docdent/pipe/README.md

# pipe
Midi pipe organ controller

Firmware for key processing of pipe organ that uses electric contacts
Hardware based on arduino mega
