docdent/pipe/docs/MidiProcessing V0.62.pdf

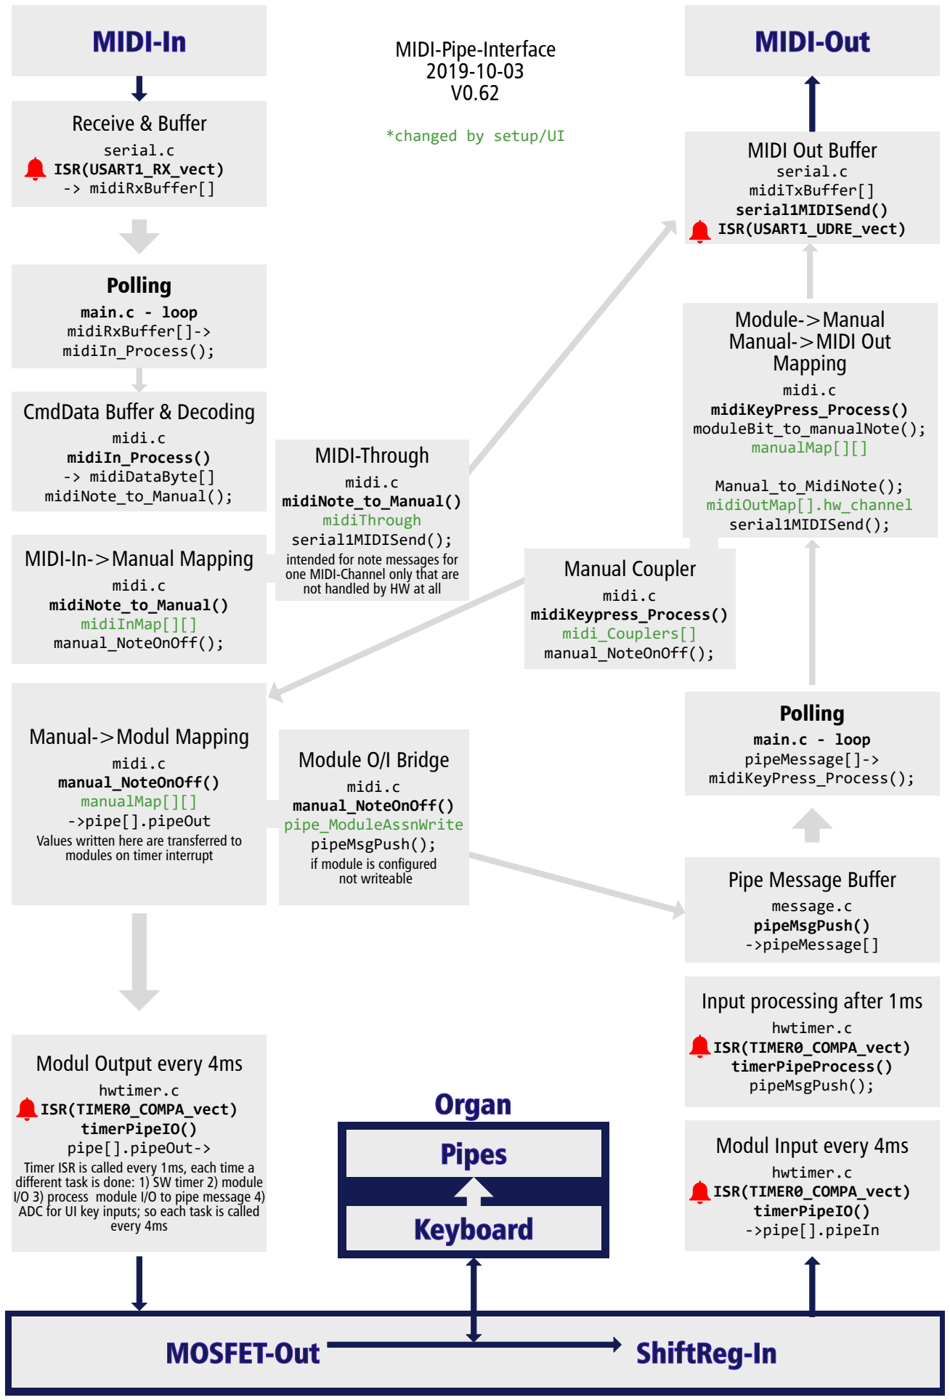
[picture p1: figure]
MIDI-In; MIDI-Out; MOSFET-Out; Pipes; Keyboard; ShiftReg-In; MIDI-In->Manual Mapping; midi.c midiNote_to_Manual() midiInMap[][] manual_NoteOnOff();; Manual->Modul Mapping; midi.c manual_NoteOnOff() manualMap[][] ->pipe[].pipeOut Values written here are transferred to modules on timer interrupt; Modul Output every 4ms; hwtimer.c ISR(TIMER0_COMPA_vect) timerPipeIO() pipe[].pipeOut->; every 4ms; Modul Input every 4ms; hwtimer.c ISR(TIMER0_COMPA_vect) timerPipeIO() ->pipe[].pipeIn; Input processing after 1ms; hwtimer.c ISR(TIMER0_COMPA_vect) timerPipeProcess() pipeMsgPush();; Pipe Message Buffer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

Timer ISR is called every 1ms, each time a different task is done: 1) SW timer 2) module I/O 3) process module I/O to pipe message 4) ADC for UI key inputs; so each task is called

Module Note: Due to HW design MOSFET activitation is treated as key press in SW, so processing continues here to upper right side
