docdent/pipe/docs/stuff/Din Lesewerte vom Pipie-Modul.xlsx

Modul vorhanden | OE | Dout | Magnet vorh | Taste gedr | Din(0-31) | Din(32)
nein | X | X | - | - | 1 | 1 | wenn pullup an Din
ja | 0 | X | 0 | 0 | 0 | immer 0
 | 0 | X | 0 | 1 | 1
 | 0 | X | 1 | 0 | 0
 | 0 | X | 1 | 1 | 1
 | 1 | 0 | X | X | 1
 | 1 | 1 | X | X | 1
