docdent/pipe/docs/Schematics/Pipe Block Diagram.pdf

## Block Diagram

2020-06-23

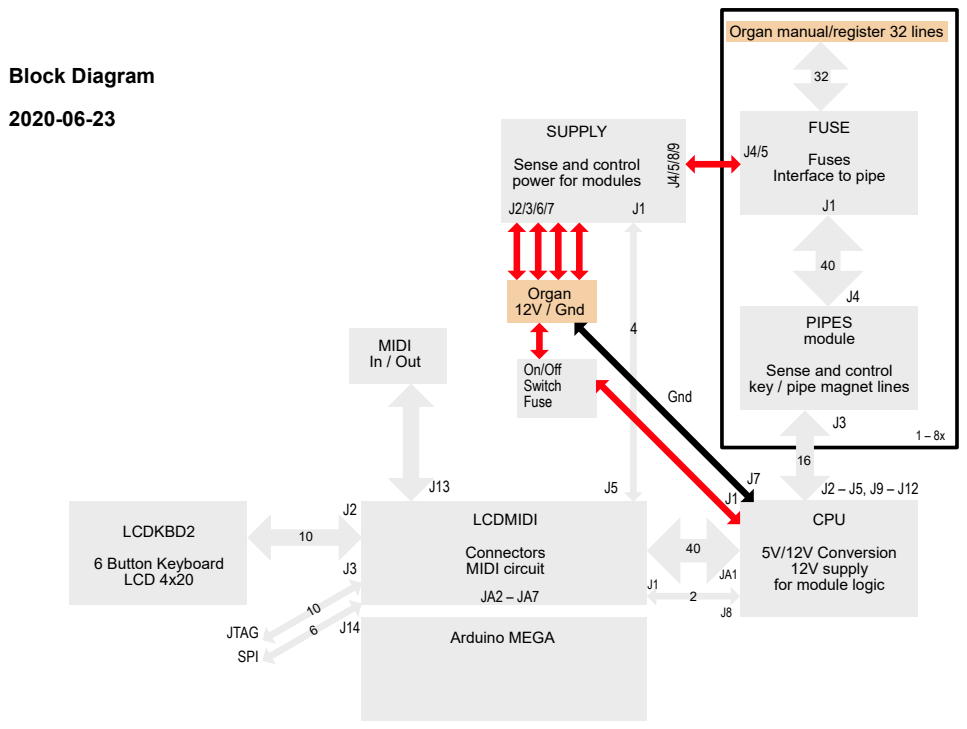
[picture p2: page 1]

Organ manual/register 32 lines

Sense and control
key / pipe magnet lines
