docdent/pipe/docs/Schematics/CPU1.6.pdf

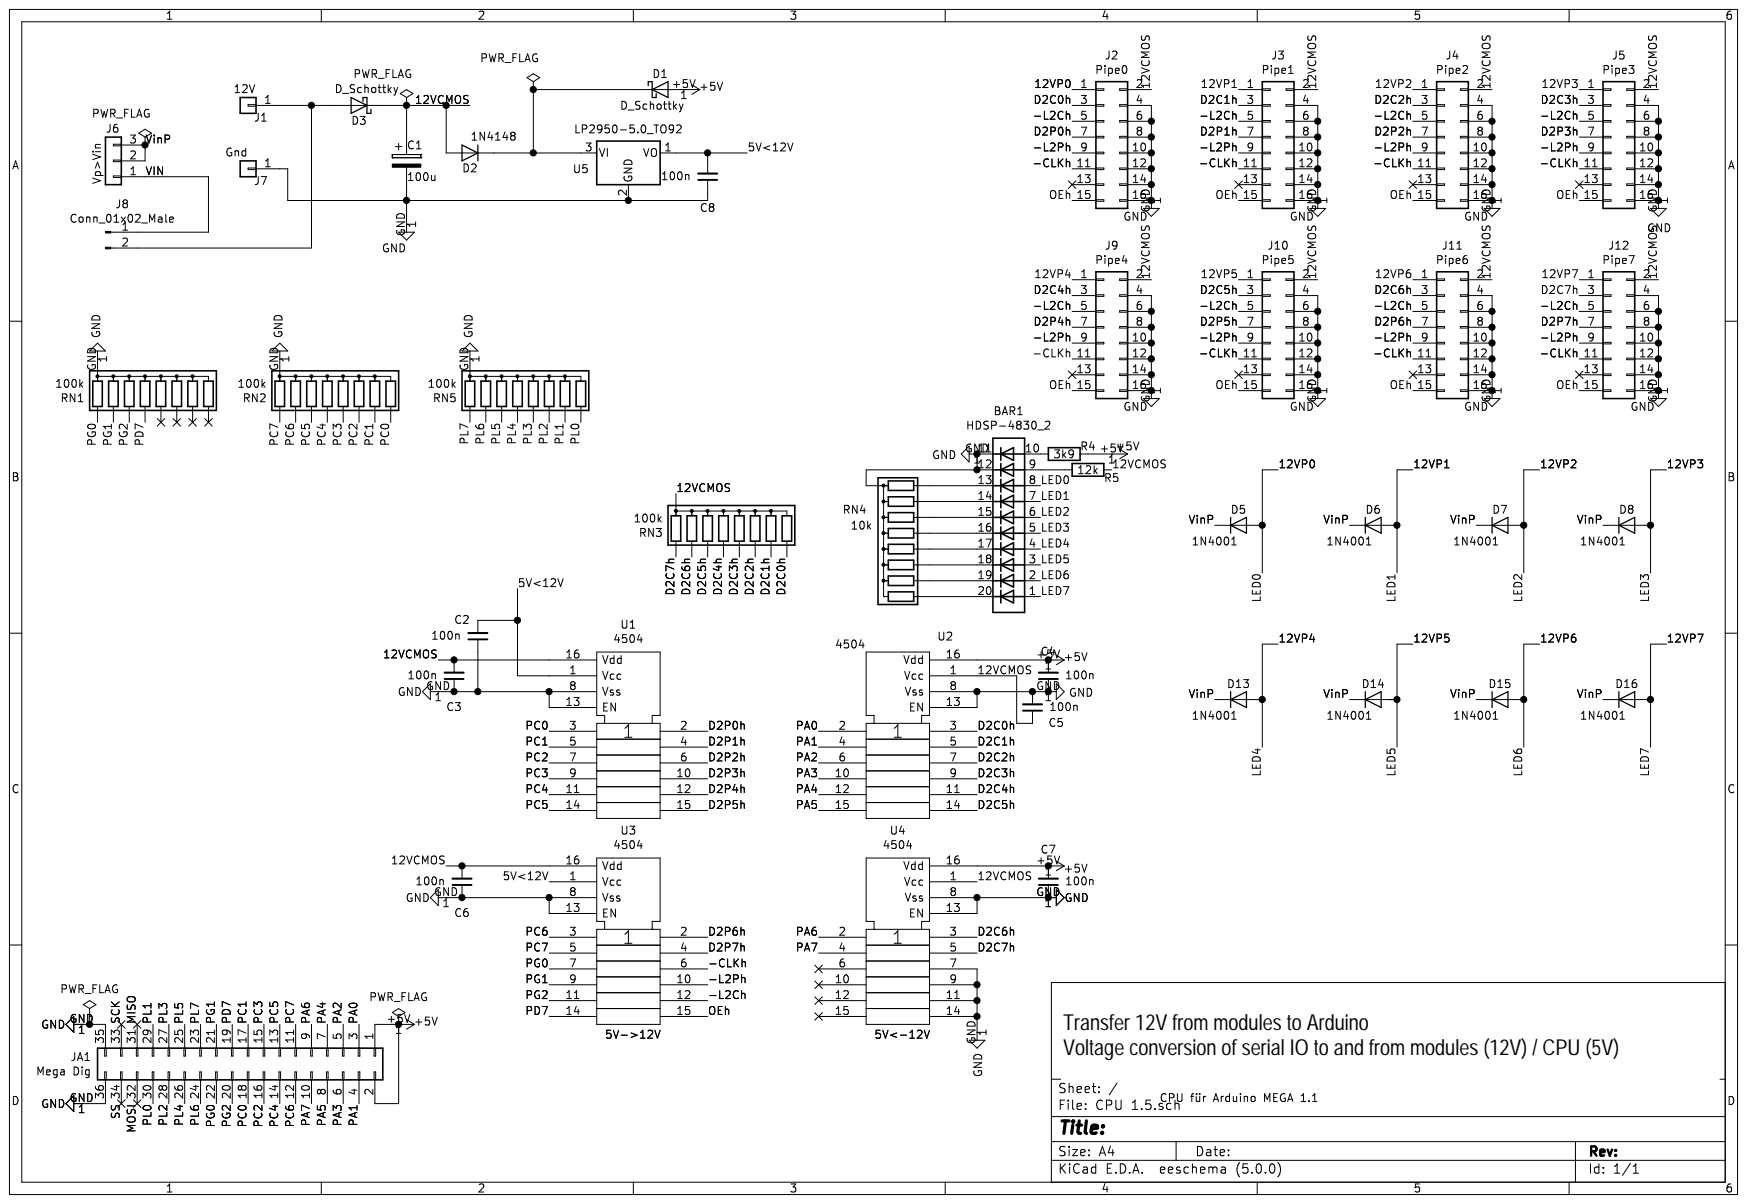
[picture p3: page 1]
