docdent/pipe/docs/Schematics/LCDMIDI.pdf

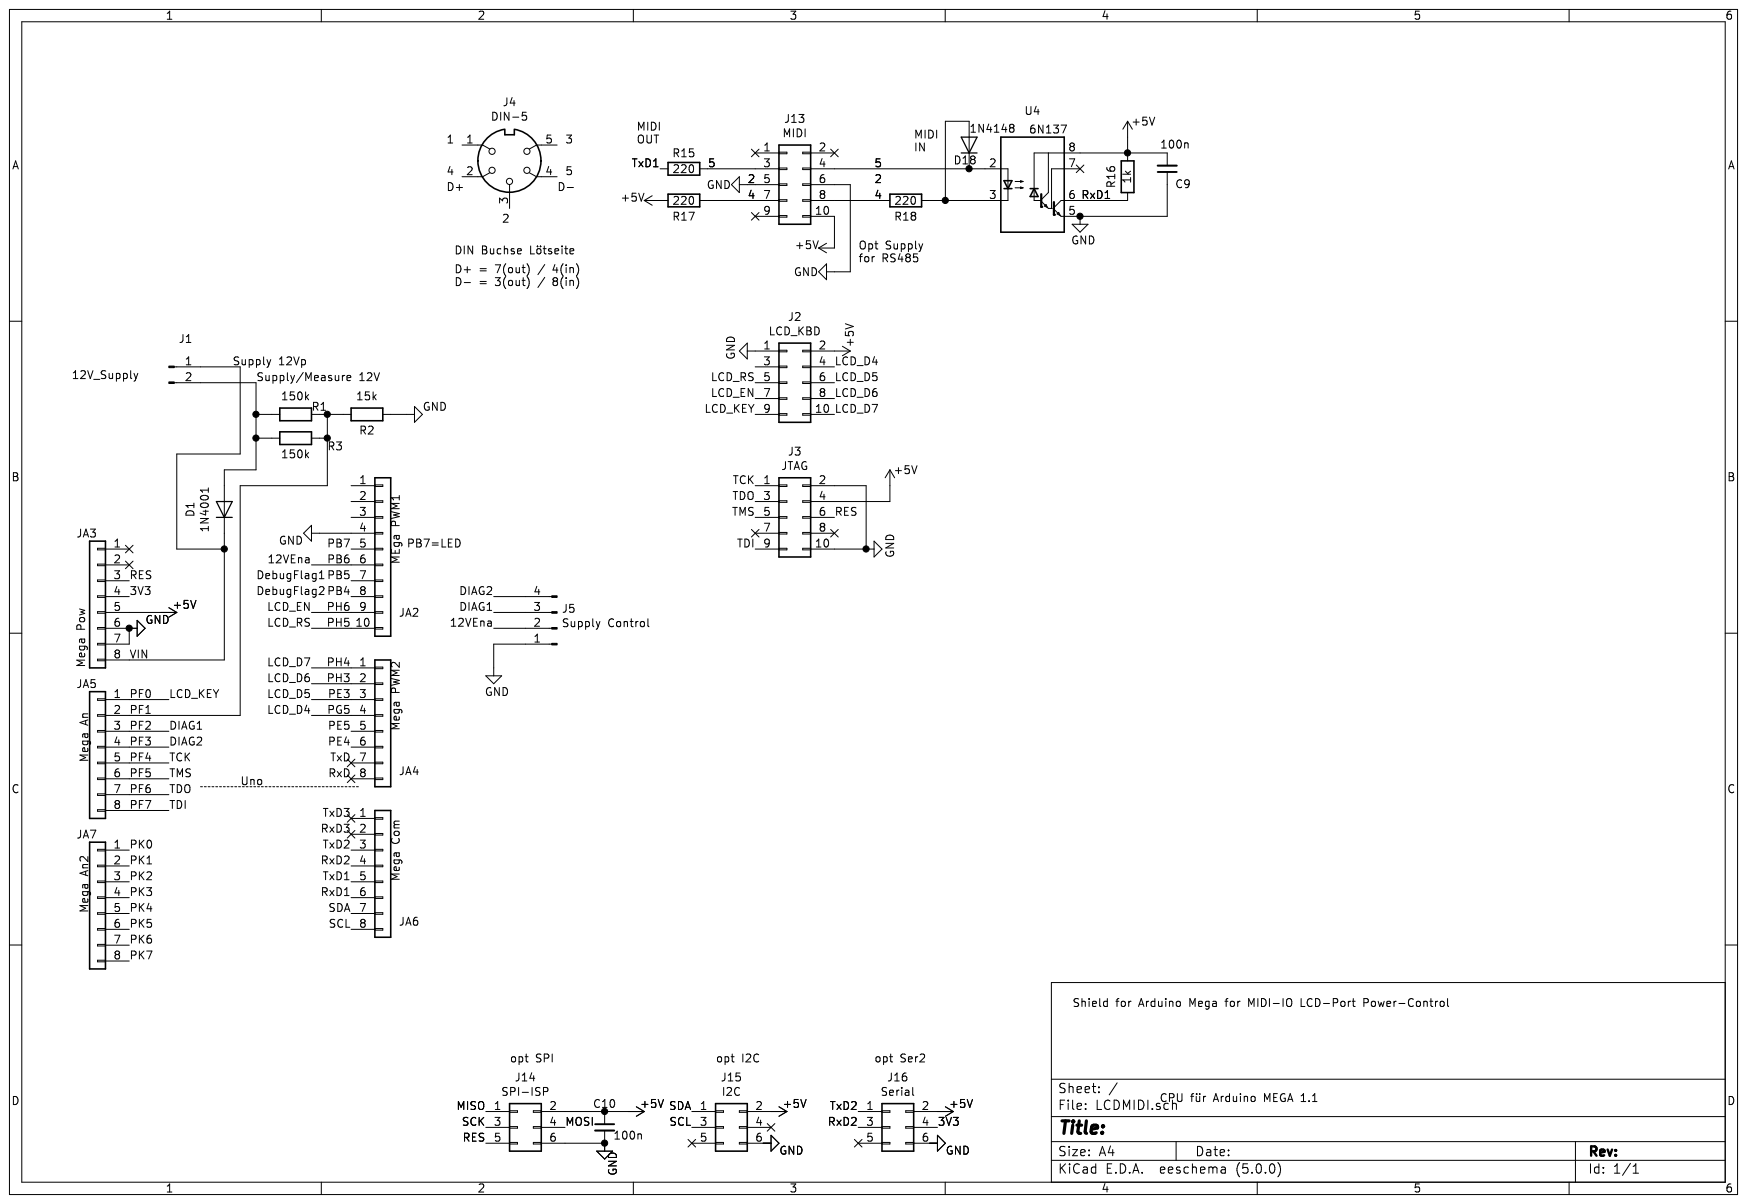
[picture p4: page 1]
