docdent/pipe/docs/Schematics/FUSE.pdf

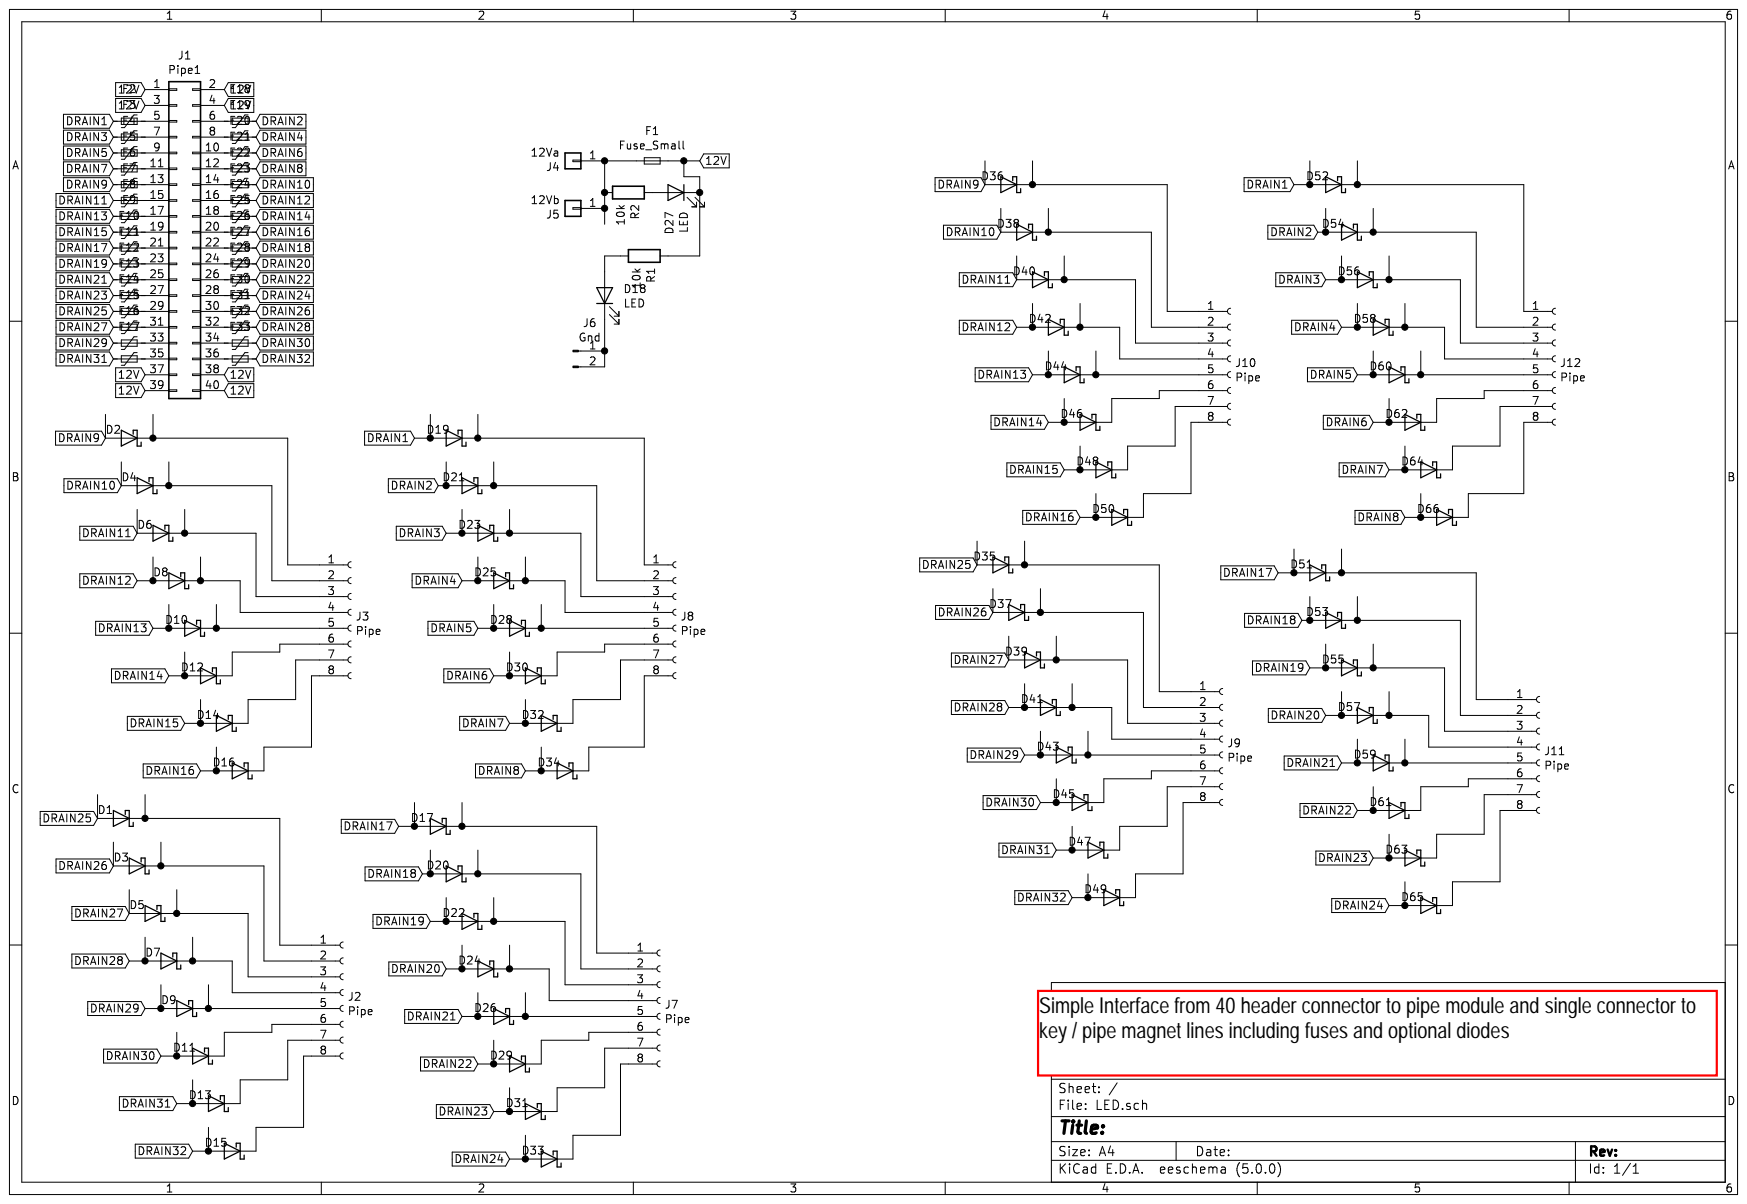
[picture p5: page 1]
