docdent/pipe/docs/Schematics/LCD_KBD2.pdf

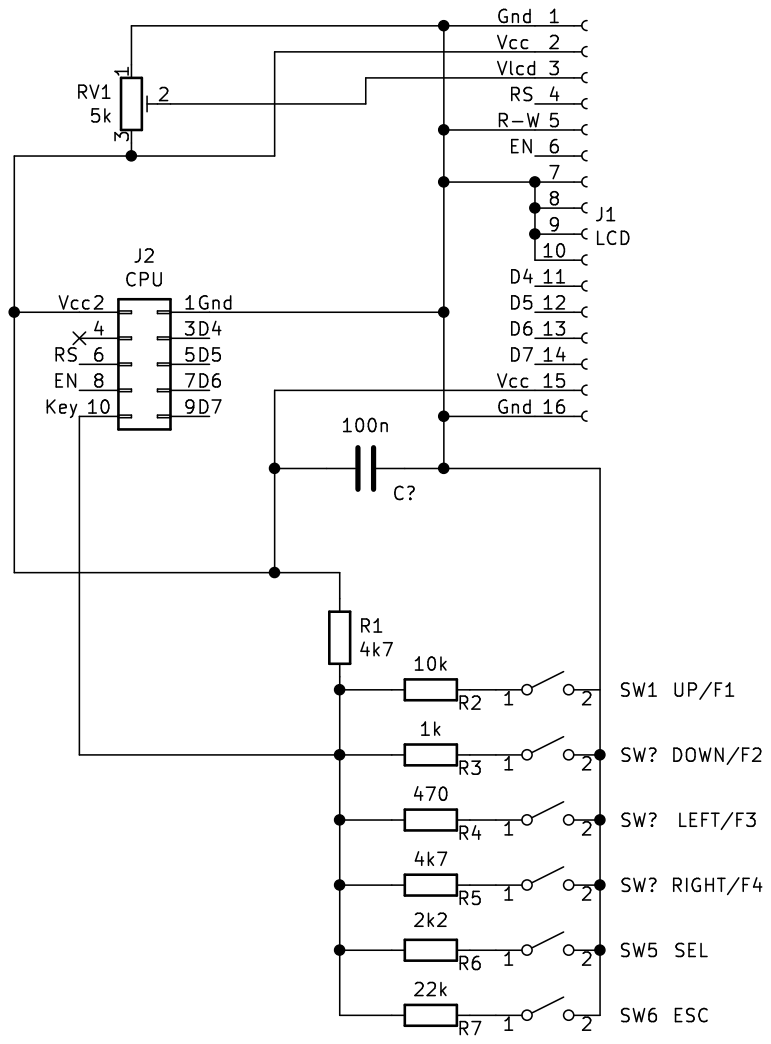
[picture p6: page 1]
