docdent/pipe/docs/Schematics/Pipes17.pdf

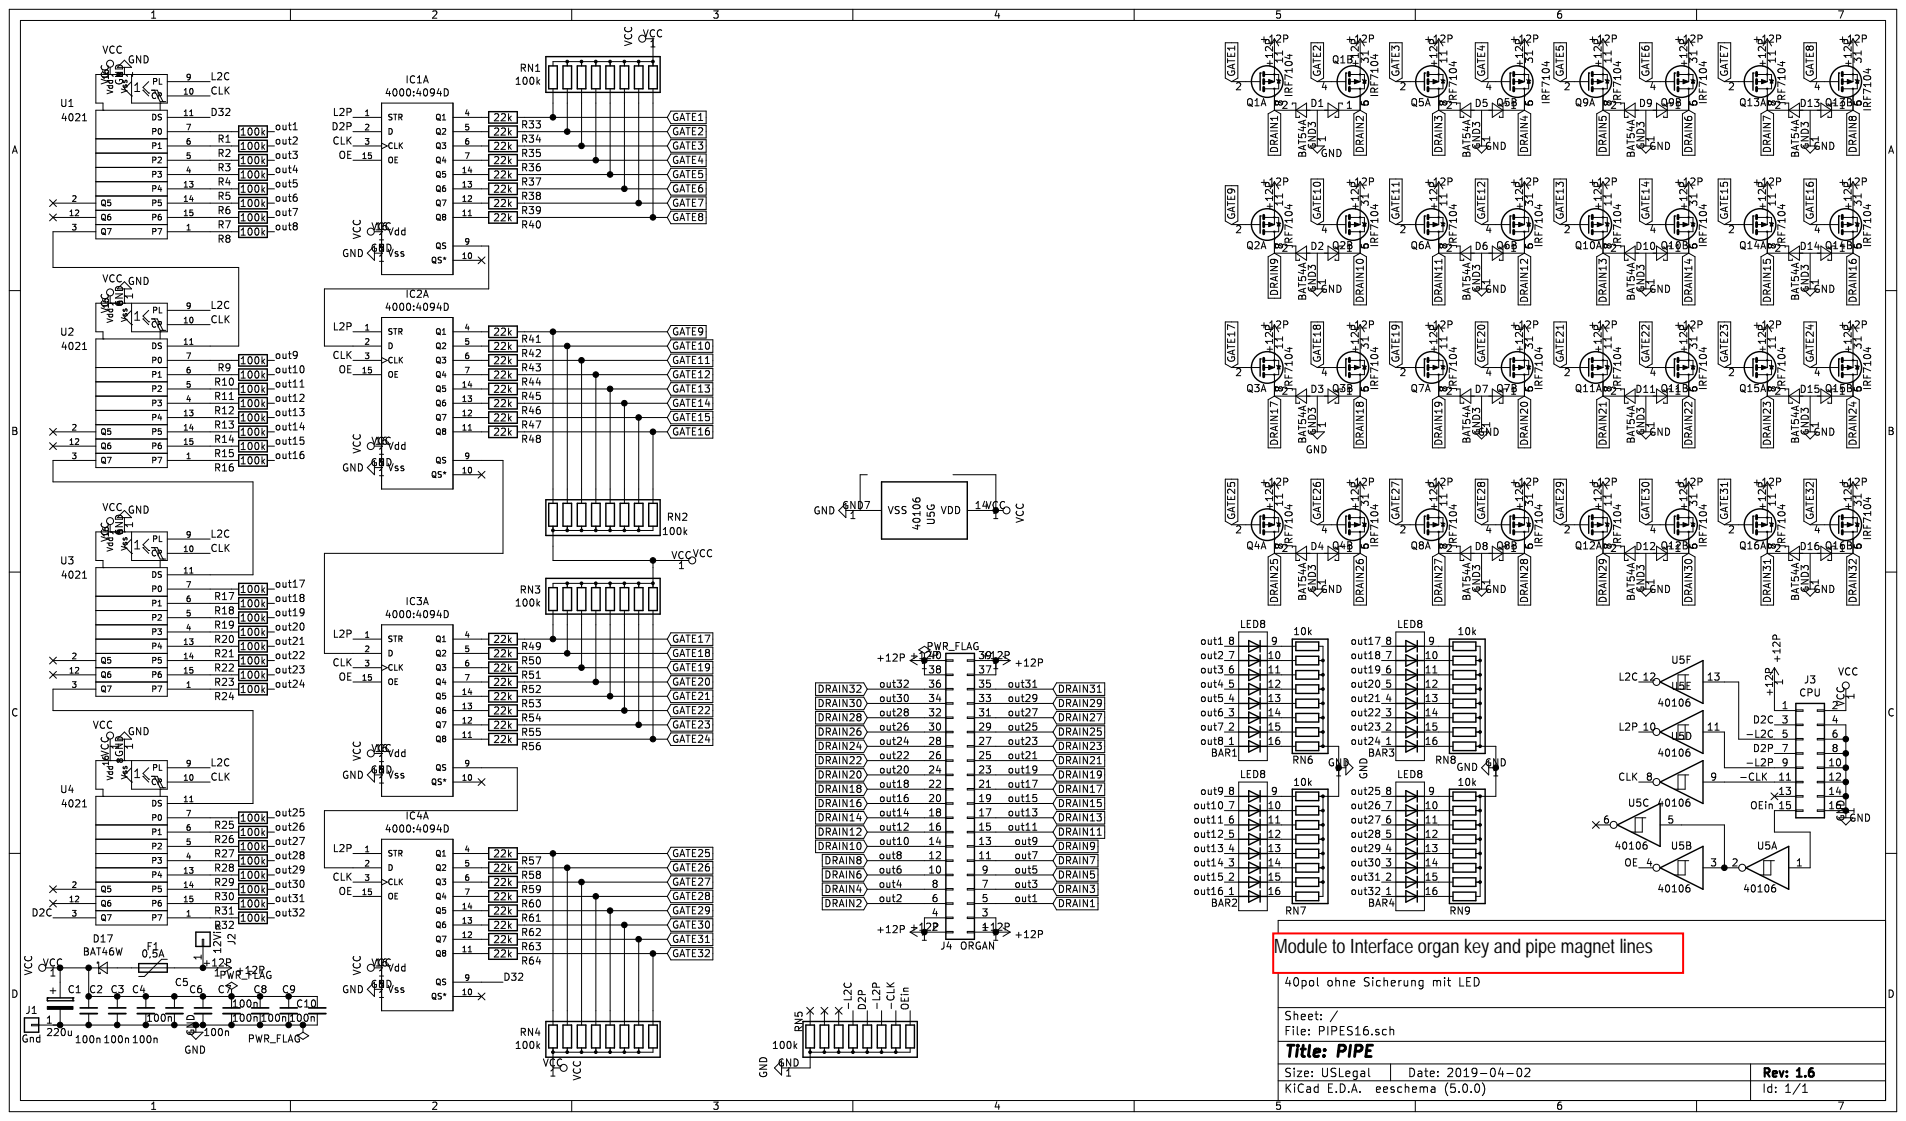
[picture p7: page 1]
