docdent/pipe/docs/Schematics/SUPPLY.pdf

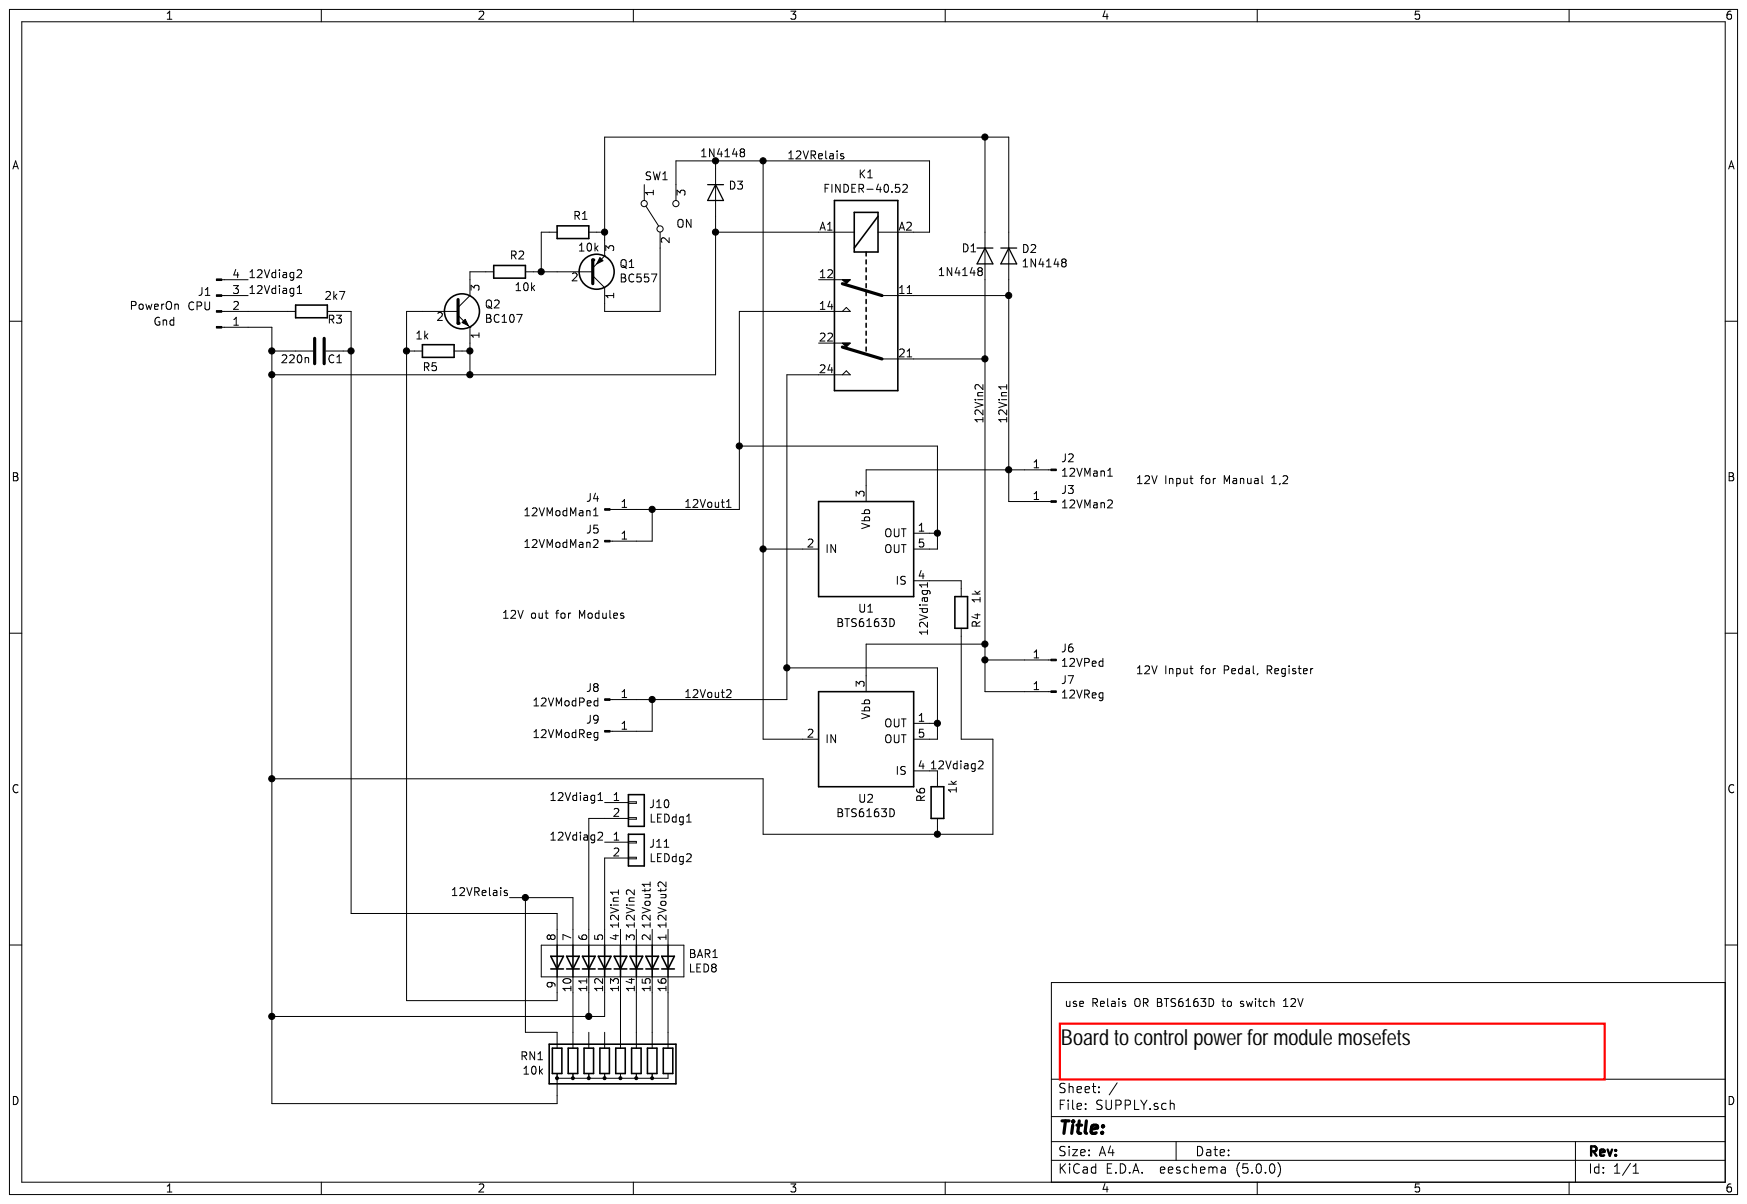
[picture p8: page 1]
