docdent/pipe/Pipe1/Midi.c

/* Midi.c
 *
 * Created: 31.01.2019 13:32:04
 *  Author: Anwender
 * Does processing of midi messages to and organ key messages from organ - handling bytes is not done here (->serial.c)
 */

#include <util/delay.h>
#include <avr/io.h>
#include <avr/interrupt.h>

#include "lcd_u.h"
#include "initio.h"
#include "message.h"
#include "hwtimer.h"
#include "utils.h"
#include "serial.h"
#include "test.h"
#include "Midi.h"
#include "ee_prom.h"
#include "log.h"




//-------------------------------------------------- V A R S ---------------------------------------


uint8_t midi_Couplers[COUPLER_COUNT];
const __flash CplInfo_t cplInfo[COUPLER_COUNT] = {
	// list of all couplers with destination and source manual
	{MANUAL_II, MANUAL_III},
	{MANUAL_I, MANUAL_III},
	{MANUAL_I, MANUAL_II},
	{MANUAL_P, MANUAL_III},
	{MANUAL_P, MANUAL_II},
	{MANUAL_P, MANUAL_I},
	{MANUAL_III, MANUAL_II},
	{MANUAL_III, MANUAL_I},
	{MANUAL_II, MANUAL_I},
	{MANUAL_III, MANUAL_P},
	{MANUAL_II, MANUAL_P},
	{MANUAL_I, MANUAL_P}
};

ManualMap_t manualMap[MANUAL_COUNT][RANGE_COUNT];
ManualNoteRange_t ManualNoteRange[MANUAL_COUNT];
MidiInMap_t midiInMap[MIDI_CHANNEL_COUNT][MIDI_SPLIT_COUNT];
MidiOutMap_t midiOutMap[MANUAL_COUNT];
uint8_t midiRxActivceSensing = 0;
MidiSetting_t midi_Setting; // active sense, sendVelocity=0 instead of NoteOff
uint8_t midiEEPromLoadError = EE_LOAD_OK;
RegisterMap_t registerMap[REGISTER_SEC_COUNT]; // for each Register section contains regStart, regEnd, modulBit
uint8_t registerCount; // nr of valid registers
ProgramInfo_t programMap[PROGRAM_COUNT]; // for each register one bit
MidiThrough_t midiThrough;
uint8_t midi_RegisterChanged; // for LCD Status
MidiCCreg_t midi_ccReg; // store MIDI CC number for register on/off midi commands

// ------------------------------------ M I D I   G E N E R A L --------------------------------------

void init_Midi(){
	midi_CouplerReset();
	prog_Display = PROGR_NONE;
	prog_UpdDisplay = FALSE;
}

void midi_CouplerReset(){
	// turn off all 12 couplers
	uint8_t* pCoupler = midi_Couplers;
	for (uint8_t i = 0; i < COUPLER_COUNT; i++){
		*pCoupler++ = 0;
	}
}

// ------------------------------------ C O U P L E R   S E T ---------------------------------

uint8_t set_Coupler(uint8_t cplNr){
	// returns MANUAL (!) if corrsponding inverse coupler had to be turned off, or MANUAL_NONE if no manual should be turned off
	if (cplNr < COUPLER_COUNT){
		midi_Couplers[cplNr] = COUPLER_ON;
		// calculate inverse Coupler in cplNr
		if (cplNr >= COUPLER_COUNT/2){
			// 6...11 -> 0...5
			cplNr = cplNr - COUPLER_COUNT/2;
		} else {
			// 0...5 -> 6...11
			cplNr = cplNr + COUPLER_COUNT/2;
		}
		if (midi_Couplers[cplNr] != 0){
			// reset inverse coupler and notify caller
			midi_Couplers[cplNr] = COUPLER_OFF;
			return cplInfo[cplNr].dest; // note to caller that this destination manual should be turned off
		}
	}
	return MANUAL_NONE;
}

Word_t getAllCouplers(){
	Word_t result;
	result.wordval = 0;
	uint8_t cplNr = COUPLER_COUNT-1;
	do
	{
		result.wordval = result.wordval << 1;
		if (midi_Couplers[cplNr] == COUPLER_ON) {
			result.byteval[0] |= 1; // LSB -> 1
		}
	} while (cplNr-- > 0);
	return result;
}

void setAllCouplers(Word_t couplers){
	uint8_t cplNr = 0;
	do
	{
		if ((couplers.byteval[0] & 0x01) != 0){
			midi_Couplers[cplNr] = COUPLER_ON;
		} else {
			midi_Couplers[cplNr] = COUPLER_OFF;
		}
		couplers.wordval = couplers.wordval >> 1;
	} while (++cplNr < COUPLER_COUNT);
}
//------------------------------------- M I D I    P R O C E S S I N G ---------------------------------

uint8_t midiLastCommand;
uint8_t midiDataByte[MIDI_MAX_INTERESTING_BYTES]; // max processed data bytes
uint8_t midiDataByteCount;
uint8_t midiDataByteExpected = MIDI_IGNORE_DATA; // Trigger processing after n received bytes - only proccesed commands!

uint8_t midiLastOutNote = MIDI_NOTE_NONE;
uint8_t midiLastOutManual = MANUAL_NONE;
uint8_t midiLastInNote = MIDI_NOTE_NONE; // written by midi.c read by main for debugging/display
uint8_t midiLastInChannel = MANUAL_NONE;
uint8_t midiLastInManual = MANUAL_NONE; // written by midi.c read by main for debugging/display
uint8_t midiLastProgram = MIDI_PROGRAM_NONE;


void manual_NoteOnOff(uint8_t manual, uint8_t note, uint8_t onOff);

//--------------------------------- G L O B A L   M I D I  M E S S A G E S ----------------------------------

void midiAllReset(){
	pipeProcessing = PIPE_IO_DISABLE; // do not process pipe[] now
	init_Pipe(); // defines IO, resets pipe[], here pipeProcessing will be activated again
}

void midiAllNotesOff(uint8_t channel){
	uint8_t splitRange = 0;
	while (splitRange < MIDI_SPLIT_COUNT){
		uint8_t manual = midiInMap[channel][splitRange].manual;
		// for all split ranges
		if (manual < MANUAL_COUNT) {
			// this splt range is assigned to a manual
			uint8_t note = midiInMap[channel][splitRange].manualNote; // start with this note
			// for all notes in split range
			for (uint8_t i = midiInMap[channel][splitRange].noteRange; i > 0; i--){
				manual_NoteOnOff(midiInMap[channel][splitRange].manual, note++, NOTE_OFF | NOTE_NOREDIRECT);
			}
			uint8_t midiChanel = midiOutMap[manual].hw_channel;
			if (midiChanel <= MIDI_CHANNEL_MAX){
				// valid channel, send all notes off
				serial1MIDISendCmd(MIDI_CTRLCHG, midiChanel);
				serial1MIDISendData(MIDI_CTRL_ALLNOTESOFF);
				serial1MIDISendData(0);

			}
		}
		// V 0.69 send all notes off to out channel of that manual
		// caution: all notes off ist sent to midi out even if multiple note off are also sent by HW via pipe_message
		// all notes off on midi out is not limited to note range of split range
		splitRange++;
	}
}

void midi_ManualOff(uint8_t manual){
	// turn all notes off of this manual
	if ((manual < MANUAL_COUNT) && (ManualNoteRange[manual].startNote != MIDI_NOTE_NONE) && (ManualNoteRange[manual].endNote != MIDI_NOTE_NONE)){
		for (uint8_t note = ManualNoteRange[manual].startNote; note <= ManualNoteRange[manual].endNote; note++){
			manual_NoteOnOff(manual,note,NOTE_OFF | NOTE_NOREDIRECT);
		}
	}
	// V 0.69 send all notes off to out channel of that manual
	uint8_t midiChanel = midiOutMap[manual].hw_channel;
	if (midiChanel <= MIDI_CHANNEL_MAX){
		// valid channel, send all notes off
		serial1MIDISendCmd(MIDI_CTRLCHG,midiChanel);
		serial1MIDISendData(MIDI_CTRL_ALLNOTESOFF);
		serial1MIDISendData(0);
	}
}

void midi_AllManualsOff(){
	for (uint8_t manual = 0; manual < MANUAL_COUNT; manual++){
		midi_ManualOff(manual);
	}
}

//----------------------------- A C T I V E   S E N S E ----------------------------------

void midi_CheckRxActiveSense(){
	if (midiRxActivceSensing != 0){
		// only when activated
		if (TIMER_ELAPSED(TIMER_ACTIVESENSE)) {
			// watchdog for active sense is elapsed: shut down outputs!
			midi_AllManualsOff();
			midiRxActivceSensing = 0; // turn off active Sense
		}
	}
}

void midi_CheckTxActiveSense(){
	// timer is started when any midi byte is transferred
	// dual use: 1) send active sense (if configured) after timer elapsed 2) reset last midi command so that from time to time command is sent again  (V0.67)
	if (!(TIMER_RUNNING(TIMER_TX_ACTIVESENSE))){
		// timer ended or not yet running
		TIMER_SET(TIMER_TX_ACTIVESENSE,TIMER_TX_ACTIVESENSE_MS)
		if (midi_Setting.TxActivceSense) {
			midi_SendActiveSense();
		}
		// V 0.67 for safety: reset last command byte so that after "some" time without key change always sent midi command byte
		MIDI_TX_RESET_LASTCMD
	}

}

// **************************************** P R O C E S S   M I D I    I N *********************************************

void midiInSysEx(){
	// process Sysex after receiving ENDSYSEX
	if ((midiLastCommand == MIDI_SYSEX) && (midiDataByte[0] == MIDI_RX_SYSEX_HEADER0)){
		// SysEx Command for our device
		if (((midiDataByte[1] & 0xF0) == MIDI_MYSYSEX_REGISTER_ON) || ((midiDataByte[1] & 0xF0) == MIDI_MYSYSEX_REGISTER_OFF)){
			// ATTENTION: Midi Channel is ignored by & 0xF0
			// SysexCmd is register on off but first check follwing data
			if ((midiDataByte[3] == MIDI_MYSYSEX_REGISTER_HEADER) && (midiDataByteCount == 4)) {
				// only if exactly 4 bytes and register MSB is our arbitrary trigger byte
				// ---> turn on/off register
				register_onOff(midiDataByte[3], ((midiDataByte[1] & 0xF0) == MIDI_MYSYSEX_REGISTER_ON) ? REGISTER_ON : REGISTER_OFF);
			}
		}
		// Append other SysEx commands here with "else if"
	}
}

void midiIn_Process(uint8_t midiByte){
	// commands are stored in midiLastCommand and set number of expected data bytes in midiDataByteExpected
	// processing is usually done after number of data bytes has been received
	if (midiByte > 0x7f) {
		// command
		// define data bytes that are awaited (max. - less is possible)
		if ((midiByte <= MIDI_REALTIME_LAST) && (midiByte >= MIDI_REALTIME_FIRST)){
			 // this is a real time message F8-FF: don't interrupt current stream processing
			if (midiByte == MIDI_ACTIVESENSING) {
				midiRxActivceSensing = 1; // start active sense
				TIMER_SET(TIMER_ACTIVESENSE,TIMER_ACTIVESENSE_MS) // and start timer. main must check if it has elapsed
			} else if (midiByte == MIDI_RESET){
				midiAllReset();
			}
			// if not active sense or reset: ignore completely!
		} else {
			// only store if non real time message
			midiLastCommand = midiByte;
			midiDataByteCount = 0; // reset received data
			if ((midiByte >= MIDI_NOTEOFF) && (midiByte  <= (MIDI_CTRLCHG | 0x0F))) {
				// 80 - BF -> Note On, Note Off, Aftertouch, ControlerChange
				midiDataByteExpected = 2;
			} else if ((midiByte >= MIDI_PITCHBEND) && (midiByte  <= (MIDI_PITCHBEND | 0x0F))) {
				// E0 - EF
				midiDataByteExpected = 2;
			} else if (midiByte == MIDI_SONGPOS) {
				// F2
				midiDataByteExpected = 2;
			} else if (midiByte == MIDI_SYSEX) {
				// F0
				midiDataByteExpected = MIDI_IGNORE_DATA; // wait for next cmd, Data are stored but ignored in data processing
			} else if ((midiByte >= MIDI_PRGCHG) && (midiByte  <= (MIDI_CHANAFFT | 0x0F))) {
				// C0 - DF
				midiDataByteExpected = 1;
			} else if ((midiByte == MIDI_TIMECODE) || (midiByte == MIDI_SONGSEL)){
				// F1, F3
				midiDataByteExpected = 1;
			} else if (midiByte == MIDI_ENDSYSEX) {
				// F7 EndOfSysEx -> process Sysex HERE !
			} else {
				// F4, F5 undefined, F6 tune request,
				midiDataByteExpected = 0;
				// TODO process these 1 byte commands here if interesting
			}
		}
	} else {
		// data
		if (midiDataByteCount < MIDI_MAX_INTERESTING_BYTES)	{
			// store databyte if space in array
			midiDataByte[midiDataByteCount++] = midiByte;
		}
		if (midiDataByteExpected != MIDI_IGNORE_DATA) {
			// only if data shall be processed
			if (midiDataByteCount >= midiDataByteExpected) {
				// command complete ---> process Input
				if (midiLastCommand < MIDI_SYSEX) {
					// channel contained in command
					uint8_t channel = midiLastCommand & 0x0F;
					uint8_t noteOnOff;
					switch (midiLastCommand & 0xF0) {
					// remove channel from command
					case MIDI_NOTEOFF:
						noteOnOff = NOTE_OFF;
						midiNote_to_Manual(channel, midiDataByte[0], noteOnOff);
						break;
					case MIDI_NOTEON:
						if (midiDataByte[1] == 0) {
							// midi spec: velocity = 0 -> note off
							noteOnOff = NOTE_OFF;
						} else {
							// regular: note on
							noteOnOff = NOTE_ON;
						}
						midiNote_to_Manual(channel, midiDataByte[0], noteOnOff);
						break;
					case MIDI_CTRLCHG:
						if (midiDataByte[0] == MIDI_CTRL_ALLNOTESOFF) {
							midiAllNotesOff(channel);
						} else if (midiDataByte[0] == midi_ccReg.ccInRegOn) {
							// V 0.83: register on/off by CC
							register_onOff(midiDataByte[1], REGISTER_ON);
						} else if (midiDataByte[0] == midi_ccReg.ccInRegOff) {
							register_onOff(midiDataByte[1], REGISTER_OFF);
						} else if (midiDataByte[0] == MIDI_CTRL_ALLCTRLOFF){
							midi_resetRegisters();
						}
						break;
					case MIDI_PRGCHG:
						midi_ProgramChange(channel,midiDataByte[0]);
						break;
					// TODO process commands with data bytes here
					}
					// no else beacuse from SYSEX there are not morebyte commands beeing processed
				}
				// command is processed
				midiDataByteCount = 0; // reset for further Data with same command
			}
		}
	}
}

void proc_ESPmidi(uint8_t midiBytesTransferred){
	// ESP midi commands are execeuted here separately from regular midi input so that processing does not interfere
	// serESPMidiTmp[2] is first byte of midi transmission if there are 3 bytes, [1] for 2 byte commands
	(void) midiBytesTransferred; // currently not used, unused bytes are zero
	uint8_t channel = serESPMidiTmp[2] & 0x0F;
	uint8_t noteOnOff;
	switch (serESPMidiTmp[2] & 0xF0) {
		// remove channel from command
	case MIDI_NOTEOFF:
		noteOnOff = NOTE_OFF;
		midiNote_to_Manual(channel, serESPMidiTmp[1], noteOnOff);
		break;
	case MIDI_NOTEON:
		if (serESPMidiTmp[0] == 0) {
			// midi spec: velocity = 0 -> note off
			noteOnOff = NOTE_OFF;
		} else {
			// regular: note on
			noteOnOff = NOTE_ON;
		}
		midiNote_to_Manual(channel, serESPMidiTmp[1], noteOnOff);
		break;
	case MIDI_CTRLCHG:
		if (serESPMidiTmp[1] == MIDI_CTRL_ALLNOTESOFF) {
			midiAllNotesOff(channel);
		}
		break;
	// insert other 3 byte midi command check here
	case 0: // no 3 bytes of midi data, check next byte for 2 byte commands
		channel = serESPMidiTmp[1] & 0x0F;
		switch (serESPMidiTmp[1] & 0xF0) {
		case MIDI_PRGCHG:
			midi_ProgramChange(channel,serESPMidiTmp[0]);
			break;
		//  process midi commands from ESP with 2 bytes here
		}
		break;
	}
}

//-------------------------------------- R E G I S T E R  ---------------------------------------------
// valid register are 0...63 !
// valid programs are 0...63

void registers_CalcCount(){
	uint8_t count = 0;
	for (uint8_t regSec = 0; regSec < REGISTER_SEC_COUNT; regSec++){
		if ((registerMap[regSec].endReg != REGISTER_NONE) && (registerMap[regSec].endReg >= count)){
			// endReg == 0xFF -> ignore, endReg == 0 -> count=1
			count = registerMap[regSec].endReg+1;
		}
	}
	registerCount = count;
}

void init_Registers(){
	// init programs to null
	// init registerMap to null
	midi_RegisterChanged = REGISTER_NONE;
	// try to get register map from eeprom
	for (uint8_t regSec = 0; regSec < REGISTER_SEC_COUNT; regSec++){
		registerMap[regSec].startReg = REGISTER_NONE; // CAUTION register == 0xFF -> no register
		registerMap[regSec].endReg = REGISTER_NONE;
		registerMap[regSec].bitStart = 0;
	}
	if (eeprom_ReadReg() == EE_LOAD_ERROR){
		registerCount = 0;
		log_putError(LOG_CAT_EE,LOG_CATEE_REGISTER,0);
	} else {
		registers_CalcCount(); // registers are loaded from init or eeprom, now get count
	}
	// try to get programs
	if (eeprom_ReadProg() == EE_LOAD_ERROR){
		// load error, reset programs
		for (uint8_t progNr = 0; progNr < PROGRAM_COUNT; progNr++){
			for (uint8_t regNr = 0; regNr < (REGISTER_COUNT / 8); regNr++) {
				programMap[progNr].registers[regNr] = 0;
			}
			programMap[progNr].couplers = 0;
		}
		log_putError(LOG_CAT_EE,LOG_CATEE_PROGRAM,0);
	}
	// try to get MIDI cc for Register On/Off
	if (eeprom_ReadCCreg() == EE_LOAD_ERROR){
		midi_ccReg.ccInRegOff = 0xFF;
		midi_ccReg.ccInRegOn = 0xFF;
		midi_ccReg.ccOutRegOff = 0xFF;
		midi_ccReg.ccOutRegOn= 0xFF;
		log_putError(LOG_CAT_EE,LOG_CATEE_CCREG,0);
	}
}

ModulBitError_t regNr_to_moduleBit(uint8_t regNr){
	// returns module+bit_nr in lowByte or 0xFF in HiByte if Note ist not implemented
	ModulBitError_t result;
	if ((regNr < registerCount) && (regNr < REGISTER_COUNT)) {
		// valid regNr
		RegisterMap_t *pRange;
		pRange = &(registerMap[0]); // check all Ranges
		uint8_t i = REGISTER_SEC_COUNT;
		do {
			if ((regNr >= pRange->startReg) && (regNr <= pRange->endReg)) {
				// found in this range
				result.error = MODULE_NOERROR;
				result.moduleBit = pRange->bitStart + (regNr - pRange->startReg);
				return (result);
			}
			pRange++;
		} while (--i > 0);
	}
	// when we are here: none off the defined ranges contained register
	result.error = MODULE_ERROR;
	return (result);
}

uint8_t moduleBit_to_registerNr(uint8_t modulebit){
	RegisterMap_t * pSection = & (registerMap[0]);
	for (uint8_t section = 0; section < REGISTER_SEC_COUNT; section++){
		if ((modulebit >= pSection->bitStart) && (modulebit <= pSection->bitStart + pSection->endReg - pSection->startReg)) {
			// found
			return pSection->startReg + (modulebit - pSection->bitStart);
		}
	}
	return REGISTER_NONE;
}

uint8_t read_Register(uint8_t regNr, uint8_t mode){
	// mode: REGISTER_READ_HWIN, REGISTER_READ_SWOUT, REGISTER_READ_ALL
	// result: 0x01: REGISTER_ON, 0x00: REGISTER_OFF
	if (regNr < registerCount) {
		// valid register
		ModulBitError_t modBitComplette = regNr_to_moduleBit(regNr);
		if (modBitComplette.error == MODULE_NOERROR) {
			// register is assgined to module
			uint8_t modBit = modBitComplette.moduleBit;
			uint8_t bitNr = MODULE_BIT_TO_BIT(modBit);
			uint8_t modulNr = MODULE_BIT_TO_MODULE(modBit);
			uint8_t mask = 1 << modulNr;
			if (((pipe[bitNr].pipeOut & mask) == 0) && ((mode & REGISTER_READ_SWOUT) != 0)) {
				// read sw output and output is L (active)
				return REGISTER_ON;
			} else if (((pipe[bitNr].pipeIn & mask & pipe_Module.AssnRead) != 0) && ((mode & REGISTER_READ_HWIN) != 0)) {
				// read hw input and Input is H (active) AND module is assigned readable V 0.74
				// result ON if output is H (works with disconnected HW or input is H
				return REGISTER_ON;
			} else if (((pipe[bitNr].pipeOut & mask) != 0) && ((pipe[bitNr].pipeIn & mask & pipe_Module.AssnRead) != 0) && (mode == REGISTER_READ_HWIN_XOR_SWOUT)){
				return REGISTER_ON;
				// sw out off and hw input on -> additional register manually active
			} else  {
				return REGISTER_OFF;
			}
		}
	}
	return REGISTER_OFF; // default for unassigned/invalid register
}

uint8_t get_RegisterStatus(uint8_t regNr){
	// result: REGISTER_READ_HWIN 0x01, REGISTER_READ_SWOUT 0x02; 0x00: REGISTER_OFF
	// V 0.78: return SW and HW out independently
	uint8_t result = 0;
	if (regNr < registerCount) {
		// valid register
		ModulBitError_t modBitComplette = regNr_to_moduleBit(regNr);
		if (modBitComplette.error == MODULE_NOERROR) {
			// register is assgined to module
			uint8_t modBit = modBitComplette.moduleBit;
			uint8_t bitNr = MODULE_BIT_TO_BIT(modBit);
			uint8_t modulNr = MODULE_BIT_TO_MODULE(modBit);
			uint8_t mask = 1 << modulNr;
			if ((pipe[bitNr].pipeOut & mask) == 0) {
				// read sw output is L (active)
				result |= REGISTER_READ_SWOUT;
			}
			if ((pipe[bitNr].pipeIn & mask & pipe_Module.AssnRead) != 0) {
				// V 0.74: valid input modules only if assigned to read!
				// read hw input and Input is H (active)
				// result ON if output is H (works with disconnected HW or input is H
				result |= REGISTER_READ_HWIN;
			}
		}
	}
	return result; // default for unassigned/invalid register
}


uint8_t count_Registers(uint8_t mode){
	uint8_t result = 0;
	for (uint8_t regNr = 0; regNr < REGISTER_COUNT; regNr++){
		if (read_Register(regNr, mode) != REGISTER_OFF ){
			result++;
		}
	}
	return result;
}

uint8_t read_allRegister(uint8_t* resultPtr){
	uint8_t result = 0;
	// read all registers to memory (no matter if hw inp or sw out)
	uint8_t mask = 0;
	for (uint8_t regNr = 0; regNr < REGISTER_COUNT; regNr++){
		// always read all registers, even if unassigned
		// begin with first register, bit 0
		if ((regNr & 0x07) == 0) {
			// reset mask every 8 bits, bit 0, 8, 16, 24
			mask = 0;
		}
		mask = (mask >> 1 );
		if (read_Register(regNr, REGISTER_READ_ALL) != REGISTER_OFF ){
			mask |= 0x80;
			result++;
		}
		if ((regNr & 0x07) == 0x07) {
			// bit 7, 15, 23, 31
			if (resultPtr != NULL) {
				*resultPtr++ = mask;
			}
		}
	}
	return result;
}


void register_onOff(uint8_t regNr, uint8_t onOff){
	// onOff: LSB==1: on, LSB==0: off
	if (regNr < registerCount) {
		// valid register
		ModulBitError_t modBitComplette = regNr_to_moduleBit(regNr);
		if (modBitComplette.error == MODULE_NOERROR) {
			// register is assigned to module
			uint8_t modBit = modBitComplette.moduleBit;
			uint8_t bitNr = MODULE_BIT_TO_BIT(modBit);
			uint8_t modulNr = MODULE_BIT_TO_MODULE(modBit);
			if ((onOff & 0x01) != 0){
				// set register -> output L
				pipe_on(bitNr,1 << modulNr); // bitNr 0..31, moduleMask 0x01, 0x02, ... x080
			} else {
				// reset register -> output H
				pipe_off(bitNr,1 << modulNr); // bitNr 0..31, moduleMask 0x01, 0x02, ... x080
			}
		}
	}
	// TODO Error Logging invalid register
}

uint8_t program_toRegister(uint8_t program){
	// Program 0..63
	uint8_t result = 0; // return nr of registers that are turned on by program
	if (program < PROGRAM_COUNT){
		prog_set(program); // for display in main
		uint8_t regBits;
		uint8_t regNr = 0;
		uint8_t *regBytePtr = &(programMap[program].registers[0]);
		for (uint8_t byteNr = 0; byteNr < (REGISTER_COUNT / 8); byteNr++){
			// 8 bytes for 64 registers
			// TODO process only implemented registers instead of all possible registers here
			regBits = *(regBytePtr++); // get adress for next 8 registers
			for (uint8_t bitNr = 0; bitNr < 8; bitNr++){
				if ((regBits & 0x01) != 0) {
					result++;
				}
				register_onOff(regNr, ((regBits & 0x01) == 0 ? REGISTER_OFF : REGISTER_ON)); // turn this register on/off according to lsb
				// not implemented registers are ignored by register_onOff
				regBits = regBits >> 1;
				regNr++;
			}
		}
		Word_t couplers;
		couplers.wordval = programMap[program].couplers;
		setAllCouplers(couplers);
	}
	return result;
}

void midi_ProgramChange(uint8_t channel, uint8_t program){
	if (midi_Setting.AcceptProgChange != FALSE){
		// V 0.59 program change may be ignored
		uint8_t channelValid = FALSE;
		// V 0.58 check MIDI Channel. Accept PC only when channel is in in midiInMap[] !
		for (uint8_t splitCount = 0; splitCount < MIDI_SPLIT_COUNT; splitCount++){
			if (midiInMap[channel][splitCount].manual != MANUAL_NONE){
				// in this section of midi channel a manual is assigned
				channelValid = TRUE;
				break;
			}
		}
		if (channelValid == TRUE) {
			// only if input channel is assigned to any manual
			program_toRegister(program);
			prog_set(program);
			midiLastProgram = program;
		}
	}
	// V 0.58 SW MIDI Through
	//if (channel == midiThrough.InChannel){
		// if IN Channel is matched (through OFF -> midiThrough.InChannel = 0xFF)
		if (midiThrough.OutChannel != MIDI_CHANNEL_NONE) {
			// only if out channel is valid: do as in midiKeyPress_Process
			serial1MIDISendCmd(MIDI_PRGCHG, midiThrough.OutChannel);
			// if note off: use note on an velocity = 0 to turn off note (less bytes !)
			serial1MIDISendData(program);
		}
	//} V 0.73 send program change to "thru" out always
}


void midi_resetRegisters(){
	for (uint8_t i = 0; i < registerCount; i++){
		prog_set(PROGR_NONE);
		register_onOff(i,REGISTER_OFF);
	}
}

uint8_t register_toProgram(uint8_t program, uint8_t SaveEEProm){
	// Program 0..63
	// saves current registers to program
	// V0.76 reset register ouptu first
	midi_resetRegisters();
	module_WaitOutputInput2Cycles(); // now register read input is HW register only
	uint8_t result = 0;
	if (program < PROGRAM_COUNT){
		uint8_t *regBytePtr = &(programMap[program].registers[0]);
		result = read_allRegister(regBytePtr);
	}
	programMap[program].couplers = getAllCouplers().wordval;
	if (SaveEEProm) {
		eeprom_UpdateProg();
	}
	return result;
}

uint8_t midi_RegisterMatchProgram(uint8_t program){
	// if program registers completely match current output returns number of additionally (manually) activated registers 0..64
	// if program register dont' match: returns 0xFF
	uint8_t result = 0;
	uint8_t* progPtr = &(programMap[program].registers[0]);
	uint8_t tempReg = 0; // just to get rid off warnung unit. var
	uint8_t actualReg;
	for (uint8_t i = 0; i < registerCount; i++){
		if ((i & 0x07) == 0) {
			// first bit in byte
			tempReg = * progPtr++;
		}
		actualReg = get_RegisterStatus(i);
		if ((tempReg & 0x01) != 0) {
			// this register should be set
			if (!(actualReg & REGISTER_READ_SWOUT)) {
				// output is not set by SW: return 0xFF
				return REG_DONT_MATCH_PROG;
			}
			// else: OK, register is set
		} else {
			// this register should not be set
			if (actualReg & REGISTER_READ_SWOUT) {
				// is set: return 0xFF
				return REG_DONT_MATCH_PROG;
			} else if (actualReg & REGISTER_READ_HWIN) {
				// is set by HW
				result++; // inc return val
			}
		}
		tempReg = tempReg >> 1;
	}
	return result;
}

uint8_t midi_CountRegisterInProgram(uint8_t program){
	// returns number of registers that are set in this program
	uint8_t result = 0;
	uint8_t* progPtr = &(programMap[program].registers[0]);
	uint8_t tempReg = 0; // just to get rid off warnung unit. var
	for (uint8_t i = 0; i < registerCount; i++){
		if ((i & 0x07) == 0) {
			// first bit in byte
			tempReg = * progPtr++;
		}
		if ((tempReg & 0x01) == 1) {
			result++;
		}
		tempReg = tempReg >> 1;
	}
	return result;

}

void midiSendRegOn(uint8_t regNr){
	if ((midi_ccReg.ccOutRegOn <= REGISTER_MAX_CC) && (midiThrough.OutChannel <= MIDI_CHANNEL_16)){
		serial1MIDISendCmd(MIDI_CTRLCHG,midiThrough.OutChannel);
		serial1MIDISendData(midi_ccReg.ccOutRegOn);
		serial1MIDISendData(regNr);
	}
}

void midiSendRegOff(uint8_t regNr){
	if ((midi_ccReg.ccOutRegOff <= REGISTER_MAX_CC) && (midiThrough.OutChannel <= MIDI_CHANNEL_16)){
		serial1MIDISendCmd(MIDI_CTRLCHG,midiThrough.OutChannel);
		serial1MIDISendData(midi_ccReg.ccOutRegOff);
		serial1MIDISendData(regNr);
	}
}

// PROGRAM DISPLAY V 0.71
// Programm Nr to LCD

uint8_t prog_Display; // Program value 0...63
uint8_t prog_UpdDisplay; // TRUE if PROGRAM has changed and should be updated

void prog_set(uint8_t prog){
	if (prog != prog_Display){
		prog_Display = prog;
		prog_UpdDisplay = TRUE;
	}
}

void prog_toLcd(){
	if (prog_Display <= PROGR_MAX) {
		lcd_putc('P');
		lcd_putc('-');
		lcd_putc('A' + ((prog_Display >> 3) & 0x07));
		lcd_putc('1' + (prog_Display & 0x07));
		lcd_putc(' ');
	} else {
		lcd_blank(5);
	}
}

RegOut_t reg_Out[REGOUT_LEN] = {{LCD_LINE1+1,'1',10,14},{LCD_LINE1+6,' ',15,18},
	{LCD_LINE1+10,'2',20,24},{LCD_LINE1+15,' ',25,29},{LCD_LINE2+1,'P',0,4},{LCD_LINE2+6,' ',5,9},
	{0,' ',REGISTER_NONE,REGISTER_NONE},{0,' ',REGISTER_NONE,REGISTER_NONE}}; // default values, can be configured

void init_RegOut(){
	if (eeprom_ReadRegOut() == EE_LOAD_ERROR) {
		// load some default values for my organ -> alredy done in array declaration
		log_putError(LOG_CAT_EE,LOG_CATEE_REGOUT,0);	}
}

void reg_toLCD(uint8_t readHWonly){
	// lcd output all register as short or long lines grouped in manuals
	for (uint8_t i = 0; i < REGOUT_LEN; i++){
		lcd_goto(reg_Out[i].cursor);
		char myChar = reg_Out[i].manualChar;
		if ((myChar > ' ') && (myChar <= 0x7F)) {
			// only if valid char
			lcd_putc(myChar);
			lcd_putc(' ');
		}
		uint8_t reg = reg_Out[i].regStart;
		if (reg == REGISTER_NONE) {
			break;
		}
		while (reg <= reg_Out[i].regEnd) {
			if (reg == reg_Out[i].regEnd) {
				// only one register left for out
				if (readHWonly == TRUE) {
					lcd_putc(LCD_CHAR_REG_OFF+ ((get_RegisterStatus(reg) & REGISTER_READ_HWIN) ? 1 : 0));
				} else {
					lcd_putc(LCD_CHAR_REG_OFF+  ((get_RegisterStatus(reg) & REGISTER_READ_SWOUT) ? 1 : 0));
				}
			} else {
				// at least 2 register left
				if (readHWonly == TRUE) {
					uint8_t addChar = (get_RegisterStatus(reg++) & REGISTER_READ_HWIN) ? 2 : 0;
					addChar += (get_RegisterStatus(reg) & REGISTER_READ_HWIN) ? 1 : 0;
					lcd_putc(LCD_CHAR_REG_OFFOFF+ addChar);
				} else {
					uint8_t addChar = (get_RegisterStatus(reg++) & REGISTER_READ_SWOUT) ? 2 : 0;
					addChar += (get_RegisterStatus(reg) & REGISTER_READ_SWOUT) ? 1 : 0;
					lcd_putc(LCD_CHAR_REG_OFFOFF+ addChar);
				}
			}
			reg++;
		}
		lcd_putc(' ');
	}
}

void reg_ClearOnLCD(){
	// clear area that displays register
	for (uint8_t i = 0; i < REGOUT_LEN; i++){
		lcd_goto(reg_Out[i].cursor);
		char myChar = reg_Out[i].manualChar;
		uint8_t spaceCount;
		spaceCount = (reg_Out[i].regEnd - reg_Out[i].regStart) + 1;
		spaceCount = (spaceCount + 1) >> 1; // (nr of reg) / 2 plus 1 if odd number
		spaceCount += ((myChar > ' ') && (myChar <= 0x7F)) ? 2 : 0; // add caption if valid
		lcd_blank(spaceCount);
	}
}

//------------------------------------- M I D I C H A N N E L   T O   M A N U A L ---------------------------------

void init_Midi2Manual(){
	MidiInMap_t *pMidiInMap;
	pMidiInMap = &(midiInMap[0][0]);
	// reset all
	for (uint8_t i = MIDI_CHANNEL_COUNT * MIDI_SPLIT_COUNT; i > 0; i--){
		// each channel not assigned to any manual
		pMidiInMap->manual = MANUAL_NONE;
		pMidiInMap->midiNote = MIDI_NOTE_NONE;
		pMidiInMap->manualNote = MIDI_NOTE_NONE;
		pMidiInMap->noteRange = 0;
		pMidiInMap++;
	}
	// default entries one split range to each manual Ch1->III, Ch2->II, Ch3->I, Ch4->P
	if (eeprom_ReadMidiInMap() == EE_LOAD_ERROR){
		midiEEPromLoadError = EE_LOAD_ERROR;
		midiInMap[MIDI_CHANNEL_1][0].manual = MANUAL_III;
		midiInMap[MIDI_CHANNEL_1][0].midiNote = MIDI_NOTE_C2;
		midiInMap[MIDI_CHANNEL_1][0].manualNote = MIDI_NOTE_C2;
		midiInMap[MIDI_CHANNEL_1][0].noteRange = MIDI_NOTE_G6 - MIDI_NOTE_C2 + 1;
		midiInMap[MIDI_CHANNEL_2][0].manual = MANUAL_II;
		midiInMap[MIDI_CHANNEL_2][0].midiNote = MIDI_NOTE_C2;
		midiInMap[MIDI_CHANNEL_2][0].manualNote = MIDI_NOTE_C2;
		midiInMap[MIDI_CHANNEL_2][0].noteRange = MIDI_NOTE_G6 - MIDI_NOTE_C2 + 1;
		midiInMap[MIDI_CHANNEL_3][0].manual = MANUAL_I;
		midiInMap[MIDI_CHANNEL_3][0].midiNote = MIDI_NOTE_C2;
		midiInMap[MIDI_CHANNEL_3][0].manualNote = MIDI_NOTE_C2;
		midiInMap[MIDI_CHANNEL_3][0].noteRange = MIDI_NOTE_G6 - MIDI_NOTE_C2 + 1;
		midiInMap[MIDI_CHANNEL_4][0].manual = MANUAL_P;
		midiInMap[MIDI_CHANNEL_4][0].midiNote = MIDI_NOTE_C2;
		midiInMap[MIDI_CHANNEL_4][0].manualNote = MIDI_NOTE_C2;
		midiInMap[MIDI_CHANNEL_4][0].noteRange = MIDI_NOTE_F4 - MIDI_NOTE_C2 + 1;
		log_putError(LOG_CAT_EE,LOG_CATEE_MIDI2MAN,0);
	}
	if (eeprom_ReadMidiThrough() == EE_LOAD_ERROR){
		midiThrough.InChannel = MIDI_CHANNEL_NONE;
		midiThrough.OutChannel = MIDI_CHANNEL_NONE;
		log_putError(LOG_CAT_EE,LOG_CATEE_MIDI2MAN,0);
	}
}

void init_Manual2Midi(){
	// reset all midi out
	for (uint8_t i = 0; i << MANUAL_COUNT; i++){
		midiOutMap[i].hw_channel = MIDI_CHANNEL_NONE;
		midiOutMap[i].sw_channel = MIDI_CHANNEL_NONE;
	}
	// try to read from eeprom
	if (eeprom_ReadMidiOutMap() == EE_LOAD_ERROR){
		midiEEPromLoadError = EE_LOAD_ERROR;
		// default entries
		midiOutMap[MANUAL_III].hw_channel = MIDI_CHANNEL_1;
		midiOutMap[MANUAL_II].hw_channel = MIDI_CHANNEL_2;
		midiOutMap[MANUAL_I].hw_channel = MIDI_CHANNEL_3;
		midiOutMap[MANUAL_P].hw_channel = MIDI_CHANNEL_4;
		midi_Setting.TxActivceSense = FALSE;
		midi_Setting.VelZero4Off = FALSE;
		midi_Setting.AcceptProgChange = TRUE;
		log_putError(LOG_CAT_EE,LOG_CATEE_MAN2MIDI,0);
	}
}

void midiNote_to_Manual(uint8_t channel, uint8_t note, uint8_t onOff){
	// note event in some midi channel has been received
	// check map for assigned manuals and activate/decativate output to mosfets
	channel = channel & MIDI_CHANNEL_MASK; //  0..15 only
	uint8_t found = 0;
	for (uint8_t i = 0; i < MIDI_SPLIT_COUNT; i++){
		if (midiInMap[channel][i].manual < MANUAL_COUNT){
			// valid entry
			int8_t noteBase0 = note - midiInMap[channel][i].midiNote; // minus if invalid
			if ((noteBase0 >= 0) && (noteBase0 < midiInMap[channel][i].noteRange)) {
				// only if not is in range
				uint8_t manual = midiInMap[channel][i].manual;
				uint8_t manNote = noteBase0 + midiInMap[channel][i].manualNote;
				if (onOff == NOTE_ON) {
					midiLastInManual = manual; // for debugging/display status
					midiLastInNote = manNote; // for debugging/display status
				}
				manual_NoteOnOff(manual, manNote, onOff);
				found |= 0xFF;
			}
		}
	}
	if ((onOff == NOTE_ON) && (found == 0)){
		// not found, show Channel instead of manual
		midiLastInNote = note;
		midiLastInChannel = channel;
		midiLastInManual = MANUAL_NONE;
	}
	// V 0.58 When SW Midi Through: send Note
	if (channel == midiThrough.InChannel){
		// if IN Channel is matched (through OFF -> midiThrough.InChannel = 0xFF)
		if (midiThrough.OutChannel != MIDI_CHANNEL_NONE) {
			// only if out channel is valid: do as in midiKeyPress_Process
			serial1MIDISendCmd(((onOff == NOTE_ON) || (midi_Setting.VelZero4Off) ? MIDI_NOTEON : MIDI_NOTEOFF),midiThrough.OutChannel);
			// if note off: use note on an velocity = 0 to turn off note (less bytes !)
			serial1MIDISendData(note);
			// if note off: use note on an velocity = 0 to turn off note (less bytes !):
			serial1MIDISendData(((onOff == NOTE_OFF) && (midi_Setting.VelZero4Off)) ? 0 : MIDI_DEFAULT_VELOCITY);
		}
	}
}

ChannelNote_t Manual_to_MidiNote(uint8_t manual, uint8_t note){
	// converts manual and note to midi channel and midi note
	ChannelNote_t result = {MIDI_CHANNEL_NONE,MIDI_NOTE_NONE};
	if (manual < MANUAL_COUNT) {
		if (midiOutMap[manual].hw_channel != MIDI_CHANNEL_NONE) {
			result.hw_channel = midiOutMap[manual].hw_channel;
			result.note = note; // currently no transpose, might be added later
			// caution: sw_channel used in manual_NoteOnOff() does not look up note ! if transpose added here, do it there, too!
		}
	}
	return(result);
}

//------------------------------------- M A N U A L   T O   P I P E - I O ---------------------------------

void Midi_updateManualRange(){
	for (uint8_t i = 0; i < MANUAL_COUNT; i++){
		uint8_t rangeEnd = 0;
		uint8_t rangeStart = 0xFF;
		for (uint8_t range = 0; range < RANGE_COUNT; range++){
			if ((manualMap[i][range].startNote != MIDI_NOTE_NONE) && (manualMap[i][range].endNote != MIDI_NOTE_NONE)){
				if (manualMap[i][range].startNote < rangeStart) {
					rangeStart = manualMap[i][range].startNote;
				}
				if (manualMap[i][range].endNote > rangeEnd) {
					rangeEnd = manualMap[i][range].endNote;
				}
			}
			// rangeStart and rangeEnd should have values != 0xFF / 0x00
			if ((rangeEnd == 0) || (rangeStart == 0xFF)){
				// no, they are not really assigned, then cancel assignement for this range
				ManualNoteRange[i].startNote = MIDI_NOTE_NONE;
				ManualNoteRange[i].endNote = MIDI_NOTE_NONE;
			} else {
				// yes, they are assigend, store values
				ManualNoteRange[i].startNote = rangeStart;
				ManualNoteRange[i].endNote = rangeEnd;
			}
		}
	}
}

void init_Manual2Module(){
	for (int8_t i = MANUAL_COUNT-1; i >= 0; i--){
		// make all entries invalid
		for (int8_t j = RANGE_COUNT-1; j >= 0; j--){
			manualMap[i][j].startNote = MIDI_NOTE_NONE;
			manualMap[i][j].endNote = MIDI_NOTE_NONE;
			manualMap[i][j].bitStart = 0;
		}
	}
	// default entries
	if (eeprom_ReadManualMap() == EE_LOAD_ERROR){
		// no default values for manual map!
		midiEEPromLoadError = EE_LOAD_ERROR;
		log_putError(LOG_CAT_EE,LOG_CATEE_MAN2MOD,0);
		// V 0.65 default entries for steinmeyer organ
		manualMap[MANUAL_III][0].startNote = MIDI_NOTE_C2;
		manualMap[MANUAL_III][0].endNote = MIDI_NOTE_G4;
		manualMap[MANUAL_III][0].bitStart = MODULE_BIT(0,0);
		manualMap[MANUAL_III][1].startNote = MIDI_NOTE_GIS4;
		manualMap[MANUAL_III][1].endNote = MIDI_NOTE_G6;
		manualMap[MANUAL_III][1].bitStart = MODULE_BIT(1,0);
		manualMap[MANUAL_II][0].startNote = MIDI_NOTE_C2;
		manualMap[MANUAL_II][0].endNote = MIDI_NOTE_G4;
		manualMap[MANUAL_II][0].bitStart = MODULE_BIT(2,0);
		manualMap[MANUAL_II][1].startNote = MIDI_NOTE_GIS4;
		manualMap[MANUAL_II][1].endNote = MIDI_NOTE_G6;
		manualMap[MANUAL_II][1].bitStart = MODULE_BIT(3,0);
		manualMap[MANUAL_I][0].startNote = MIDI_NOTE_C2;
		manualMap[MANUAL_I][0].endNote = MIDI_NOTE_G4;
		manualMap[MANUAL_I][0].bitStart = MODULE_BIT(4,0);
		manualMap[MANUAL_I][1].startNote = MIDI_NOTE_GIS4;
		manualMap[MANUAL_I][1].endNote = MIDI_NOTE_G6;
		manualMap[MANUAL_I][1].bitStart = MODULE_BIT(5,0);
		manualMap[MANUAL_P][0].startNote = MIDI_NOTE_C2;
		manualMap[MANUAL_P][0].endNote = MIDI_NOTE_F4;
		manualMap[MANUAL_P][0].bitStart = MODULE_BIT(6,0);
		manualMap[MANUAL_R][0].startNote = 0;
		manualMap[MANUAL_R][0].endNote = 29;
		manualMap[MANUAL_R][0].bitStart = MODULE_BIT(7,0);
	}
	Midi_updateManualRange();
	// turn off couplers
}

ModulBitError_t manualNote_to_moduleBit(uint8_t manual, uint8_t note){
	// returns module+bit_nr in lowByte 9x99 in high byte (MODULE_NOERROR) and or 0xFF (MODULE_ERROR) in HiByte if Note ist not implemented
	ModulBitError_t result;
	if (manual < MANUAL_COUNT) {
		// valid manual
		ManualMap_t *pRange;
		pRange = &(manualMap[manual][0]); // check all Ranges for this manual
		uint8_t i = RANGE_COUNT;
		do {
			if ((note >= pRange->startNote) && (note <= pRange->endNote)) {
				// found in this range
				result.error = MODULE_NOERROR;
				result.moduleBit = pRange->bitStart + (note - pRange->startNote);
				return (result);
			}
			pRange++;
		} while (--i > 0);
	}
	// when we are here: none ofd the defined ranges for this manual contained note
	result.error = MODULE_ERROR;
	return (result);
}

ManualNote_t moduleBit_to_manualNote(uint8_t moduleBit){
	// searches map of all manuals and their ranges for this module/bit combination
	// returns manual in hiByte and note in LowByte
	// if no note is found for that Bit, return is MODULE_BIT_NONEXISTENT (0xFF00)
	ManualNote_t result;
	ManualMap_t *pRange;
	pRange = &(manualMap[MANUAL_0][RANGE_0]); // check all Ranges for all manuals
	uint8_t manual = 0;
	do {
		for (uint8_t i = RANGE_COUNT; i > 0; i--){
			if (pRange->startNote != MIDI_NOTE_NONE){
				// only check if section is valid
				if ((moduleBit >= pRange->bitStart) && (moduleBit <= pRange->bitStart + (pRange->endNote - pRange->startNote))) {
					// found
					result.manual = manual;
					result.note = pRange->startNote + (moduleBit - pRange->bitStart); // assuming no bit 5-7 in moduleBit and bitStart are the same
					return(result);
				}
			}
			pRange++;
		}
		manual++;
	} while (manual <= MANUAL_COUNT);
	result.manual = MANUAL_NONE;
	return (result);
}

void manual_NoteOnOff(uint8_t manual, uint8_t note, uint8_t onOff){
	// turns on/off note (i.e. mosfet) an a certain manual
	ModulBitError_t moduleInfo;
	moduleInfo = manualNote_to_moduleBit(manual, note);
	// returns mmmb bbbb in LowByte
	uint8_t modulNrMask = 1 << (MODULE_BIT_TO_MODULE(moduleInfo.moduleBit)); // 0000 0001 = Module 0, 1000 0000 = Module 7
	uint8_t bitNr = MODULE_BIT_TO_BIT(moduleInfo.moduleBit);
	if (moduleInfo.error == MODULE_NOERROR) {
		if (((modulNrMask & pipe_Module.AssnWrite) == 0) && ((onOff & NOTE_NOREDIRECT) == 0)){
			// only if destination module is not assinged as writeable and flag NOTE_NOREDIRECT is not set
			onOff &= ~NOTE_NOREDIRECT; // turn off flag
			PipeMessage_t myMessage;
			myMessage.message8[MSG_BYTE_MODULEBITS] = modulNrMask;
			myMessage.message8[MSG_BYTE_CMD_SHIFTBIT] = ((onOff == NOTE_ON) ? MESSAGE_PIPE_ON_HI : MESSAGE_PIPE_OFF_HI )| bitNr;
			pipeMsgPush(myMessage);
		}
		onOff &= ~NOTE_NOREDIRECT; // turn off flag
		if (onOff == NOTE_OFF) {
			// note off -> write 1 to pipe mosfet
			pipe_off(bitNr,modulNrMask);
		} else {
			// note on -> write 0 to pipe mosfet
			pipe_on(bitNr,modulNrMask);
		}
		// V0.62 direct pipe message if module can't be written
	}
	// V0.61 midi sw_channel output
	if (midiOutMap[manual].sw_channel != MIDI_CHANNEL_NONE){
		// lines from midiKeyPress_Process():
		// if settings are appropriate: note off = use note on an velocity = 0 to turn off note (less bytes !) / or send real not off!
		serial1MIDISendCmd(((onOff == NOTE_ON) || (midi_Setting.VelZero4Off) ? MIDI_NOTEON : MIDI_NOTEOFF),midiOutMap[manual].sw_channel);
		serial1MIDISendData(note);
		// V 0.69 removed: && (midi_Setting.VelZero4Off) after (onOff == NOTE_OFF): now always send vel=0 when note off
		serial1MIDISendData(((onOff == NOTE_OFF)) ? 0 : MIDI_DEFAULT_VELOCITY);
		// caution: sw_channel should be used only if no HW output implemented for manual. If used midi through should not be set for
		// corresponding channel/manual
	}
}

//********************************************* P R O C E S S   P I P E   M E S S A G E ->MIDI, COUPLER *******************************

void midiKeyPress_Process(PipeMessage_t pipeMessage){
	// pipe message are generated by polling key/pipe magnet lines in timer interrupt
	// one message contains bit nr and all bits of modules that share rhe same message on the same bit
	// format cccb bbbb mmmm mmmm c = command bit = bit number m = module mask
	// example: 0b0010 1001 0010 0000 = line acitvated (001) in bit 9  (0 1001) of module 5 (0010 0000)
	serial0USB_logPipeIn(pipeMessage);
	uint8_t command = pipeMessage.message8[MSG_BYTE_CMD_SHIFTBIT] & MESSAGE_PIPE_CMD_MASK_H; // upper 3 bit
	uint8_t shiftBit = pipeMessage.message8[MSG_BYTE_CMD_SHIFTBIT] & MESSAGE_PIPE_SHIFTBIT_MASK_H; // lower 5 bits = BitNr of each module 0..31
	uint8_t moduleBits = pipeMessage.message8[MSG_BYTE_MODULEBITS]; // one bit for each module, so one message can countain up to 8 messages for 8 modules
	uint8_t messageProcessed = FALSE;
	ManualNote_t manualNote;
	ChannelNote_t chanNote;
	if ((command == MESSAGE_PIPE_ON_HI) || (command == MESSAGE_PIPE_OFF_HI)){
		// Note on or off
		for (uint8_t i = 0; i < 8; i++){
			// check all 8 bits for 8 modules, so i is number of current Module
			if ((moduleBits & 0x01) != 0) {
				// LSB==1 -> Module "i" has message
				manualNote = moduleBit_to_manualNote(MODULE_BIT(i,shiftBit)); // modBit = mmmb bbbb, m = moduleNr, b = bitNr
				// check if manual and note is assigned that module/bit
				if (manualNote.manual != MANUAL_NONE){
					// manual is assigned
					// check midi assigneemnt for this manual/note
					messageProcessed = TRUE;
					chanNote = Manual_to_MidiNote(manualNote.manual, manualNote.note);
					if (chanNote.hw_channel <= MIDI_CHANNEL_16){
						// midi chan assigned note on/off can be sent
						if (command == MESSAGE_PIPE_ON_HI) {
							// note on
							serial1MIDISendCmd(MIDI_NOTEON,chanNote.hw_channel);
							serial1MIDISendData(chanNote.note);
							serial1MIDISendData(MIDI_DEFAULT_VELOCITY);
							midiLastOutManual = manualNote.manual;
							midiLastOutNote = manualNote.note;
						} else if (midi_Setting.VelZero4Off) {
							// note off
							serial1MIDISendCmd(MIDI_NOTEON,chanNote.hw_channel);
							serial1MIDISendData(chanNote.note);
							serial1MIDISendData(0);
						} else {
							serial1MIDISendCmd(MIDI_NOTEOFF,chanNote.hw_channel);
							serial1MIDISendData(chanNote.note);
							serial1MIDISendData(0);
						}
					}
					// now check couplers for that manual
					uint8_t noteOnOff = (command == MESSAGE_PIPE_ON_HI ? NOTE_ON : NOTE_OFF);
					// TODO check if Pipe was activated my different event (MIDI, other coupler)
					if (manualNote.manual == MANUAL_III){
						if (midi_Couplers[COUPLER_2FROM3] == TRUE){
							manual_NoteOnOff(MANUAL_II, manualNote.note, noteOnOff);
						}
						if (midi_Couplers[COUPLER_1FROM3] == TRUE){
							manual_NoteOnOff(MANUAL_I, manualNote.note, noteOnOff);
						}
						if (midi_Couplers[COUPLER_PFROM3] == TRUE){
							manual_NoteOnOff(MANUAL_P, manualNote.note, noteOnOff);
						}
					} else 	if (manualNote.manual == MANUAL_II) {
						if (midi_Couplers[COUPLER_1FROM2] == TRUE){
							manual_NoteOnOff(MANUAL_I, manualNote.note, noteOnOff);
						}
						if (midi_Couplers[COUPLER_PFROM2] == TRUE){
							manual_NoteOnOff(MANUAL_P, manualNote.note, noteOnOff);
						}
						if (midi_Couplers[COUPLER_3FROM2] == TRUE){
							manual_NoteOnOff(MANUAL_III, manualNote.note, noteOnOff);
						}
					} else 	if (manualNote.manual == MANUAL_I) {
						if (midi_Couplers[COUPLER_PFROM1] == TRUE){
							manual_NoteOnOff(MANUAL_P, manualNote.note, noteOnOff);
						}
						if (midi_Couplers[COUPLER_3FROM1] == TRUE){
							manual_NoteOnOff(MANUAL_III, manualNote.note, noteOnOff);
						}
						if (midi_Couplers[COUPLER_2FROM1] == TRUE){
							manual_NoteOnOff(MANUAL_II, manualNote.note, noteOnOff);
						}
					} else if (manualNote.manual == MANUAL_P) {
						if (midi_Couplers[COUPLER_3FROMP] == TRUE){
							manual_NoteOnOff(MANUAL_III, manualNote.note, noteOnOff);
						}
						if (midi_Couplers[COUPLER_2FROMP] == TRUE){
							manual_NoteOnOff(MANUAL_II, manualNote.note, noteOnOff);
						}
						if (midi_Couplers[COUPLER_1FROMP] == TRUE){
							manual_NoteOnOff(MANUAL_I, manualNote.note, noteOnOff);
						}
					}
				} else {
					// now check if modbit is assigned to register
					uint8_t regNr = moduleBit_to_registerNr(MODULE_BIT(i,shiftBit));
					if (regNr < REGISTER_COUNT) {
						// modulebit is assigned to a register
						messageProcessed = TRUE;
						// V 0.83: send RegOn/Off to MIDI out
						if (command == MESSAGE_PIPE_ON_HI){
							midiSendRegOn(regNr);
							regNr |= REGISTER_WAS_SET;
						} else {
							midiSendRegOff(regNr);
						}
						midi_RegisterChanged = regNr; // for LCD out in main()
					}
				} // process future key events here (none definded yet)
				if (messageProcessed == FALSE) {
					// ModBit Message was not assigned to a manual or register
					log_putWarning(LOG_CAT_MODULES,LOG_CATMODULES_UNKNOWNINP,(i << 8) | shiftBit);
				}
			}
			moduleBits >>= 1; // next module
		} // for
	 }
}

//******************************************* S E N D   A L L N O T E S O F F ************************************

void midiSendAllNotesOff(){
	if (midiThrough.OutChannel <= MIDI_CHANNEL_16) {
		serial1MIDISendCmd(MIDI_CTRLCHG,midiThrough.OutChannel);
		serial1MIDISendData(MIDI_CTRL_ALLNOTESOFF);
		serial1MIDISendData(0);
	}
// 	for (uint8_t i = 0; i < MANUAL_COUNT; i++){
// 		uint8_t chan = midiOutMap[i].hw_channel;
// 		if (chan <= MIDI_CHANNEL_16) {
// 			serial1MIDISend(MIDI_CTRLCHG | chan);
// 			serial1MIDISend(MIDI_CTRL_ALLNOTESOFF);
// 			serial1MIDISend(0);
// 		}
// 	}
}

void midi_SendActiveSense(){
	serial1MIDISendCmd(MIDI_ACTIVESENSING,0);
}
