docdent/pipe/Pipe1/menu.c

/*
 * menu.c
 *
 * Created: 07.02.2019 14:02:51
 *  Author: Anwender
 */

#include <avr/io.h>
#include <inttypes.h>
#include <stddef.h>

#include "lcd_u.h"
#include "message.h"
#include "hwtimer.h"
#include "utils.h"
#include "serial.h"
#include "menu.h"
#include "Midi.h"
#include "ee_prom.h"
#include "log.h"

//********************************************* C O N S T ******************************************

const char sw_version [] PROGMEM = "V0.85";

//-------------------------------------- M E N U ----------------------------------
// each menu is an array of menu entries Menu_t. First byte shows kind of menu entry. First and last entries in array are marked with flag MENU_T_LEFTBOUND or MENU_T_RIGHTBOUND in first byte
// a menu entry can be a sub menu, a simple function or data that can be displayed and edited
// more in menu.h

uint8_t menuOnExitMidiChannelSection(uint8_t arg);
uint8_t menuOnExitManualSection(uint8_t arg);
uint8_t menuOnEnterStatusMidiOut(uint8_t arg);
uint8_t menuOnEnterStatusMidiIn(uint8_t arg);
uint8_t menuOnEnterLogDisp(uint8_t arg);

// --- MAIN --- SETUP --- USB ---
uint8_t menuOnEnterUSBprotokoll(uint8_t arg);
uint8_t menuOnExitUSBactive(uint8_t arg);
uint8_t menuOnEnterUSBsendHW(uint8_t arg);
const __flash Menu_t menu_USBser[] =
{{MENU_T_VARONOFF | MENU_T_LEFTBOUND,0,"EventLog",NULL,{(uint8_t *) &(serUSB_Active)},NULL,menuOnExitUSBactive}, // V0.68 clarify meaning of this function
{MENU_T_MENU,0,"SendLog",NULL,{NULL},menuOnEnterUSBprotokoll,NULL},
{MENU_T_MENU | MENU_T_RIGHTBOUND,0,"SndHWCfg",NULL,{NULL},menuOnEnterUSBsendHW,NULL}};

//--- MAIN --- STATUS ---
const __flash Menu_t menu_status[] =
	{{MENU_T_MENU | MENU_T_LEFTBOUND,MENU_FLAG_FNHANDLEMESSAGE,"Log",NULL,{NULL},menuOnEnterLogDisp,NULL},
	{MENU_T_MENU,0,"USB",menu_USBser,{NULL},NULL,NULL},
	{MENU_T_VARBYTE,MENU_FLAG_CLEAREXTRA,"MIDI-In",NULL,{NULL},menuOnEnterStatusMidiIn,NULL},
	{MENU_T_VARBYTE | MENU_T_RIGHTBOUND,MENU_FLAG_CLEAREXTRA,"MIDI-Out",NULL,{NULL},menuOnEnterStatusMidiOut,NULL}};

// --- MAIN --- SETUP --- MODULE --- MODASSIGN --- SECTION --- DEFINE
const __flash Menu_t menu_modDefine[] =
	{{MENU_T_VARNOTE | MENU_T_LEFTBOUND,MENU_FLAG_DATAOFFSET | MENU_FLAG_ALLOWINVALD,"NoteBeg",NULL,{&(manualMap[0][0].startNote)},NULL,NULL},
	{MENU_T_VARNOTE,MENU_FLAG_DATAOFFSET | MENU_FLAG_ALLOWINVALD,"NoteEnd",NULL,{&(manualMap[0][0].endNote)},NULL,NULL},
	{MENU_T_VARMODBIT | MENU_T_RIGHTBOUND,MENU_FLAG_DATAOFFSET,"Module/Bit",NULL,{&(manualMap[0][0].bitStart)},NULL,NULL}};

const __flash Menu_t menu_modDefineReg[] = {
	{MENU_T_VARREG | MENU_T_LEFTBOUND,MENU_FLAG_DATAOFFSET,"RegBeg",NULL,{&(registerMap[0].startReg)},NULL,NULL},
	{MENU_T_VARREG,MENU_FLAG_DATAOFFSET,"RegEnd",NULL,{&(registerMap[0].endReg)},NULL,NULL},
	{MENU_T_VARMODBIT | MENU_T_RIGHTBOUND,MENU_FLAG_DATAOFFSET,"Module/Bit",NULL,{&(registerMap[0].bitStart)},NULL,NULL}
};

// --- MAIN --- SETUP --- MODULE --- MODASSIGN --- SECTION ---
uint8_t menuOnEnterModSec(uint8_t arg);
const __flash Menu_t menu_modSection[] =
	{{MENU_T_MENU_L,0,MENUTEXT_SEC1,menu_modDefine,{.tag=MENU_VAL_SEC1},menuOnEnterModSec,NULL},
	{MENU_T_MENU,0,MENUTEXT_SEC2,menu_modDefine,{.tag= MENU_VAL_SEC2},menuOnEnterModSec,NULL},
	{MENU_T_MENU,0,MENUTEXT_SEC3,menu_modDefine,{.tag=MENU_VAL_SEC3},menuOnEnterModSec,NULL},
	{MENU_T_MENU_R,0,MENUTEXT_SEC4,menu_modDefine,{.tag=MENU_VAL_SEC4},menuOnEnterModSec,NULL}};

uint8_t menuOnEnterModSecReg(uint8_t arg);
const __flash Menu_t menu_modSection8[] = {
	{MENU_T_MENU_L,0,MENUTEXT_SEC1,menu_modDefineReg,{.tag=MENU_VAL_SEC1},menuOnEnterModSecReg,NULL},
	{MENU_T_MENU,0,MENUTEXT_SEC2,menu_modDefineReg,{.tag= MENU_VAL_SEC2},menuOnEnterModSecReg,NULL},
	{MENU_T_MENU,0,MENUTEXT_SEC3,menu_modDefineReg,{.tag=MENU_VAL_SEC3},menuOnEnterModSecReg,NULL},
	{MENU_T_MENU,0,MENUTEXT_SEC4,menu_modDefineReg,{.tag=MENU_VAL_SEC4},menuOnEnterModSecReg,NULL},
	{MENU_T_MENU,0,MENUTEXT_SEC5,menu_modDefineReg,{.tag=MENU_VAL_SEC5},menuOnEnterModSecReg,NULL},
	{MENU_T_MENU,0,MENUTEXT_SEC6,menu_modDefineReg,{.tag=MENU_VAL_SEC6},menuOnEnterModSecReg,NULL},
	{MENU_T_MENU,0,MENUTEXT_SEC7,menu_modDefineReg,{.tag=MENU_VAL_SEC7},menuOnEnterModSecReg,NULL},
	{MENU_T_MENU_R,0,MENUTEXT_SEC8,menu_modDefineReg,{.tag=MENU_VAL_SEC8},menuOnEnterModSecReg,NULL}
};

// --- MAIN --- SETUP --- MODULE --- MODASSIGN ---
uint8_t menuOnEnterModManual(uint8_t arg);
const __flash Menu_t menu_modAssign[] =
	{{MENU_T_MENU_L,0,MENUTEXT_MAN3,menu_modSection,{.tag=MANUAL_III},menuOnEnterModManual,NULL},
	{MENU_T_MENU,0,MENUTEXT_MAN2,menu_modSection,{.tag=MANUAL_II},menuOnEnterModManual,NULL},
	{MENU_T_MENU,0,MENUTEXT_MAN1,menu_modSection,{.tag=MANUAL_I},menuOnEnterModManual,NULL},
	{MENU_T_MENU,0,MENUTEXT_MANP,menu_modSection,{.tag=MANUAL_P},menuOnEnterModManual,NULL},
	{MENU_T_MENU_R,0,MENUTEXT_MANR,menu_modSection8,{.tag=MANUAL_R},NULL,NULL}
};

// --- MAIN --- SETUP --- MODULE --- MODTEST --- MODULE ---
uint8_t menu_ModuleTestPattern(uint8_t arg);
uint8_t menu_testModule(uint8_t arg);
uint8_t menu_readModule(uint8_t arg);
uint8_t menu_enterWriteModule(uint8_t arg);
uint8_t menu_exitWriteModule(uint8_t arg);
const __flash Menu_t menu_ModTestSelcted[] =
{{MENU_T_MENU | MENU_T_LEFTBOUND,0,"Read",NULL,{NULL},menu_readModule,NULL},
{MENU_T_VARLONG,0,"Write",NULL,{(uint8_t *)&menuModVal},menu_enterWriteModule,menu_exitWriteModule},
{MENU_T_MENU,0,"TestPtrn",NULL,{NULL},menu_ModuleTestPattern,NULL},
{MENU_T_MENU | MENU_T_RIGHTBOUND,0,"LoopTst",NULL,{NULL},menu_testModule,NULL}};

// --- MAIN --- SETUP --- MODULE --- MODTEST ---
uint8_t menuOnEnterModSel(uint8_t arg);
const __flash Menu_t menu_ModeSel[] =
	{{MENU_T_MENU_L,0,MENUTEXT_MOD0,menu_ModTestSelcted,{.tag=0},menuOnEnterModSel,NULL},
	{MENU_T_MENU,0,MENUTEXT_MOD1,menu_ModTestSelcted,{.tag=1},menuOnEnterModSel,NULL},
	{MENU_T_MENU,0,MENUTEXT_MOD2,menu_ModTestSelcted,{.tag=2},menuOnEnterModSel,NULL},
	{MENU_T_MENU,0,MENUTEXT_MOD3,menu_ModTestSelcted,{.tag=3},menuOnEnterModSel,NULL},
	{MENU_T_MENU,0,MENUTEXT_MOD4,menu_ModTestSelcted,{.tag=4},menuOnEnterModSel,NULL},
	{MENU_T_MENU,0,MENUTEXT_MOD5,menu_ModTestSelcted,{.tag=5},menuOnEnterModSel,NULL},
	{MENU_T_MENU,0,MENUTEXT_MOD6,menu_ModTestSelcted,{.tag=6},menuOnEnterModSel,NULL},
	{MENU_T_MENU_R,0,MENUTEXT_MOD7,menu_ModTestSelcted,{.tag=7},menuOnEnterModSel,NULL}};

// --- MAIN --- SETUP --- MODULE ---
uint8_t menuOnExitModules(uint8_t arg);
uint8_t menuOnExitManual(uint8_t arg);
const __flash Menu_t menu_module[] =
	{{MENU_T_VARBIN | MENU_T_LEFTBOUND,0,"ModRead",NULL,{&(pipe_Module.AssnRead)},NULL,menuOnExitModules},
	{MENU_T_VARBIN,0,"ModWrite",NULL,{&(pipe_Module.AssnWrite)},NULL,menuOnExitModules},
	{MENU_T_VARBIN,MENU_FLAG_READONLY,"ModOK",NULL,{&(pipe_ModuleTested)},NULL,NULL},
	{MENU_T_MENU,0,"ModTest",menu_ModeSel,{NULL},NULL,NULL},
	{MENU_T_MENU_R,0,"ModAssign",menu_modAssign,{NULL},NULL,menuOnExitManual}};

// --- MAIN --- SETUP --- POWER
uint8_t menuOnEnterPwrOn(uint8_t arg);
uint8_t menuOnEnterPwrOff(uint8_t arg);
uint8_t menuOnEnterPwrRest(uint8_t arg);
const __flash Menu_t menu_Power[] =
{{MENU_T_MENU_L,0,"PowerOn",NULL,{NULL},menuOnEnterPwrOn,NULL},
{MENU_T_MENU,0,"PowerOff",NULL,{NULL},menuOnEnterPwrOff,NULL},
{MENU_T_MENU_R,0,"P.Restart",NULL,{NULL},menuOnEnterPwrRest,NULL}};

// --- MAIN --- SETUP --- EEPROM ---
uint8_t menuOnEnterEERestore(uint8_t arg);
uint8_t menuOnEnterEEBackup(uint8_t arg);
uint8_t menuOnEnterEEUpdate(uint8_t arg);
const __flash Menu_t menu_eeprom[] =
{{MENU_T_MENU_L,0,"EESave",NULL,{NULL},menuOnEnterEEUpdate,NULL},
{MENU_T_MENU,0,"EEBackup",NULL,{NULL},menuOnEnterEEBackup,NULL},
{MENU_T_MENU_R,0,"EERestore",NULL,{NULL},menuOnEnterEERestore,NULL}};

// --- MAIN --- SETUP --- REGISTER --- OUT
const __flash Menu_t menu_regoutSec[] =	{
	{MENU_T_VARBYTE | MENU_T_LEFTBOUND,MENU_FLAG_DATAOFFSET,"Cursor",NULL,{&(reg_Out[0].cursor)},NULL,NULL},
	{MENU_T_VARBYTE,MENU_FLAG_DATAOFFSET,"Char",NULL,{&(reg_Out[0].manualChar)},NULL,NULL},
	{MENU_T_VARREG,MENU_FLAG_DATAOFFSET,"RegBeg",NULL,{&(reg_Out[0].regStart)},NULL,NULL},
	{MENU_T_VARREG | MENU_T_RIGHTBOUND,MENU_FLAG_DATAOFFSET,"RegEnd",NULL,{&(reg_Out[0].regEnd)},NULL,NULL}};

// --- MAIN --- SETUP --- REGISTER
uint8_t menuOnEnterRegOut(uint8_t arg);
const __flash Menu_t menu_regout[] =
{{MENU_T_MENU_L,0,MENUTEXT_SEC1,menu_regoutSec,{.tag=0},menuOnEnterRegOut,NULL},
{MENU_T_MENU,0,MENUTEXT_SEC2,menu_regoutSec,{.tag=1},menuOnEnterRegOut,NULL},
{MENU_T_MENU,0,MENUTEXT_SEC3,menu_regoutSec,{.tag=2},menuOnEnterRegOut,NULL},
{MENU_T_MENU,0,MENUTEXT_SEC4,menu_regoutSec,{.tag=3},menuOnEnterRegOut,NULL},
{MENU_T_MENU,0,MENUTEXT_SEC5,menu_regoutSec,{.tag=4},menuOnEnterRegOut,NULL},
{MENU_T_MENU,0,MENUTEXT_SEC6,menu_regoutSec,{.tag=5},menuOnEnterRegOut,NULL},
{MENU_T_MENU,0,MENUTEXT_SEC7,menu_regoutSec,{.tag=6},menuOnEnterRegOut,NULL},
{MENU_T_MENU_R,0,MENUTEXT_SEC8,menu_regoutSec,{.tag=7},menuOnEnterRegOut,NULL}};

// --- MAIN --- SETUP ---
uint8_t menuOnExitRegisterOut(uint8_t arg);
const __flash Menu_t menu_setup[] =
{{MENU_T_MENU_L,0,"Module",menu_module,{NULL},NULL,NULL},
{MENU_T_MENU,0,"Register",menu_regout,{NULL},NULL,menuOnExitRegisterOut},
{MENU_T_MENU,0,"USB",menu_USBser,{NULL},NULL,NULL},
{MENU_T_MENU,0,"Power",menu_Power,{NULL},NULL,NULL},
{MENU_T_MENU_R,0,"EEprom",menu_eeprom,{NULL},NULL,NULL}};

// --- MAIN --- MIDI --- MIDOUT ---
const __flash Menu_t menu_midiOut[] =
	{{MENU_T_VARMIDICHAN | MENU_T_LEFTBOUND,MENU_FLAG_ALLOWINVALD,"III",NULL,{&(midiOutMap[MANUAL_III].hw_channel)},NULL,NULL},
	{MENU_T_VARMIDICHAN,MENU_FLAG_ALLOWINVALD,"II",NULL,{&(midiOutMap[MANUAL_II].hw_channel)},NULL,NULL},
	{MENU_T_VARMIDICHAN,MENU_FLAG_ALLOWINVALD,"I",NULL,{&(midiOutMap[MANUAL_I].hw_channel)},NULL,NULL},
	{MENU_T_VARMIDICHAN,MENU_FLAG_ALLOWINVALD,"P",NULL,{&(midiOutMap[MANUAL_P].hw_channel)},NULL,NULL},
	{MENU_T_VARMIDICHAN,MENU_FLAG_ALLOWINVALD,"III(int)",NULL,{&(midiOutMap[MANUAL_III].sw_channel)},NULL,NULL},
	{MENU_T_VARMIDICHAN,MENU_FLAG_ALLOWINVALD,"II(int)",NULL,{&(midiOutMap[MANUAL_II].sw_channel)},NULL,NULL},
	{MENU_T_VARMIDICHAN,MENU_FLAG_ALLOWINVALD,"I(int)",NULL,{&(midiOutMap[MANUAL_I].sw_channel)},NULL,NULL},
	{MENU_T_VARMIDICHAN  | MENU_T_RIGHTBOUND,MENU_FLAG_ALLOWINVALD,"P(int)",NULL,{&(midiOutMap[MANUAL_P].sw_channel)},NULL,NULL}};


uint8_t menuOnEnterTestManual(uint8_t arg);
uint8_t menuOnExitTestManualMan(uint8_t arg);

// --- MAIN --- MANUAL --- STIMMEN ---
uint8_t menuOnEnterTune(uint8_t arg);
const __flash Menu_t menu_tune[] =
	{{MENU_T_MENU_L,MENU_FLAG_FNHANDLEMESSAGE,MENUTEXT_MAN3,NULL,{.tag=MANUAL_III},menuOnEnterTune,NULL},
	{MENU_T_MENU,MENU_FLAG_FNHANDLEMESSAGE,MENUTEXT_MAN2,NULL,{.tag=MANUAL_II},menuOnEnterTune,NULL},
	{MENU_T_MENU,MENU_FLAG_FNHANDLEMESSAGE,MENUTEXT_MAN1,NULL,{.tag=MANUAL_I},menuOnEnterTune,NULL},
	{MENU_T_MENU_R,MENU_FLAG_FNHANDLEMESSAGE,MENUTEXT_MANP,NULL,{.tag=MANUAL_P},menuOnEnterTune,NULL}};

// --- MAIN --- TASTEN ---
extern const __flash Menu_t menu_selFunc[];
uint8_t menuOnExitKey(uint8_t arg);
uint8_t menuOnEnterKey(uint8_t arg);
const __flash Menu_t menu_key[] =
{{MENU_T_MENU_L, MENU_FLAG_ENTER_STORED_MENU,MENUTEXT_KEY1,menu_selFunc,{.tag=MENU_VAL_KEY1},menuOnEnterKey,menuOnExitKey},
{MENU_T_MENU,MENU_FLAG_ENTER_STORED_MENU,MENUTEXT_KEY2,menu_selFunc,{.tag=MENU_VAL_KEY2},menuOnEnterKey,menuOnExitKey},
{MENU_T_MENU,MENU_FLAG_ENTER_STORED_MENU,MENUTEXT_KEY3,menu_selFunc,{.tag=MENU_VAL_KEY3},menuOnEnterKey,menuOnExitKey},
{MENU_T_MENU_R,MENU_FLAG_ENTER_STORED_MENU,MENUTEXT_KEY4,menu_selFunc,{.tag=MENU_VAL_KEY4},menuOnEnterKey,menuOnExitKey}};

// --- MAIN --- MIDI --- CCREG
const __flash Menu_t menu_midiCCreg[] =
{{MENU_T_VARBYTE | MENU_T_LEFTBOUND,0,"RegOn_I",NULL,{&(midi_ccReg.ccInRegOn)},NULL,NULL},
{MENU_T_VARBYTE, 0,"RegOff_I",NULL,{&(midi_ccReg.ccInRegOff)},NULL,NULL},
{MENU_T_VARBYTE, 0,"RegOn_O",NULL,{&(midi_ccReg.ccOutRegOn)},NULL,NULL},
{MENU_T_VARBYTE | MENU_T_RIGHTBOUND,0,"RegOff_O",NULL,{&(midi_ccReg.ccOutRegOff)},NULL,NULL}};

// --- MAIN --- MIDI --- MIDIIN --- CHANNEL --- SECTION ---
const __flash Menu_t menu_midiInVar[] =
{{MENU_T_VARMANUAL | MENU_T_LEFTBOUND,MENU_FLAG_DATAOFFSET | MENU_FLAG_ALLOWINVALD,"Manual",NULL,{&(midiInMap[0][0].manual)},NULL,NULL},
{MENU_T_VARNOTE,MENU_FLAG_DATAOFFSET | MENU_FLAG_ALLOWINVALD,"MidNote",NULL,{&(midiInMap[0][0].midiNote)},NULL,NULL},
{MENU_T_VARDEC,MENU_FLAG_DATAOFFSET,"Range",NULL,{&(midiInMap[0][0].noteRange)},NULL,NULL},
{MENU_T_VARNOTE | MENU_T_RIGHTBOUND,MENU_FLAG_DATAOFFSET | MENU_FLAG_ALLOWINVALD,"ManNote",NULL,{&(midiInMap[0][0].manualNote)},NULL,NULL}};

// --- MAIN --- MIDI --- MIDIIN --- CHANNEL ---
uint8_t menuOnEnterMidiInSec(uint8_t arg);
const __flash Menu_t menu_midiInSec[] =
	{{MENU_T_MENU_L,0,MENUTEXT_SEC1,menu_midiInVar,{.tag=MENU_VAL_SEC1},menuOnEnterMidiInSec,NULL},
	{MENU_T_MENU,0,MENUTEXT_SEC2,menu_midiInVar,{.tag=MENU_VAL_SEC2},menuOnEnterMidiInSec,NULL},
	{MENU_T_MENU,0,MENUTEXT_SEC3,menu_midiInVar,{.tag=MENU_VAL_SEC3},menuOnEnterMidiInSec,NULL},
	{MENU_T_MENU_R,0,MENUTEXT_SEC4,menu_midiInVar,{.tag=MENU_VAL_SEC4},menuOnEnterMidiInSec,NULL}};

// --- MAIN --- MIDI --- MIDIIN ---
uint8_t menuOnEnterMidiInCh(uint8_t arg);
const __flash Menu_t menu_midiIn[] =
	{{MENU_T_MENU_L,0,MENUTEXT_MCH1,menu_midiInSec,{.tag = MIDI_CHANNEL_1},menuOnEnterMidiInCh,NULL},
	{MENU_T_MENU,0,MENUTEXT_MCH2,menu_midiInSec,{.tag=MIDI_CHANNEL_2},menuOnEnterMidiInCh,NULL},
	{MENU_T_MENU,0,MENUTEXT_MCH3,menu_midiInSec,{.tag=MIDI_CHANNEL_3},menuOnEnterMidiInCh,NULL},
	{MENU_T_MENU,0,MENUTEXT_MCH4,menu_midiInSec,{.tag=MIDI_CHANNEL_4},menuOnEnterMidiInCh,NULL},
	{MENU_T_MENU,0,MENUTEXT_MCH5,menu_midiInSec,{.tag=MIDI_CHANNEL_5},menuOnEnterMidiInCh,NULL},
	{MENU_T_MENU,0,MENUTEXT_MCH6,menu_midiInSec,{.tag=MIDI_CHANNEL_6},menuOnEnterMidiInCh,NULL},
	{MENU_T_MENU,0,MENUTEXT_MCH7,menu_midiInSec,{.tag=MIDI_CHANNEL_7},menuOnEnterMidiInCh,NULL},
	{MENU_T_MENU,0,MENUTEXT_MCH8,menu_midiInSec,{.tag=MIDI_CHANNEL_8},menuOnEnterMidiInCh,NULL},
	{MENU_T_MENU,0,MENUTEXT_MCH9,menu_midiInSec,{.tag=MIDI_CHANNEL_9},menuOnEnterMidiInCh,NULL},
	{MENU_T_MENU,0,MENUTEXT_MCH10,menu_midiInSec,{.tag=MIDI_CHANNEL_10},menuOnEnterMidiInCh,NULL},
	{MENU_T_MENU,0,MENUTEXT_MCH11,menu_midiInSec,{.tag=MIDI_CHANNEL_11},menuOnEnterMidiInCh,NULL},
	{MENU_T_MENU,0,MENUTEXT_MCH12,menu_midiInSec,{.tag=MIDI_CHANNEL_12},menuOnEnterMidiInCh,NULL},
	{MENU_T_MENU,0,MENUTEXT_MCH13,menu_midiInSec,{.tag=MIDI_CHANNEL_13},menuOnEnterMidiInCh,NULL},
	{MENU_T_MENU,0,MENUTEXT_MCH14,menu_midiInSec,{.tag=MIDI_CHANNEL_14},menuOnEnterMidiInCh,NULL},
	{MENU_T_MENU,0,MENUTEXT_MCH15,menu_midiInSec,{.tag=MIDI_CHANNEL_15},menuOnEnterMidiInCh,NULL},
	{MENU_T_MENU_R,0,MENUTEXT_MCH16,menu_midiInSec,{.tag=MIDI_CHANNEL_16},menuOnEnterMidiInCh,NULL}};

// --- MAIN --- MIDI ---
uint8_t menuOnExitMidiThrough(uint8_t arg);
uint8_t menuOnExitMidiIn(uint8_t arg);
uint8_t menuOnExitMidiOut(uint8_t arg);
uint8_t menu_OnEnterMidiPanic(uint8_t arg);
uint8_t menuOnExitMidiActiveSense(uint8_t arg);
uint8_t menuOnExitMidiCCreg(uint8_t arg);
const __flash Menu_t menu_midi[] =
	{{MENU_T_MENU_L,0,"NotesOff",NULL,{NULL},menu_OnEnterMidiPanic,NULL},
	{MENU_T_MENU,0,"MIDIin",menu_midiIn,{NULL},NULL,menuOnExitMidiIn},
	{MENU_T_MENU,0,"MIDIout",menu_midiOut,{NULL},NULL,menuOnExitMidiOut},
	{MENU_T_VARMIDICHAN,MENU_FLAG_ALLOWINVALD,"Thru-In",NULL,{&midiThrough.InChannel},NULL,menuOnExitMidiThrough},
	{MENU_T_VARMIDICHAN,MENU_FLAG_ALLOWINVALD,"Thru-Out",NULL,{&midiThrough.OutChannel},NULL,menuOnExitMidiThrough},
	{MENU_T_VARONOFF,0,"Accept PC",NULL,{&(midi_Setting.AcceptProgChange)},NULL,menuOnExitMidiActiveSense},
	{MENU_T_VARONOFF,0,"Act.Sense",NULL,{&(midi_Setting.TxActivceSense)},NULL,menuOnExitMidiActiveSense},
	{MENU_T_VARONOFF,0,"VelZ4Off",NULL,{&(midi_Setting.VelZero4Off)},NULL,menuOnExitMidiActiveSense},
	{MENU_T_MENU,0,"MIDI-CC",menu_midiCCreg,{NULL},NULL,menuOnExitMidiCCreg},
	{MENU_T_VARDEC,MENU_FLAG_READONLY,"RxBufUse",NULL,{&(midiRxBuffUsage)},NULL,NULL},	// V0.70 midi buffer usage
	{MENU_T_VARDEC | MENU_T_RIGHTBOUND,MENU_FLAG_READONLY,"TxBufUse",NULL,{&(midiTxBuffUsage)},NULL,NULL}};

// --- MAIN --- MANUAL --- KOPPLER ---
uint8_t menuOnExitCoupler(uint8_t arg);
const __flash Menu_t menu_coupler[] = {
	{MENU_T_VARONOFF | MENU_T_LEFTBOUND,0,"2<3",NULL,{&midi_Couplers[COUPLER_2FROM3]},NULL,menuOnExitCoupler},
	{MENU_T_VARONOFF,0,"1<3",NULL,{&midi_Couplers[COUPLER_1FROM3]},NULL,menuOnExitCoupler},
	{MENU_T_VARONOFF,0,"1<2",NULL,{&midi_Couplers[COUPLER_1FROM2]},NULL,menuOnExitCoupler},
	{MENU_T_VARONOFF,0,"P<3",NULL,{&midi_Couplers[COUPLER_PFROM3]},NULL,menuOnExitCoupler},
	{MENU_T_VARONOFF,0,"P<2",NULL,{&midi_Couplers[COUPLER_PFROM2]},NULL,menuOnExitCoupler},
	{MENU_T_VARONOFF,0,"P<1",NULL,{&midi_Couplers[COUPLER_PFROM1]},NULL,menuOnExitCoupler},
	{MENU_T_VARONOFF,0,"3<2",NULL,{&midi_Couplers[COUPLER_3FROM2]},NULL,menuOnExitCoupler},
	{MENU_T_VARONOFF,0,"3<1",NULL,{&midi_Couplers[COUPLER_3FROM1]},NULL,menuOnExitCoupler},
	{MENU_T_VARONOFF,0,"3<P",NULL,{&midi_Couplers[COUPLER_2FROM1]},NULL,menuOnExitCoupler},
	{MENU_T_VARONOFF,0,"2<1",NULL,{&midi_Couplers[COUPLER_3FROMP]},NULL,menuOnExitCoupler},
	{MENU_T_VARONOFF,0,"2<P",NULL,{&midi_Couplers[COUPLER_2FROMP]},NULL,menuOnExitCoupler},
	{MENU_T_VARONOFF| MENU_T_RIGHTBOUND,0,"1<P",NULL,{&midi_Couplers[COUPLER_1FROMP]},NULL,menuOnExitCoupler}
};

// --- MAIN --- REGISTER ----
uint8_t menuOnEnterResetReg(uint8_t arg);
uint8_t menuOnExitRegisterEdit(uint8_t arg);
uint8_t menuOnExitSaveProgram(uint8_t arg);
uint8_t menuOnExitLoadProgran(uint8_t arg);
const __flash Menu_t menu_register[] = {
	{MENU_T_VARPROG | MENU_T_LEFTBOUND,0,"Prog.lad.",NULL,{&menuVKombination},NULL,menuOnExitLoadProgran},
	{MENU_T_VARPROG,0,"Prog.sp.",NULL,{&menuVKombination},NULL,menuOnExitSaveProgram},
	{MENU_T_MENU,0,"aus",NULL,{NULL},menuOnEnterResetReg,NULL},
	{MENU_T_VARBINREG,0,"Reg.1-8",NULL,{&menuVRegisters[0]},NULL,menuOnExitRegisterEdit},
	{MENU_T_VARBINREG,0,"Reg.9-16",NULL,{&menuVRegisters[1]},NULL,menuOnExitRegisterEdit},
	{MENU_T_VARBINREG,0,"Reg.17-24",NULL,{&menuVRegisters[2]},NULL,menuOnExitRegisterEdit},
	{MENU_T_VARBINREG,0,"Reg.25-32",NULL,{&menuVRegisters[3]},NULL,menuOnExitRegisterEdit},
	{MENU_T_VARBINREG,0,"Reg.33-40",NULL,{&menuVRegisters[4]},NULL,menuOnExitRegisterEdit},
	{MENU_T_VARBINREG,0,"Reg.41-48",NULL,{&menuVRegisters[5]},NULL,menuOnExitRegisterEdit},
	{MENU_T_VARBINREG,0,"Reg.49-54",NULL,{&menuVRegisters[6]},NULL,menuOnExitRegisterEdit},
	{MENU_T_VARBINREG | MENU_T_RIGHTBOUND,0,"Reg.55-64",NULL,{&menuVRegisters[7]},NULL,menuOnExitRegisterEdit},
};

// --- MAIN --- MANUAL ----
const __flash Menu_t menu_manual[] = {
	{MENU_T_MENU_L,0,"Koppel",menu_coupler,{NULL},NULL,NULL},
	{MENU_T_MENU_R,0,"Stimmen",menu_tune,{NULL},NULL,NULL}
};

// --- MAIN ---
uint8_t menuOnUpdateRegister(uint8_t arg);
uint8_t menuOnExitKeys(uint8_t arg);
const __flash Menu_t menu_main[] = 	{
	{MENU_T_MENU_L,0,"Manual",menu_manual,{NULL},NULL,NULL},
	{MENU_T_MENU,0,"Register",menu_register,{NULL},menuOnUpdateRegister,NULL},
	{MENU_T_MENU,0,"MIDI",menu_midi,{NULL},NULL,NULL},
	{MENU_T_MENU,0,"Tasten",menu_key,{NULL},NULL,menuOnExitKeys},
	{MENU_T_MENU,0,"Status",menu_status,{NULL},NULL,NULL},
	{MENU_T_MENU_R,0,"Setup",menu_setup,{NULL},NULL,NULL}
};

//-------------------------------- SOFTKEY MENU --------------------------------

uint8_t softKeyCoupler2from3(uint8_t arg);
uint8_t softKeyCoupler1from3(uint8_t arg);
uint8_t softKeyCouplerPfrom3(uint8_t arg);
uint8_t softKeyCoupler1from2(uint8_t arg);
uint8_t softKeyCouplerPfrom2(uint8_t arg);
uint8_t softKeyCouplerPfrom1(uint8_t arg);
uint8_t softKeyCoupler3from2(uint8_t arg);
uint8_t softKeyCoupler3from1(uint8_t arg);
uint8_t softKeyCoupler3fromP(uint8_t arg);
uint8_t softKeyCoupler2from1(uint8_t arg);
uint8_t softKeyCoupler2fromP(uint8_t arg);
uint8_t softKeyCoupler1fromP(uint8_t arg);
uint8_t softKeyK1A(uint8_t arg);
uint8_t softKeyK2A(uint8_t arg);
uint8_t softKeyK3A(uint8_t arg);
uint8_t softKeyK4A(uint8_t arg);
uint8_t softKeyPrP(uint8_t arg);
uint8_t softKeyPrM(uint8_t arg);
uint8_t softKeyPrSet(uint8_t arg);
uint8_t softKeyPrInc(uint8_t arg);
uint8_t softKeyPrDec(uint8_t arg);
uint8_t softKeyPBInc(uint8_t arg);
uint8_t softKeyPBDec(uint8_t arg);
uint8_t softKeyRegOff(uint8_t arg);

const __flash char shortKeyTextNone[MENU_LCD_MENUTEXTLEN]  = "";
const __flash char shortKeyTextMenu[MENU_LCD_MENUTEXTLEN]  = "Menu";
const __flash char shortKeyTextStim[MENU_LCD_MENUTEXTLEN]  = "Stim";
const __flash char shortKeyTextSetup[MENU_LCD_MENUTEXTLEN]  = "Setu";
const __flash char shortKeyTextMIDIoff[MENU_LCD_MENUTEXTLEN]  = "MOff";
const __flash char shortKeyTextCpl23[MENU_LCD_MENUTEXTLEN]  = "2<3\x80";
const __flash char shortKeyTextCpl13[MENU_LCD_MENUTEXTLEN]  = "1<3\x80";
const __flash char shortKeyTextCplP3[MENU_LCD_MENUTEXTLEN]  = "P<3\x80";
const __flash char shortKeyTextCpl12[MENU_LCD_MENUTEXTLEN]  = "1<2\x80";
const __flash char shortKeyTextCplP2[MENU_LCD_MENUTEXTLEN]  = "P<2\x80";
const __flash char shortKeyTextCplP1[MENU_LCD_MENUTEXTLEN]  = "P<1\x80";
const __flash char shortKeyTextCpl32[MENU_LCD_MENUTEXTLEN]  = "3<2\x80";
const __flash char shortKeyTextCpl31[MENU_LCD_MENUTEXTLEN]  = "3<1\x80";
const __flash char shortKeyTextCpl3P[MENU_LCD_MENUTEXTLEN]  = "3<P\x80";
const __flash char shortKeyTextCpl21[MENU_LCD_MENUTEXTLEN]  = "2<1\x80";
const __flash char shortKeyTextCpl2P[MENU_LCD_MENUTEXTLEN]  = "2<P\x80";
const __flash char shortKeyTextCpl1P[MENU_LCD_MENUTEXTLEN]  = "1<P\x80";
const __flash char shortKeyTextK1A[MENU_LCD_MENUTEXTLEN]  = "PA1";
const __flash char shortKeyTextK2A[MENU_LCD_MENUTEXTLEN]  = "PA2";
const __flash char shortKeyTextK3A[MENU_LCD_MENUTEXTLEN]  = "PA3";
const __flash char shortKeyTextK4A[MENU_LCD_MENUTEXTLEN]  = "PA4";
const __flash char shortKeyTextPRP[MENU_LCD_MENUTEXTLEN]  = "P+/s";
const __flash char shortKeyTextPRM[MENU_LCD_MENUTEXTLEN]  = "P-/c";
const __flash char shortKeyTextPRI[MENU_LCD_MENUTEXTLEN]  = "P+";
const __flash char shortKeyTextPRD[MENU_LCD_MENUTEXTLEN]  = "P-";
const __flash char shortKeyTextPBI[MENU_LCD_MENUTEXTLEN]  = "PrB+";
const __flash char shortKeyTextPBD[MENU_LCD_MENUTEXTLEN]  = "PrB-";
const __flash char shortKeyTextPRS[MENU_LCD_MENUTEXTLEN]  = "Pset";
const __flash char shortKeyTextRegOff[MENU_LCD_MENUTEXTLEN]  = "Pclr";

const __flash Menu_t menu_selFunc[] =
	{{MENU_T_MENU_L,MENU_FLAG_MENU_SOFTKEY,"<none>",NULL,{.pString=shortKeyTextNone},NULL,NULL},
	{MENU_T_MENU,MENU_FLAG_MENU_SOFTKEY,"Menu",menu_main,{.pString=shortKeyTextMenu},NULL,NULL},
	{MENU_T_MENU,MENU_FLAG_MENU_SOFTKEY,"Stimmen",menu_tune,{.pString=shortKeyTextStim},NULL,NULL},
	{MENU_T_MENU,MENU_FLAG_MENU_SOFTKEY,"Koppel2<3",NULL,{.pString=shortKeyTextCpl23},softKeyCoupler2from3,NULL},
	{MENU_T_MENU,MENU_FLAG_MENU_SOFTKEY,"Koppel1<3",NULL,{.pString=shortKeyTextCpl13},softKeyCoupler1from3,NULL},
	{MENU_T_MENU,MENU_FLAG_MENU_SOFTKEY,"KoppelP<3",NULL,{.pString=shortKeyTextCplP3},softKeyCouplerPfrom3,NULL},
	{MENU_T_MENU,MENU_FLAG_MENU_SOFTKEY,"Koppel1<2",NULL,{.pString=shortKeyTextCpl12},softKeyCoupler1from2,NULL},
	{MENU_T_MENU,MENU_FLAG_MENU_SOFTKEY,"KoppelP<2",NULL,{.pString=shortKeyTextCplP2},softKeyCouplerPfrom2,NULL},
	{MENU_T_MENU,MENU_FLAG_MENU_SOFTKEY,"KoppelP<1",NULL,{.pString=shortKeyTextCplP1},softKeyCouplerPfrom1,NULL},
	{MENU_T_MENU,MENU_FLAG_MENU_SOFTKEY,"Koppel3<2",NULL,{.pString=shortKeyTextCpl32},softKeyCoupler3from2,NULL},
	{MENU_T_MENU,MENU_FLAG_MENU_SOFTKEY,"Koppel3<1",NULL,{.pString=shortKeyTextCpl31},softKeyCoupler3from1,NULL},
	{MENU_T_MENU,MENU_FLAG_MENU_SOFTKEY,"Koppel3<P",NULL,{.pString=shortKeyTextCpl3P},softKeyCoupler3fromP,NULL},
	{MENU_T_MENU,MENU_FLAG_MENU_SOFTKEY,"Koppel2<1",NULL,{.pString=shortKeyTextCpl21},softKeyCoupler2from1,NULL},
	{MENU_T_MENU,MENU_FLAG_MENU_SOFTKEY,"Koppel2<P",NULL,{.pString=shortKeyTextCpl2P},softKeyCoupler2fromP,NULL},
	{MENU_T_MENU,MENU_FLAG_MENU_SOFTKEY,"Koppel1<P",NULL,{.pString=shortKeyTextCpl1P},softKeyCoupler1fromP,NULL},
	{MENU_T_MENU,MENU_FLAG_MENU_SOFTKEY,"Pr.+/set",NULL,{.pString=shortKeyTextPRP},softKeyPrP,NULL},
	{MENU_T_MENU,MENU_FLAG_MENU_SOFTKEY,"Pr.-/clr",NULL,{.pString=shortKeyTextPRM},softKeyPrM,NULL},
	{MENU_T_MENU,MENU_FLAG_MENU_SOFTKEY,"Prog. 1A",NULL,{.pString=shortKeyTextK1A},softKeyK1A,NULL},
	{MENU_T_MENU,MENU_FLAG_MENU_SOFTKEY,"Prog. 2A",NULL,{.pString=shortKeyTextK2A},softKeyK2A,NULL},
	{MENU_T_MENU,MENU_FLAG_MENU_SOFTKEY,"Prog. 3A",NULL,{.pString=shortKeyTextK3A},softKeyK3A,NULL},
	{MENU_T_MENU,MENU_FLAG_MENU_SOFTKEY,"Prog. 4A",NULL,{.pString=shortKeyTextK4A},softKeyK4A,NULL},
	{MENU_T_MENU,MENU_FLAG_MENU_SOFTKEY,"Prog.clr",NULL,{.pString=shortKeyTextRegOff},softKeyRegOff,NULL},
	{MENU_T_MENU,MENU_FLAG_MENU_SOFTKEY,"Prog.set",NULL,{.pString=shortKeyTextPRS},softKeyPrSet,NULL},
	{MENU_T_MENU,MENU_FLAG_MENU_SOFTKEY,"Prog.+",NULL,{.pString=shortKeyTextPRI},softKeyPrInc,NULL},
	{MENU_T_MENU,MENU_FLAG_MENU_SOFTKEY,"Prog.-",NULL,{.pString=shortKeyTextPRD},softKeyPrDec,NULL},
	{MENU_T_MENU,MENU_FLAG_MENU_SOFTKEY,"PrBank+",NULL,{.pString=shortKeyTextPBI},softKeyPBInc,NULL},
	{MENU_T_MENU,MENU_FLAG_MENU_SOFTKEY,"PrBank.-",NULL,{.pString=shortKeyTextPBD},softKeyPBDec,NULL},
	{MENU_T_MENU,MENU_FLAG_MENU_SOFTKEY,"MIDI Off",NULL,{.pString=shortKeyTextMIDIoff},menu_OnEnterMidiPanic,NULL},
	{MENU_T_MENU_R,MENU_FLAG_MENU_SOFTKEY,"Setup",menu_setup,{.pString=shortKeyTextSetup},NULL,NULL}};

//----------------------------------------------------------------------------------

const __flash NibbleInfo_t nibbleInfo[MENU_T_COUNT] = {
	{0,{0,0,0,0,0,0,0,0}}, // MENU_T_MENU 1
	{2,{0,1,0,0,0,0,0,0}}, // MENU_T_VARBYTE 2
	{1,{3,0,0,0,0,0,0,0}}, // MENU_T_VARMIDICHAN 3
	{2,{0,2,0,0,0,0,0,0}}, // MENU_T_VARNOTE 4
	{3,{1,3,4,0,0,0,0,0}}, // MENU_T_MODBIT 5
	{3,{0,1,2,0,0,0,0,0}}, // MENU_T_VARDEC 6
	{1,{0,0,0,0,0,0,0,0}}, // MENU_T_VARMANUAL 7 // 0..3,- (0xFF)
	{1,{0,0,0,0,0,0,0,0}}, // MENU_T_VARSECTION 8 // 0..3
	{1,{0,0,0,0,0,0,0,0}}, // MENU_T_VARONOFF 9 // on 0xFF /off 0x00
	{8,{0,1,2,3,4,5,6,7}}, // MENU_T_VARBIN 10 // one byte as 8x 1/0
	{8,{0,1,2,3,4,5,6,7}}, // MENU_T_VARLONG 11 // 32bit
	{2,{0,1,0,0,0,0,0,0}}, // MENU_T_VARPROG 12 // Program 3 + 3 bit
	{2,{0,1,0,0,0,0,0,0}}, // MENU_T_VARREG 13 // Register 1..64, none
	{8,{0,1,2,3,4,5,6,7}} // MENU_T_VARBINREG 14 // one byte as 8x I/o but LSB first
};

const __flash char initMenuText[MENU_LCD_MENUTEXTLEN] = "Men\xf5";
const __flash char MenuMIDIInText[] = "In:";
const __flash char MenuMIDIOutText[] = "Out:";

// *************************************************** V A R ***************************************
const __flash Menu_t* currentMenu;
const __flash Menu_t* menuStack[MENU_MAX_STACK];  // last Menus
uint8_t menuStackIndex; // index points to free entry. index == 0 -> no parent menu

uint8_t nibbleIndex; // store nibblepos while data entry 0 = left, 0xFF = no nibble (not editing)
uint8_t nibbleCount; // current max nibbles
uint8_t nibble[MENU_MAX_NIBBLE];

uint16_t DataAdressOffset;
uint8_t dataEntry;
uint32_t dataEntry32;
uint8_t dataType;
uint8_t lcdData[MENU_LCD_DATALEN];
const __flash NibbleInfo_t* pNibbleInfo;

uint8_t menu_TestModulePattern; // 0 if no test running, 1 << n to start/run test on module "n" in main() !
uint8_t menu_TestModuleBitCounter;
uint32_t menu_TestModuleErrorList;

const __flash char* pMenuTopTitle; // Title of TopMenu: usually "Menu" - may differ in Softkey menus
uint8_t menuVmidiChan;
uint8_t menuVsection;
uint8_t menuVmanual;
uint8_t menuVkey;
uint8_t menuVmodule;
uint8_t menuVKombination;
uint8_t menuVRegisters[REGISTER_COUNT / 8];
uint8_t displayMessageArea;

const __flash Menu_t* menuVMenuSoftKey;
uint8_t menuVSoftKey; // nr of softkey selcted 0..3
uint32_t menuModVal;

uint8_t menuNote;
uint8_t menuMidiChan;
uint8_t menuSection;
uint8_t menuManual;
uint8_t menuTestModuleBit;
uint8_t menuTestData;

uint8_t soft_KeyMenuIndex[MENU_SOFTKEY_COUNT];
SoftKeyMenu_List_t soft_KeyMenu[MENU_SOFTKEY_COUNT];

uint8_t displayMenuMessage_P(const __flash char* pMessage);
void menuCheckArrowDown();

//*************************** I N D I V I D U A L   S O F T K E Y   F U N C T I O N S ******************************

uint8_t menuOnExitMidiCCreg(uint8_t arg){
	(void) arg;
	eeprom_UpdateCCreg();
	return 0;
}


uint8_t menuOnExitRegisterOut(uint8_t arg){
	(void) arg;
	eeprom_UpdateRegOut();
	return 0;
}


uint8_t menuOnExitMidiThrough(uint8_t arg){
	(void) arg;
	eeprom_UpdateMidiThrough();
	return 0;
}

void reverseRegisterBits(){
	for (uint8_t i = 0; i < REGISTER_COUNT / 8; i++){
		menuVRegisters[i] = reverse_Bits(menuVRegisters[i]);
	}
}

uint8_t menuOnUpdateRegister(uint8_t arg) {
	(void) arg;
	read_allRegister(menuVRegisters); // now exchange all bits, cause LSB
	reverseRegisterBits();
	return 0;
}

uint8_t menuOnExitRegisterEdit(uint8_t arg){
	if (arg != MESSAGE_KEY_ESC){
		// update these registers
		uint8_t regNr = (currentMenu->pVar - &(menuVRegisters[0])) << 3;
		uint8_t regBits= *(currentMenu->pVar);
		for (uint8_t i = 0; i < 8; i++) {
			register_onOff(regNr++,((regBits & 0x80) != 0) ? REGISTER_ON : REGISTER_OFF);
			regBits <<= 1;
		}
	}
	return 0;
}

uint8_t menuOnEnterResetReg(uint8_t arg){
	(void) arg;
	midi_resetRegisters();
	menuOnUpdateRegister(0);
	return 0;
}

uint8_t menuOnExitCoupler(uint8_t arg) {
	(void) arg;
	uint8_t cplNr = currentMenu->pVar - &midi_Couplers[0]; // get index in midi_Couplers[] of this menu item
	if (midi_Couplers[cplNr] != 0){
		// coupler has been set, now check if inverse coupler must be reset
		set_Coupler(cplNr); // sets coupler again, buit also checks inverse coupler
	}
	return 0;
}

uint8_t softkeyCoupler(uint8_t arg, uint8_t CplNr){
	// to be called as softkey function; arg==0 -> give status only
	if (arg != 0){
		if (midi_Couplers[CplNr] == COUPLER_OFF){
			uint8_t turnOffManual = set_Coupler(CplNr);
			if (turnOffManual != MANUAL_NONE) { // also reset inverse couple
				midi_ManualOff(turnOffManual);
			}
		} else {
			midi_Couplers[CplNr] = COUPLER_OFF;
			midi_ManualOff(cplInfo[CplNr].dest); // turn off output for coupler destination
		}
	}
	return (midi_Couplers[CplNr] == COUPLER_OFF ? MENU_SOFTKEY_FUNC_RETURN_STATUS_OFF : MENU_SOFTKEY_FUNC_RETURN_STATUS_ON);
}

uint8_t softKeyCoupler2from3(uint8_t arg){
	// currently softcoupler off stopps midi notes also!
	uint8_t result = softkeyCoupler(arg, COUPLER_2FROM3);
	return result;
}

uint8_t softKeyCoupler1from3(uint8_t arg){
	uint8_t result = softkeyCoupler(arg, COUPLER_1FROM3);
	return result;
}

uint8_t softKeyCouplerPfrom3(uint8_t arg){
	uint8_t result = softkeyCoupler(arg,COUPLER_PFROM3);
	return result;
}

uint8_t softKeyCoupler1from2(uint8_t arg){
	uint8_t result = softkeyCoupler(arg,COUPLER_1FROM2);
	return result;
}

uint8_t softKeyCouplerPfrom2(uint8_t arg){
	uint8_t result = softkeyCoupler(arg,COUPLER_PFROM2);
	return result;
}

uint8_t softKeyCouplerPfrom1(uint8_t arg){
	uint8_t result = softkeyCoupler(arg,COUPLER_PFROM1);
	return result;
}

uint8_t softKeyCoupler3from2(uint8_t arg){
	// currently softcoupler off stopps midi notes also!
	uint8_t result = softkeyCoupler(arg, COUPLER_3FROM2);
	return result;
}

uint8_t softKeyCoupler3from1(uint8_t arg){
	uint8_t result = softkeyCoupler(arg, COUPLER_3FROM1);
	return result;
}

uint8_t softKeyCoupler3fromP(uint8_t arg){
	uint8_t result = softkeyCoupler(arg,COUPLER_3FROMP);
	return result;
}

uint8_t softKeyCoupler2from1(uint8_t arg){
	uint8_t result = softkeyCoupler(arg,COUPLER_2FROM1);
	return result;
}

uint8_t softKeyCoupler2fromP(uint8_t arg){
	uint8_t result = softkeyCoupler(arg,COUPLER_2FROMP);
	return result;
}

uint8_t softKeyCoupler1fromP(uint8_t arg){
	uint8_t result = softkeyCoupler(arg,COUPLER_1FROMP);
	return result;
}

const __flash char messageSaved[] = " Reg "LCD_STRING_ARROWRIGHT" ";
const __flash char messageLoaded[] = " Reg";
const __flash char messageRegisterMan[] = "+";


void menuDisplaySaveMessage(uint8_t regNumber, uint8_t progNr){
	char* pChar = string_Buf; // utils.c
	pChar = putChar_Dec(regNumber, pChar);
	pChar = putString_P(messageSaved, pChar);
	putString_Prog(pChar, progNr);
	lcd_message(string_Buf);
}

void menuDisplayLoadMessage(uint8_t regNumber, uint8_t progNr){
	char* pChar = string_Buf; // utils.c
	pChar = putString_Prog(pChar, progNr);
	*pChar++ = LCD_CHAR_ARROW_RIGHT;
	pChar = putChar_Dec(regNumber, pChar);
	pChar = putString_P(messageLoaded, pChar);
	module_WaitOutputInput2Cycles(); // wait until new register are transferred to output and read back
	uint8_t extraRegisters = count_Registers(REGISTER_READ_HWIN_XOR_SWOUT);
	if (extraRegisters > 0){
		pChar = putString_P(messageRegisterMan, pChar);
		putChar_Dec(extraRegisters, pChar);
	}
	lcd_message(string_Buf);
}

void send_progrChange_toMidiThru(uint8_t program){
	// V 0.72 send program change to midi-through-out!
	if (program <= PROGR_MAX) {
		// check if it is a valid program nr
		if (midiThrough.OutChannel != MIDI_CHANNEL_NONE) {
			// only if out channel is valid: do as in midiKeyPress_Process
			serial1MIDISendCmd(MIDI_PRGCHG,midiThrough.OutChannel);
			// if note off: use note on an velocity = 0 to turn off note (less bytes !)
			serial1MIDISendData(program);
		} // maybe chekc if invalid program nr should be sent as all tones of?
	}
}

uint8_t handle_programKey(uint8_t arg, uint8_t program){
	if ((arg & MESSAGE_KEY_LONGPRESSED) != 0){
		// longpress
		menuDisplaySaveMessage(register_toProgram(program, TRUE),program);
	} else if (arg != 0) {
		// short press: set program
		menuDisplayLoadMessage(program_toRegister(program),program);
		send_progrChange_toMidiThru(program);
	}
	return 	((midi_CountRegisterInProgram(program) > 0) && (midi_RegisterMatchProgram(program) == 0)) ? MENU_SOFTKEY_FUNC_RETURN_STATUS_ON : MENU_SOFTKEY_FUNC_RETURN_STATUS_OFF;
}

uint8_t softKeyK1A(uint8_t arg){
	return handle_programKey(arg, 0);
}

uint8_t softKeyK2A(uint8_t arg){
	return handle_programKey(arg, 1);
}

uint8_t softKeyK3A(uint8_t arg){
	return handle_programKey(arg, 2);
}

uint8_t softKeyK4A(uint8_t arg){
	return handle_programKey(arg, 3);
}


uint8_t softKeyRegOff(uint8_t arg){
	if (arg != 0){
		midi_resetRegisters();
	}
	return 0;
}

void softKeyUpdateProg(){
	if (prog_Display <= PROGR_MAX){
		send_progrChange_toMidiThru(prog_Display);
		program_toRegister(prog_Display);
	} else {
		midi_resetRegisters();
	}
	prog_UpdDisplay = TRUE;
}

void progDec(){
	if (prog_Display == PROGR_NONE){
		prog_Display = PROGR_MAX;
	} else if (prog_Display <= PROGR_MAX) {
		prog_Display--; // also set 0-> none
	} else {
		// "invalid" prog nr: just reactivate last nr
		prog_Display &= 0x7F;
	}
}

void progInc(){
	if (prog_Display == PROGR_MAX){
		// after max prog  -> none
		prog_Display = PROGR_NONE;
	} else if (prog_Display < PROGR_MAX){
		// normal prog  -> just inc
		prog_Display++;
	} else if (prog_Display == PROGR_NONE){
		prog_Display = 0;
	} else {
		// "invalid" prog nr: just reactivate last nr
		prog_Display &= 0x7F;
	}
}

uint8_t softKeyPrP(uint8_t arg){
	if ((arg & MESSAGE_KEY_LONGPRESSED) != 0){
		// longpress: set
		if (prog_Display <= PROGR_MAX){
			// there is a program active: program current register set to program -> also resets current prog HW output
			uint8_t newProg = prog_Display | 0x80; // set MSB to deactivate display but still keep prog nr
			menuDisplaySaveMessage(register_toProgram(prog_Display, TRUE),prog_Display); // also reset prog_Display
			prog_set(newProg);
		}
	} else if (arg != 0) {
		// shortpress: PROGR_MAX program
		progInc();
		softKeyUpdateProg();
	}
	return 0;
}

uint8_t softKeyPrM(uint8_t arg){
	if ((arg & MESSAGE_KEY_LONGPRESSED) != 0){
		uint8_t newProg = prog_Display | 0x80; // set MSB to deactivate display but still keep prog nr
		midi_resetRegisters();
		prog_set(newProg);  // set MSB to deactivate display but still keep prog nr
	} else if (arg != 0) {
		// shortpress: PROGR_MAX program
		progDec();
		softKeyUpdateProg();
	}
	return 0;
}

uint8_t softKeyPrSet(uint8_t arg) {
	if ((arg != 0) && (prog_Display <= PROGR_MAX)) {
		uint8_t newProg = prog_Display | 0x80; // set MSB to deactivate display but still keep prog nr
		menuDisplaySaveMessage(register_toProgram(prog_Display, TRUE),prog_Display);
		prog_set(newProg);
	}
	return 0;
}

uint8_t softKeyPrInc(uint8_t arg){
	if (arg != 0) {
		if ((arg & MESSAGE_KEY_LONGPRESSED) != 0){
			// longpress: bank increment (8 program steps)
			if (prog_Display <= PROGR_MAX){
				// there is a program active: program current register set to program
				prog_Display = (prog_Display + 8) & 0x38;
			}
		} else if (arg != 0) {
			// shortpress:  program
			progInc();
		}
		softKeyUpdateProg();
	}
	return 0;
}
uint8_t softKeyPrDec(uint8_t arg){
	if (arg != 0) {
		if ((arg & MESSAGE_KEY_LONGPRESSED) != 0){
			// longpress: bank increment (8 program steps)
			if (prog_Display <= PROGR_MAX){
				// there is a program active: program current register set to program
				prog_Display = (prog_Display - 8) & 0x38;
			}
		} else if (arg != 0) {
			progDec();
			// shortpress:  program
		}
		softKeyUpdateProg();
	}
	return 0;
}
uint8_t softKeyPBInc(uint8_t arg){
	if (arg != 0) {
		//  bank increment (8 program steps)
		//if (prog_Display != PROGR_NONE){
			// there is a program active: program current register set to program
			prog_Display = (prog_Display + 8) & 0x38;
			softKeyUpdateProg();
		//}
	}
	return 0;
}
uint8_t softKeyPBDec(uint8_t arg){
	if (arg != 0) {
		// there is a program active: program current register set to program
		//if (prog_Display != PROGR_NONE){
			prog_Display = (prog_Display - 8) & 0x38;
			softKeyUpdateProg();
		//}
	}
	return 0;
}


//*************************** I N D I V I D U A L   M E N U   F U N C T I O N S ******************************

uint8_t menuOnExitSaveProgram(uint8_t arg){
	if ((arg != MESSAGE_KEY_ESC) && (menuVKombination < PROGRAM_COUNT)){
		register_toProgram(menuVKombination, TRUE);
	}
	return 0;
}
uint8_t menuOnExitLoadProgran(uint8_t arg){
	if ((arg != MESSAGE_KEY_ESC) && (menuVKombination < PROGRAM_COUNT)){
		program_toRegister(menuVKombination);
	}
	menuOnUpdateRegister(0);
	return 0;
}

uint8_t menuOnEnterPwrOn(uint8_t arg) {
	(void) arg;
	POWER_ON
	pipe_PowerStatus = POWERSTATE_FORCE_ON;
	menu_showPowerState();
	return 0;
}

uint8_t menuOnEnterPwrOff(uint8_t arg){
	(void) arg;
	POWER_OFF
	pipe_PowerStatus = POWERSTATE_FORCE_OFF;
	menu_showPowerState();
	return 0;
}

uint8_t menuOnEnterPwrRest(uint8_t arg){
	POWER_OFF
	(void) arg;
	pipe_PowerStatus = POWERSTATE_WAIT_FOR_KEY_REALEASE;
	menu_showPowerState();
	TIMER_SET(TIMER_POWER,TIMER_POWER_INIT_MS)
	return 0;
}

uint8_t menuOnExitKeys(uint8_t arg){
	(void) arg;
	eeprom_UpdateSoftkeys();
	return 0;
}

const __flash char menuMessageMIDIpanic[]  = "MIDI Noten aus";

uint8_t menu_OnEnterMidiPanic(uint8_t arg){
	(void) arg;
	lcd_message_P(menuMessageMIDIpanic);
	midiSendAllNotesOff();
	menuCursorSetMenu();
	return 0;
}

uint8_t menu_ModuleTestPattern(uint8_t arg){
	(void) arg;
	menu_TestModulePattern = 1 << menuVmodule;
	menu_TestModuleBitCounter = MENU_TESTMODULE_STARTFLAG;
	menu_TestModuleErrorList = 0;
	menu_ModuleTestExecute();
	return 0;
}

const __flash char menuMessageAbort[] = "abort";
const __flash char menuMessageOK[] = "ok ";
const __flash char menuMessageE[] = "E:";
void menu_ModuleTestExecute(){
	// menu_TestModuleBitCounter: START->0, 0->1...31->END, END
	// ... ABORT->END, END
	if ((menu_TestModuleBitCounter == MENU_TESTMODULE_STARTFLAG) || (menu_TestModuleBitCounter == MENU_TESTMODULE_ABORTFLAG)){
		// first call: clean up before first test
		lcd_cursoroff();
		menu_ClearDataDisp();
		MESSAGE_PIPE_HANDLING_OFF // message might be generated but not handled in main now!
		Pipe_t* pPipe = &(pipe[0]);
		// all outputs of this module off
		for (uint8_t i = 0; i < PIPE_SHIFTBIT_COUNT; i++){
			pPipe->pipeOut |= menu_TestModulePattern;
			pPipe++;
		}
		if (menu_TestModuleBitCounter == MENU_TESTMODULE_STARTFLAG){
			menu_TestModuleBitCounter = 0;
		} else {
			lcd_message_P(menuMessageAbort);
			menu_TestModuleBitCounter = MENU_TESTMODULE_ENDFLAG;
			TIMER_SET(TIMER_TESTMODULE,TIMER_TESTMODEND_MS)
			menuCursorSetMenu();
		}
	} else if (menu_TestModuleBitCounter == MENU_TESTMODULE_ENDFLAG) {
		MESSAGE_PIPE_HANDLING_ON // message might be generated but not handled in main now!
		menu_TestModulePattern = 0; // notify that test is finished
		// no change in menu_TestModuleBitCounter
		lcd_cursosblink();
	} else {
		// second and following calls, BitCOunt = 0..31
		// test input of old bit
		menu_TestModuleErrorList >>= 1;
		if ((pipe[menu_TestModuleBitCounter].pipeIn & menu_TestModulePattern) == 0){
			// error: module input is not 1
			menu_TestModuleErrorList |= 0x80000000;
		}
		// now old output off
		pipe[menu_TestModuleBitCounter].pipeOut |= menu_TestModulePattern;
		menu_TestModuleBitCounter++;
	}
	// now menu_TestModuleBitCounter is new bitnr
	if (menu_TestModuleBitCounter < PIPE_SHIFTBIT_COUNT){
		// valid new bit, activate output
		pipe[menu_TestModuleBitCounter].pipeOut &= ~menu_TestModulePattern;
		lcd_goto(MENU_LCD_CURSOR_DATA);
		lcd_dec2out(menu_TestModuleBitCounter);
		// timer for next bit
		TIMER_SET(TIMER_TESTMODULE,TIMER_TESTMODULE_MS)
	} else if (menu_TestModuleBitCounter == PIPE_SHIFTBIT_COUNT) {
		// this was the last one
		if (menu_TestModuleErrorList == 0){
			lcd_message_P(menuMessageOK);
		} else {
			editLong.longval = menu_TestModuleErrorList;
			char *buffer = string_Buf;
			buffer = putString_P(menuMessageE,buffer);
			buffer = putChar_long(menu_TestModuleErrorList, buffer);
			*buffer = 0;
			lcd_message(string_Buf);
		}
		menu_TestModuleBitCounter = MENU_TESTMODULE_ENDFLAG;
		TIMER_SET(TIMER_TESTMODULE,TIMER_TESTMODEND_MS)
		menuCursorSetMenu();
	}
	//
}

uint8_t menu_enterWriteModule(uint8_t arg){
	(void) arg;
	menuModVal = 0;
	uint8_t moduleMask = 1 << menuVmodule;
	Pipe_t* pPipe = &(pipe[PIPE_SHIFTBIT_COUNT-1]);
	for (uint8_t i = 0; i < PIPE_SHIFTBIT_COUNT; i++){
		menuModVal <<= 1;
		if ((pPipe->pipeOut & moduleMask) != 0){
			menuModVal |= 1;
		}
		pPipe--;
	}
	return 0;
}

uint8_t menu_exitWriteModule(uint8_t arg){
	uint32_t writeVal = menuModVal;
	if (arg == MESSAGE_KEY_SEL){
		uint8_t moduleMask = 1 << menuVmodule;
		Pipe_t* pPipe = &(pipe[PIPE_SHIFTBIT_COUNT-1]); // points to MSB
		for (uint8_t i = 0; i < PIPE_SHIFTBIT_COUNT; i++){
			if ((writeVal & 0x80000000) != 0){ // test MSB
				pPipe->pipeOut |= moduleMask;
			} else {
				pPipe->pipeOut &= ~moduleMask;
			}
			writeVal <<= 1; // shift up
			pPipe--;
		}
	}
	return 0;
}

uint8_t menu_readModule(uint8_t arg){
	(void) arg;
	uint32_t readVal = 0;
	uint8_t moduleMask = 1 << menuVmodule;
	Pipe_t* pPipe = &(pipe[PIPE_SHIFTBIT_COUNT-1]); // Point to MSB (31)
	for (uint8_t i = 0; i < PIPE_SHIFTBIT_COUNT; i++){
		readVal <<= 1;	// shift result up
		if ((pPipe->pipeIn & moduleMask) != 0){
			readVal |= 1; // eventually set LSB (will be shifted up)
		}
		pPipe--;
	}
	lcd_goto(MENU_LCD_CURSOR_DATA);
	editLong.longval = readVal;
	lcd_longout();
	return 0;
}

uint8_t menu_testModule(uint8_t arg){
	(void) arg;
	lcd_goto(MENU_LCD_CURSOR_DATA);
	editLong.longval = test_PipeModule(menuVmodule);
	lcd_longout();
	return 0;
}

uint8_t menuOnEnterModSel(uint8_t arg){
	(void) arg;
	menuVmodule = currentMenu->tag; // set Module from tag (dual use of pFunc)
	return 0;
};

uint8_t menuOnEnterMidiInCh(uint8_t arg){
	(void) arg;
	menuVmidiChan = currentMenu->tag; // set MidiChanel from tag (dual use of pFunc)
	return 0;
}

uint8_t menuOnEnterMidiInSec(uint8_t arg){
	(void) arg;
	menuVsection = currentMenu->tag; // set Section from tag (dual use of pFunc);
	DataAdressOffset = (&(midiInMap[menuVmidiChan & 0x0F][menuVsection & 0x03]) - &(midiInMap[0][0])) * sizeof(MidiInMap_t);
	return 0;
}

uint8_t menuOnEnterModManual(uint8_t arg){
	(void) arg;
	menuVmanual = currentMenu->tag; // set Section from tag (dual use of pFunc);
	return 0;
}

uint8_t menuOnEnterModSec(uint8_t arg){
	(void) arg;
	menuVsection = currentMenu->tag; // set Section from tag (dual use of pFunc);
	DataAdressOffset = (&(manualMap[menuVmanual & 0x0F][menuVsection & 0x03]) - &(manualMap[0][0])) * sizeof(ManualMap_t);
	return 0;
}

uint8_t menuOnEnterModSecReg(uint8_t arg){
	(void) arg;
	menuVsection = currentMenu->tag; // set Section from tag (dual use of pFunc);
	DataAdressOffset = (&(registerMap[menuVsection & 0x07]) - &(registerMap[0])) * sizeof(RegisterMap_t);
	return 0;
}

uint8_t menuOnEnterRegOut(uint8_t arg){
	(void) arg;
	menuVsection = currentMenu->tag; // set Section from tag (dual use of pFunc);
	DataAdressOffset = (&(reg_Out[menuVsection & 0x07]) - &(reg_Out[0])) * sizeof(RegOut_t);
	return 0;
}


uint8_t menuOnEnterKey(uint8_t arg){
	(void) arg;
	uint8_t softKeyNr;
	softKeyNr = currentMenu->tag;
	if (softKeyNr < MENU_SOFTKEY_COUNT){
		menuVMenuSoftKey = soft_KeyMenu[softKeyNr].pSelMenu;
	}
	return 0;
}

uint8_t menuOnExitKey(uint8_t arg){
	(void) arg;
	uint8_t softKeyNr;
	softKeyNr = currentMenu->tag;
	softKey_Set(menuVMenuSoftKey,softKeyNr);
	eeprom_UpdateSoftkeys();
	return 0;
}

const char stringNotAssigen [] PROGMEM = "unassigned";
uint8_t menuOnEnterTune(uint8_t arg){
	(void) arg;
	static uint8_t minManNote;
	static uint8_t maxManNote;
	static uint8_t notOnOff;
	uint8_t result = TRUE;
	// arg is message
	if (arg == MESSAGE_KEY_NONE){
		// start: edit manual, set key to 0 to indicate that
		minManNote = MIDI_NOTE_NONE; // set to 0xFF as start to find lowest note of manual
		maxManNote = 0;
		menuVmanual = currentMenu->tag;
		if (menuVmanual > MANUAL_P) {
			menuVmanual = MANUAL_III;
		}
		for (uint8_t i = 0; i < RANGE_COUNT; i++){
			if (manualMap[menuVmanual][i].startNote < minManNote){
				minManNote = manualMap[menuVmanual][i].startNote;
			}
			if (manualMap[menuVmanual][i].endNote > maxManNote){
				maxManNote = manualMap[menuVmanual][i].endNote;
			}
		}
		if (minManNote > MIDI_NOTE_MAX){
			// manual not assigned
			lcd_goto(MENU_LCD_CURSOR_DATA);
			lcd_puts_P(stringNotAssigen);
			menuNote = MIDI_NOTE_NONE; // wait till next message to exit
		} else {
			menuNote = minManNote;
			notOnOff = NOTE_OFF;
		}
		keylabel_set(0,keylabel_exit);
		keylabel_set(1,keylabel_onoff);
		keylabel_set(2,keylabel_minus);
		keylabel_set(3,keylabel_plus);
		keylabel_toLCD();
	} else if (menuNote == MIDI_NOTE_NONE) {
		result = FALSE;	// next message after manual not assigend, now exit
	} else if (arg == MESSAGE_KEY_RIGHT) {
		if (menuNote < maxManNote){
			manual_NoteOnOff(menuVmanual,menuNote,NOTE_OFF);
			menuNote++;
			if (notOnOff == NOTE_ON){
				manual_NoteOnOff(menuVmanual,menuNote,NOTE_ON);
			}
		}
	} else if (arg == MESSAGE_KEY_LEFT) {
		if (menuNote > minManNote){
			manual_NoteOnOff(menuVmanual,menuNote,NOTE_OFF);
			menuNote--;
			if (notOnOff == NOTE_ON){
				manual_NoteOnOff(menuVmanual,menuNote,NOTE_ON);
			}
		}
	} else if (arg == MESSAGE_KEY_DOWN) {
		if (notOnOff == NOTE_OFF){
			notOnOff = NOTE_ON;
		} else {
			notOnOff = NOTE_OFF;
		}
		manual_NoteOnOff(menuVmanual,menuNote,notOnOff);
	} else if ((arg == MESSAGE_KEY_UP) || (arg == MESSAGE_KEY_ESC)) {
		manual_NoteOnOff(menuVmanual,menuNote,NOTE_OFF);
		result = FALSE;
	} else if (arg == MESSAGE_KEY_SEL) {
		manual_NoteOnOff(menuVmanual,menuNote,NOTE_OFF);
		result = FALSE;
	}
	if (result == TRUE){
		// show status
		if (menuNote != MIDI_NOTE_NONE) {
			// not if "unassigend" is printed before
			lcd_goto(MENU_LCD_CURSOR_DATA);
			lcd_noteOut(menuNote);
			lcd_putc(' ');
			if (notOnOff == NOTE_OFF){
				lcd_putc('a');
				lcd_putc('u');
				lcd_putc('s');
				} else {
				lcd_putc('e');
				lcd_putc('i');
				lcd_putc('n');
			}
			if (keylabel_statcheck(1,(notOnOff != NOTE_OFF)) != 0) {
				keylabel_toLCD();
			}
		}
		lcd_goto(MENU_LCD_CURSOR_DATA);
	}
	return result;
}

uint8_t menuOnExitMidiActiveSense(uint8_t arg){
	(void) arg;
	eeprom_UpdateMidiOutMap();
	return 0;
}

uint8_t menuOnEnterStatusMidiIn(uint8_t arg){
	(void) arg;
	uint8_t byteCount;
	uint8_t *pByte;
	menuCursorSetExtra();
	lcd_puts_P(MenuMIDIInText);
	lcd_wordout(midiRxBytesCount);
	lcd_putc('-');
	// 3 bytes out of in buffer
	if (midiRxBytesCount < 4) {
		byteCount = midiRxBytesCount;
	} else {
		byteCount = 4;
	}
	pByte = & (midiRxBuffer[midiRxInIndex]);
	pByte--;
	while (byteCount > 0){
		if (pByte < &(midiRxBuffer[0])){
			pByte = &(midiRxBuffer[MIDI_RX_BUFFER_SIZE-1]);
		}
		lcd_hexout(*pByte--);
		if (--byteCount != 0) {
			lcd_putc(' ');
		}
	}
	return 0;
}
uint8_t menuOnEnterStatusMidiOut(uint8_t arg){
	(void) arg;
	uint8_t byteCount;
	uint8_t *pByte;
	menuCursorSetExtra();
	lcd_puts_P(MenuMIDIOutText);
	lcd_wordout(midiTxBytesCount);
	lcd_putc('-');
	// 3 bytes out of in buffer
	if (midiTxBytesCount < 4) {
		byteCount = midiTxBytesCount;
		} else {
		byteCount = 4;
	}
	pByte = & (midiTxBuffer[midiTxInIndex]);
	pByte--;
	while (byteCount > 0){
		if (pByte < &(midiTxBuffer[0])){
			pByte = &(midiTxBuffer[MIDI_TX_BUFFER_SIZE-1]);
		}
		lcd_hexout(*pByte--);
		if (--byteCount != 0) {
			lcd_putc(' ');
		}
	}
	return 0;
}

uint8_t menuOnExitMidiIn(uint8_t arg){
	(void) arg;
	eeprom_UpdateMidiInMap();
	return 0;
}

uint8_t menuOnExitMidiOut(uint8_t arg){
	(void) arg;
	eeprom_UpdateMidiOutMap();
	return 0;
}

uint8_t menuOnExitManual(uint8_t arg){
	(void) arg;
	eeprom_UpdateManualMap();
	registers_CalcCount();
	eeprom_UpdateReg();
	Midi_updateManualRange();
	return 0;
}

uint8_t menuOnExitModules(uint8_t arg){
	(void) arg;
	eeprom_UpdateModules();
	return 0;
}

const char logNone [] PROGMEM = "<none>";

uint8_t menuOnEnterLogDisp(uint8_t arg) {
	(void) arg;
	static uint8_t logEntryNr;
	static uint8_t showText;
	uint8_t continueLogMenu = TRUE;
	// arg is message
	if (arg == MESSAGE_KEY_NONE){
		logEntryNr = log_count()-1; // may be invalid, but checked later
		showText = FALSE;
		keylabel_set(0,keylabel_exit);
		keylabel_set(1,keylabel_text);
		keylabel_toLCD();
	} else if (arg == MESSAGE_KEY_LEFT) {
		if (logEntryNr != 0) {
			logEntryNr--;
		}
	} else if (arg == MESSAGE_KEY_RIGHT) {
		if (logEntryNr+1 < log_count()) {
			logEntryNr++;
		}
	} else if ((arg == MESSAGE_KEY_DOWN) || (arg == MESSAGE_KEY_SEL)) {
		showText = ~showText;
	} else {
		continueLogMenu = FALSE;
	}
	if (continueLogMenu == TRUE){
		// show LogDisp
		menuCursorSetExtra();
		if (log_count() == 0){
			lcd_puts_P(logNone);
			continueLogMenu = FALSE;
		} else {
			lcd_dec2out(logEntryNr+1);
			lcd_putc(':');
			if (showText == FALSE){
				lcd_puts(log_getShortTextFromIndex(logEntryNr,LOG_CHAR_READ));
			} else {
				lcd_puts_P(log_getErrorText(logEntryNr));
			}
			lcd_clrEol();
			menuCursorSetExtra();
		}
		keylabel_statcheck(1,(showText == TRUE)); // ignore output
		if (logEntryNr+1 < log_count()){
			keylabel_set(3,keylabel_right);
		} else {
			keylabel_clr(3);
		}
		if (logEntryNr > 0){
			keylabel_set(2,keylabel_left);
		} else {
			keylabel_clr(2);
		}
		keylabel_toLCD();
	}
	return continueLogMenu;
}


const char msg_programming1[] PROGMEM = "save...";
const char msg_programming2[] PROGMEM = "ok     ";

void menuLCDwriteOK(){
	lcd_message_P(menuMessageOK);
}

uint8_t menuOnEnterEEBackup(uint8_t arg){
	(void) arg;
	lcd_goto(MENU_LCD_CURSOR_DATA);
	lcd_puts_P(msg_programming1);
	eeprom_Backup();
	lcd_goto(MENU_LCD_CURSOR_DATA);
	lcd_puts_P(msg_programming2);
	return 0;
}

uint8_t menuOnEnterEERestore(uint8_t arg){
	(void) arg;
	lcd_goto(MENU_LCD_CURSOR_DATA);
	lcd_puts_P(msg_programming1);
	eeprom_Restore();
	lcd_goto(MENU_LCD_CURSOR_DATA);
	lcd_puts_P(msg_programming2);
	return 0;
}

uint8_t menuOnEnterEEUpdate(uint8_t arg){
	(void) arg;
	lcd_goto(MENU_LCD_CURSOR_DATA);
	lcd_puts_P(msg_programming1);
	eeprom_UpdateALL();
	lcd_goto(MENU_LCD_CURSOR_DATA);
	lcd_puts_P(msg_programming2);
	return 0;
}

const char usbEmpty [] PROGMEM = "empty\r\n";
const char usbLog [] PROGMEM = "Log\r\n";

uint8_t menuOnEnterUSBprotokoll(uint8_t arg){
	(void) arg;
	serial0SER_USB_sendCRLF();
	serial0SER_USB_sendStringP(usbLog);
	uint8_t count = log_count();
	if (count == 0) {
			serial0SER_USB_sendStringP(usbEmpty);
	} else {
		while (count-- > 0){
			serial0SER_USB_sendString(log_getShortTextFromIndex(count,LOG_CHANGENOTIFYNO));
			serial0SER_USB_sendStringP(cr_lf);
			serial0SER_USB_sendStringP(log_getErrorText(count));
			serial0SER_USB_sendStringP(cr_lf);
		}
	}
	return 0;
}

const char HelloMsg [] PROGMEM = "\r\nMIDI-Organ-Interface\r\n";

uint8_t menuOnExitUSBactive(uint8_t arg){
	(void) arg;
	eeprom_UpdateUSB();
	if (serUSB_Active == TRUE){
		serial0SER_USB_sendStringP(cr_lf);
		serial0SER_USB_sendStringP(HelloMsg);
		serial0SER_USB_sendStringP(sw_version);
		serial0SER_USB_sendStringP(cr_lf);
	}
	return 0;
}

const char usbHWtitel [] PROGMEM = "Hardware Configuration\r\n";
const char usbHWmodulInst [] PROGMEM = "Modules assigned: ";
const char usbHWmodulCheck [] PROGMEM = "Modules checked: ";
const char usbHWManual [] PROGMEM = "Manual: ";
const char usbHWRange [] PROGMEM = "Range ";
const char usbHWRegister [] PROGMEM = "Register:\r\n";
const char usbHWempty [] PROGMEM = "empty";
const char usbHWmodule [] PROGMEM = "Module:";
const char usbHWBits [] PROGMEM = ", Bits:";
const char usbHWmidichanSW [] PROGMEM = "direct MIDI-Out(int) for manual: ";
const char usbHWmidiIn [] PROGMEM = "Midi-In:";
const char usbHWmidiOut [] PROGMEM = "Midi-Out:";
const char usbHWmidiThru [] PROGMEM = "Midi-Thru: ";
const char usbHWnone [] PROGMEM = "none";
const char usbHWRegLayout [] PROGMEM = "Register Layout:\r\n";
const char usbHWCC [] PROGMEM = "Register On/Off CC for MIDI In/Out:\r\n";

uint8_t menuOnEnterUSBsendHW(uint8_t arg){
	(void) arg;
	char* buffer;
	serial0SER_USB_sendCRLF();
	serial0SER_USB_sendStringP(usbHWtitel);
	serial0SER_USB_sendCRLF();
	serial0SER_USB_sendStringP(usbHWmodulInst);
	buffer = putChar_hex(pipe_Module.AssnRead,string_Buf);
	*buffer++ = 'r';
	*buffer++ = ' ';
	buffer = putChar_hex(pipe_Module.AssnWrite,buffer);
	*buffer++ = 'w';
	serial0SER_USB_sendString(string_Buf);
	serial0SER_USB_sendCRLF();
	serial0SER_USB_sendStringP(usbHWmodulCheck);
	putChar_hex(pipe_ModuleTested,string_Buf);
	serial0SER_USB_sendString(string_Buf);
	serial0SER_USB_sendCRLF();
	serial0SER_USB_sendCRLF();
	for (uint8_t manual = 0; manual < MANUAL_COUNT; manual++){
		// out manual
		serial0SER_USB_sendStringP(usbHWManual);
		putChar_Manual(manual, string_Buf);
		serial0SER_USB_sendString(string_Buf);
		serial0SER_USB_sendCRLF();
		for (uint8_t range = 0; range < RANGE_COUNT; range++){
			// out range
			serial0SER_USB_sendStringP(usbHWRange);
			serial0SER_USBSend('0'+range);
			serial0SER_USBSend(':');
			serial0SER_USBSend(' ');
			buffer = putChar_hex(manualMap[manual][range].startNote, string_Buf);
			*buffer++ = '.';
			buffer = putChar_hex(manualMap[manual][range].endNote, buffer);
			*buffer++ = '.';
			buffer = putChar_hex(manualMap[manual][range].bitStart, buffer);
			*buffer++ = ' ';
			*buffer++ = '=';
			*buffer++ = ' ';
			serial0SER_USB_sendString(string_Buf);
			if (manualMap[manual][range].startNote > 0x7F){
				serial0SER_USB_sendStringP(usbHWempty);
			} else {
				buffer = putChar_Note(manualMap[manual][range].startNote, string_Buf);
				*buffer++ = '-';
				buffer = putChar_Note(manualMap[manual][range].endNote, buffer);
				*buffer++ = ' ';
				*buffer++ = '\0';
				serial0SER_USB_sendString(string_Buf);
				serial0SER_USB_sendStringP(usbHWmodule);
				serial0SER_USBSend('0'+(manualMap[manual][range].bitStart >> 5));
				serial0SER_USB_sendStringP(usbHWBits);
				buffer = putChar_Dec2(manualMap[manual][range].bitStart & 0x1F,string_Buf);
				*buffer++ = '-';
				buffer = putChar_Dec2((manualMap[manual][range].bitStart & 0x1F) + manualMap[manual][range].endNote - manualMap[manual][range].startNote,buffer);
				serial0SER_USB_sendString(string_Buf);
			}
			serial0SER_USB_sendCRLF();
		}
		// V 0.61 sw_channel here too, because it relates to HW
		serial0SER_USB_sendStringP(usbHWmidichanSW);
		buffer = putChar_MidiChan(midiOutMap[manual].sw_channel,string_Buf);
		serial0SER_USB_sendString(string_Buf);
		serial0SER_USB_sendCRLF();
		serial0SER_USB_sendCRLF();
	}
	// Register
	serial0SER_USB_sendStringP(usbHWRegister);
	for (uint8_t range = 0; range < REGISTER_SEC_COUNT; range++){
		// out range
		serial0SER_USB_sendStringP(usbHWRange);
		serial0SER_USBSend('0'+range);
		serial0SER_USBSend(':');
		serial0SER_USBSend(' ');
		buffer = putChar_hex(registerMap[range].startReg, string_Buf);
		*buffer++ = '.';
		buffer = putChar_hex(registerMap[range].endReg, buffer);
		*buffer++ = '.';
		buffer = putChar_hex(registerMap[range].bitStart, buffer);
		*buffer++ = ' ';
		*buffer++ = '=';
		*buffer++ = ' ';
		*buffer = '\0';
		serial0SER_USB_sendString(string_Buf);
		if (registerMap[range].startReg == REGISTER_NONE){
			serial0SER_USB_sendStringP(usbHWempty);
		} else {
			buffer = string_Buf;
			*buffer++ = 'R';
			*buffer++ = '.';
			buffer = putChar_Dec(registerMap[range].startReg+1, buffer);
			*buffer++ = '-';
			buffer = putChar_Dec(registerMap[range].endReg+1, buffer);
			*buffer++ = ' ';
			*buffer++ = '\0';
			serial0SER_USB_sendString(string_Buf);
			serial0SER_USB_sendStringP(usbHWmodule);
			serial0SER_USBSend('0'+(registerMap[range].bitStart >> 5));
			serial0SER_USB_sendStringP(usbHWBits);
			buffer = putChar_Dec2(registerMap[range].bitStart & 0x1F,string_Buf);
			*buffer++ = '-';
			buffer = putChar_Dec2((registerMap[range].bitStart & 0x1F) + registerMap[range].endReg - registerMap[range].startReg,buffer);
			serial0SER_USB_sendString(string_Buf);
		}
		serial0SER_USB_sendCRLF();
	}
	serial0SER_USB_sendStringP(usbHWRegLayout);
	for (uint8_t i = 0; i < REGOUT_LEN; i++){
		if (reg_Out[i].regStart < REGISTER_COUNT){
			// valid entry
			buffer = string_Buf;
			*buffer++ = '@';
			buffer = putChar_hex(reg_Out[i].cursor,buffer);
			*buffer++ = ' ';
			if (reg_Out[i].manualChar > ' ' && reg_Out[i].manualChar < 0x7F){
				*buffer++ = reg_Out[i].manualChar;
			} else {
				*buffer++ = ' ';
			}
			*buffer++ = ' ';
			buffer = putChar_Dec2(reg_Out[i].regStart+1,buffer);
			*buffer++ = '-';
			buffer = putChar_Dec2(reg_Out[i].regEnd+1,buffer);
			buffer = '\0';
			serial0SER_USB_sendString(string_Buf);
			serial0SER_USB_sendCRLF();
		}
	}
	// MIDI
	serial0SER_USB_sendCRLF();
 	serial0SER_USB_sendStringP(usbHWmidiIn);
	serial0SER_USB_sendCRLF();
	uint8_t anyMidiInAssigned = FALSE;
	for (uint8_t midiChan = MIDI_CHANNEL_1; midiChan <= MIDI_CHANNEL_MAX; midiChan++){
		for (uint8_t section = 0; section < MIDI_SPLIT_COUNT; section++){
			if (midiInMap[midiChan][section].manual != MANUAL_NONE) {
				anyMidiInAssigned = TRUE; 	// midichanel is assigned to a manual
				buffer = string_Buf;
				buffer = putChar_MidiChan(midiChan,buffer); // print MidiChannel
				*buffer++ = '(';
				buffer = putChar_Note(midiInMap[midiChan][section].midiNote, buffer);
				*buffer++ = '-';
				buffer = putChar_Note(midiInMap[midiChan][section].midiNote + midiInMap[midiChan][section].noteRange, buffer);
				*buffer++ = ')';
				*buffer++ = ' ';
				*buffer++ = '>';
				buffer = putChar_Manual(midiInMap[midiChan][section].manual, buffer);
				*buffer++ = '(';
				buffer = putChar_Note(midiInMap[midiChan][section].manualNote, buffer);
				*buffer++ = ')';
				*buffer++= '\0';
				serial0SER_USB_sendString(string_Buf);
				serial0SER_USB_sendCRLF();
			}
		}
	}
	if (anyMidiInAssigned == FALSE){
		buffer = string_Buf;
		serial0SER_USB_sendStringP(usbHWnone);
		serial0SER_USB_sendCRLF();
	}
	serial0SER_USB_sendCRLF();
	serial0SER_USB_sendStringP(usbHWmidiOut);
	serial0SER_USB_sendCRLF();
	for (uint8_t manual = 0; manual < MANUAL_COUNT; manual++){
		buffer = string_Buf;
		buffer = putChar_Manual(manual, buffer);
		*buffer++ = ':';
		if (midiOutMap[manual].hw_channel != MIDI_CHANNEL_NONE) {
			buffer = putChar_MidiChan(midiOutMap[manual].hw_channel, buffer);
		} else {
			*buffer++ = '-';
		}
		*buffer++= '\0';
		serial0SER_USB_sendString(string_Buf);
		serial0SER_USB_sendCRLF();
	}
	serial0SER_USB_sendCRLF();
	serial0SER_USB_sendStringP(usbHWmidiThru);
	buffer = string_Buf;
	buffer = putChar_MidiChan(midiThrough.InChannel,buffer);
	*buffer++= '>';
	buffer = putChar_MidiChan(midiThrough.OutChannel,buffer);
	*buffer++= '\0';
	serial0SER_USB_sendString(string_Buf);
	serial0SER_USB_sendCRLF();
	// Register CC On/Off In/Out
	serial0SER_USB_sendStringP(usbHWCC);
	buffer = string_Buf;
	*buffer++ = 'I';
	*buffer++ = ':';
	buffer = putChar_hex(midi_ccReg.ccInRegOn,buffer);
	*buffer++ = ',';
	buffer = putChar_hex(midi_ccReg.ccInRegOff,buffer);
	*buffer++ = ' ';
	*buffer++ = 'O';
	*buffer++ = ':';
	buffer = putChar_hex(midi_ccReg.ccOutRegOn,buffer);
	*buffer++ = ',';
	buffer = putChar_hex(midi_ccReg.ccOutRegOff,buffer);
	*buffer++= '\0';
	serial0SER_USB_sendString(string_Buf);
	serial0SER_USB_sendCRLF();
	return 0;
}

//*********************************************** F U N C T I O N S ******************************
// general menu handling
// Public

void menu_Init(const __flash Menu_t* newMenu, const __flash char* pTitle){
	menuStackIndex = 0; // no parent
	if (newMenu == NULL){
		currentMenu = menu_main; // Main Menu
		pMenuTopTitle = initMenuText;
	} else {
		currentMenu = newMenu;
		pMenuTopTitle = pTitle;
	}
	nibbleIndex = NIBBLE_NONE; // not editing
	pNibbleInfo = &(nibbleInfo[0]); // entry for MENU_T_MENU
}

void menu_InitLCD(){
	menuClearExtraDisp(); // V0.56
	menuItemChanged(); // init pNibbleInfo, dataType, dataEntry and print Data or clear data space
	menuParentMenuToLCD(); // print name of parent menu
	menuCurrMenuToLCD();
	lcd_cursosblink(); // start blinking
}

//************************ I N T E R N A L    F U N C T I O N S ******************************

// --------------------Softkey Labels

void softkeyLeft(){
	keylabel_set(2,keylabel_left);
}

void softkeyRight(){
	keylabel_set(3,keylabel_right);
}

void softkeyDown(){
	keylabel_set(1,keylabel_down);
}

void softkeyOn(){
	keylabel_set(1,keylabel_on);
}
void softkeyOff(){
	keylabel_set(1,keylabel_off);
}

void softkeyUp(){
	keylabel_set(0,keylabel_up);
}

void softkeyPlus(){
	if ((dataType == MENU_T_VARBIN) || (dataType == MENU_T_VARBINREG)) {
		keylabel_set(0,keylabel_1);
	} else {
		keylabel_set(0,keylabel_plus);
	}
}

void softkeyMinus(){
	if ((dataType == MENU_T_VARBIN) || (dataType == MENU_T_VARBINREG)) {
		keylabel_set(1,keylabel_0);
	} else {
		keylabel_set(1,keylabel_minus);
	}
}

// ---------------------- Data Handling

void dataToNibbles(){
	// if there is data displayed in menu entry it is first converted in littel nibbles[0...7] that are displayed and can be edited

	switch(dataType){
	case MENU_T_VARBYTE:
		nibble[0] = dataEntry >> 4;
		nibble[1] = dataEntry & 0x0F;
		// nibbleCount = 2;
		break;
	case MENU_T_VARMIDICHAN:
		// nibbleCount = 2;
		if (dataEntry >= MIDI_CHANNEL_COUNT) {
			nibble[0] = 0xFF;
		} else {
			nibble[0] = dataEntry  + 1; // dataEntry: midi-channel 0x00..0x0F, nibbles: 01..16, channel: none= 0xFF
		}
		break;
	case MENU_T_VARNOTE:
		// nibbleCount = 2;
		if ((dataEntry & 0x80) != 0) {
			nibble[0] = 0x0;
			nibble[1] = 0xFF; // note "none" only in octave
		} else {
			nibble[1] = 0; // octave, 0=-1 "m", 1=0, 2=1
			while (dataEntry >= 12){
				nibble[1]++;
				dataEntry -= 12;
			}
			nibble[0] = dataEntry; // note, 0=c, 1=c#
		}
		break;
	case MENU_T_VARMODBIT:
		// nibbleCount = 3;
		nibble[0] = dataEntry >> 5; // module in Bit7-5
		dataEntry &= 0x1F;
		nibble[1] = 0;
		while (dataEntry >= 10){
			nibble[1]++;
			dataEntry -= 10;
		}
		nibble[2] = dataEntry;
		break;
	case MENU_T_VARDEC:
		// nibbleCount = 3;
		nibble[0] = 0;
		nibble[1] = 0;
		while (dataEntry >= 100){
			nibble[0]++;
			dataEntry -= 100;
		}
		while (dataEntry >= 10){
			nibble[1]++;
			dataEntry -= 10;
		}
		nibble[2] = dataEntry;
		break;
	case MENU_T_VARMANUAL:
		// III,II,I,P, - (=0xFF)
		if (dataEntry > MANUAL_P){
			nibble[0] = MANUAL_NONE;
		} else {
			nibble[0] = dataEntry;
		}
		break;
	case MENU_T_VARSECTION:
		// 0..3
		if (dataEntry > 3){
			nibble[0] = 3;
		} else {
			nibble[0] = dataEntry;
		}
		break;
	case MENU_T_VARONOFF:
		// on/off
		nibble[0] = dataEntry;
		break;
	case MENU_T_VARBIN:
	case MENU_T_VARBINREG:
		for (uint8_t i = 0; i<8; i++){
			nibble[i] = (dataEntry & 0x80) != 0 ? 1 : 0;
			dataEntry = dataEntry << 1;
		}
		break;
	case MENU_T_VARLONG:
		;
		uint8_t i = 8;
		uint8_t * pWordByte = (uint8_t *) & (dataEntry32);
		while (i-- != 0){
			nibble[i--] = *pWordByte & 0x0F;
			nibble[i] = *pWordByte++ >> 4;
		}
		break;
	case MENU_T_VARPROG:
		nibble[0] = (dataEntry >> 3) + 1;
		nibble[1] = (dataEntry & 7) + 1;
		break;
	case MENU_T_VARREG:
		// 0...63,0xFF -> 1...64,0
		dataEntry++;
		nibble[0] = 0;
		while (dataEntry >= 10){
			nibble[0]++;
			dataEntry -= 10;
		}
		nibble[1] = dataEntry;
		break;
	}
}

void nibbleToLCDstring(){
	// output nibbles to LCD buffer
	switch(dataType){
	case MENU_T_VARBYTE:
		lcdData[0] = nibbleToChr(nibble[0]);
		lcdData[1] = nibbleToChr(nibble[1]);
		lcdData[2] = 0;
		break;
	case MENU_T_VARMIDICHAN:
		lcdData[0] = 'C';
		lcdData[1] = 'h';
		if (nibble[0] == MIDI_CHANNEL_NONE) {
			lcdData[2] = ' ';
			lcdData[3] = '-';
		} else {
			if (nibble[0] > 9) {
				lcdData[2] = '1';
				lcdData[3] = nibbleToChr(nibble[0]-10);
			} else {
				lcdData[2] = ' ';
				lcdData[3] = nibbleToChr(nibble[0]);
			}
		}
		lcdData[4] = 0;
		break;
	case MENU_T_VARNOTE:
		if ((nibble[0] == 0xFF) || (nibble[1] == 0xFF)) {
			lcdData[0] = 'n';
			lcdData[1] = 'o';
			lcdData[2] = 'n';
			lcdData[3] = 'e';
			lcdData[4] = 0;
		} else {
			lcdData[1] = '_';
			if (nibble[0] == 11){
				lcdData[0] = 'H';
			} else if (nibble[0] < 5) {
				// C..E
				lcdData[0] = 'C' + (nibble[0] >> 1);
				if ((nibble[0] & 0x01) == 0x01) {
					lcdData[1] = '#';
				}
			} else {
				// F..A#
				lcdData[0] = 'F' + ((nibble[0]-5) >> 1);
				if ((nibble[0] & 0x01) == 0x00) {
					lcdData[1] = '#';
				}
				if (lcdData[0] == 'H'){
					lcdData[0] = 'A';
				}
			}
			if (nibble[1] == 0){
				lcdData[2] = 'm';
			} else if (nibble[1] < 12) {
				lcdData[2] = nibbleToChr(nibble[1]-1);
			} else {
				lcdData[2] = '-';
			}
			lcdData[3] = 0;
		}
		break;
	case MENU_T_VARMODBIT:
		lcdData[0] = 'M';
		lcdData[1] = nibbleToChr(nibble[0]);
		lcdData[2] = 'B';
		lcdData[3] = nibbleToChr(nibble[1]);
		lcdData[4] = nibbleToChr(nibble[2]);
		lcdData[5] = 0;
		break;
	case MENU_T_VARDEC:
		lcdData[0] = nibbleToChr(nibble[0]);
		lcdData[1] = nibbleToChr(nibble[1]);
		lcdData[2] = nibbleToChr(nibble[2]);
		lcdData[3] = 0;
		break;
	case MENU_T_VARMANUAL:
		#ifndef MENU_MANUAL_ARAB
			if (nibble[0] == MANUAL_NONE){
				lcdData[0] = '-';
				lcdData[1] = '-';
				lcdData[2] = '-';
				lcdData[3] = '\0';
			} else if (nibble[0] == MANUAL_P){
				lcdData[0] = 'P';
				lcdData[1] = '\0';
			} else {
				lcdData[0] = 'I';
				if (nibble[0] < MANUAL_I) {
					lcdData[1] = 'I';
					if (nibble[0] < MANUAL_II) {
						lcdData[2] = 'I';
						lcdData[3] = '\0';
					} else {
						lcdData[2] = '\0';
					}
				} else {
					lcdData[1] = '\0';
				}
			}
		#else
			if (nibble[0] <= MANUAL_I){
				lcdData[0] = '3'-nibble[0];
				lcdData[1] = '\0';
			} else if (nibble[0] == MANUAL_P){
				lcdData[0] = 'P';
				lcdData[1] = '\0';
			} else {
				// V 0.56 "-" instead of "none"
				lcdData[0] = '-';
				lcdData[1] = '\0';
			}
		#endif
		break;
	case MENU_T_VARSECTION:
		lcdData[0] = nibble[0] + '0';
		lcdData[1] = '\0';
		break;
	case MENU_T_VARONOFF:
		if (nibble[0] == FALSE) {
			lcdData[0] = 'A';
			lcdData[1] = 'u';
			lcdData[2] = 's';
		} else {
			lcdData[0] = 'E';
			lcdData[1] = 'i';
			lcdData[2] = 'n';
		}
		lcdData[3] = '\0';
		break;
	case MENU_T_VARBIN:
	case MENU_T_VARLONG:
		for (uint8_t i=0; i<8; i++){
			lcdData[i] = nibbleToChr(nibble[i]);
		}
		break;
	case MENU_T_VARBINREG:
		for (uint8_t i=0; i<8; i++){
			lcdData[i] = (nibble[i] == 0) ? 'o' : 'I';
		}
		break;
	case MENU_T_VARPROG:
		lcdData[0] = '@' +nibble[0];
		lcdData[1] = '0' +nibble[1];
		lcdData[2] = '\0';
		break;
	case MENU_T_VARREG:
		if ((nibble[0] | nibble[1]) == 0) {
			// 0 (data 0xFF: none
			lcdData[0] = '-';
			lcdData[1] = '-';
		} else {
			lcdData[0] = '0' +nibble[0];
			lcdData[1] = '0' +nibble[1];
		}
		lcdData[2] = '\0';
		break;
	}
}

void LCDStringOut(){
	// output lcd buffer to LCD
	lcd_goto(MENU_LCD_CURSOR_DATA);
	uint8_t* pData = lcdData;
	uint8_t outdata;
	for (uint8_t i = 0; i < MENU_LCD_DATALEN; i++){
		if ((outdata = *pData) == '\0'){
			outdata = ' ';
		} else {
			pData++;
		}
		lcd_putc(outdata);
	}
}

uint8_t nibbleCheckOvfl(int8_t myNibble){
	// check if signed nibble has underflow (-1 -> 9) or overflow (10 -> 0) and return corrected value
	if (myNibble > 9) {
		return (0);
	} else if (myNibble < 0) {
		return (9);
	}
	return myNibble;
}

void nibbleChange(uint8_t nibbleNr , int8_t addValue){
	// addValue only +1 and -1 to nibble;
	// checks for valid nibbles after change
	uint8_t allowInvalid = (currentMenu->menuFlags & MENU_FLAG_ALLOWINVALD);
	switch(dataType){
		case MENU_T_VARBYTE:
		case MENU_T_VARLONG:
			nibble[nibbleNr] = (nibble[nibbleNr] + addValue) & 0x0F;
			break;
		case MENU_T_VARMIDICHAN:
			if (allowInvalid == 0) {
				// 1 -> 2 -> ... -> 16 -> 1
				if ((addValue == 1)	 && (nibble[0] >= 16)){
					nibble[0] = 1;
				} else if ((addValue == -1)	 && ((nibble[0] <= 1) || (nibble[0] > 16))){
					// V 0.58 failsafe if nibble[0] was invalid
					nibble[0] = 16;
				} else {
					nibble[0] = nibble[0] + addValue;
				}
			} else {
				// 1 -> 2 -> ... -> 16 -> 0xFF -> 1
				if ((addValue == 1)	 && (nibble[0] == 16)){
					nibble[0] = 0xFF;
				} else if ((addValue == 1)	 && (nibble[0] == 0xFF)){
					nibble[0] = 1;
				} else if ((addValue == -1)	 && (nibble[0] == 0xFF)){
					nibble[0] = 16;
				} else if ((addValue == -1)	 && (nibble[0] == 1)){
					nibble[0] = 0xFF;
				} else {
					nibble[0] = nibble[0] + addValue;
				}
			}
			break;
		case MENU_T_VARNOTE:
			if (nibble[1] == 0xFF) {
				// if note none allow editin octave only
				nibbleNr = 1;
			}
			if (nibbleNr == 0){
				// note
				uint8_t newNote = nibble[0];
				if (newNote >= 12){
					// should not happen here
					newNote = 0;
				} else if ((newNote == 11) && (addValue == 1)) {
					newNote = 0;
				} else if ((newNote == 0) && (addValue == -1)) {
					newNote = 11;
				} else  {
					newNote = newNote+addValue;
				}
				nibble[0] = newNote;
			} else {
				// octave
				uint8_t octave = nibble[1];
				if (allowInvalid == 0){
					if ((octave == 0) && (addValue == -1)){
						octave = 10;
					} else if ((octave == 10) && (addValue == 1)){
						octave = 0;
					} else {
						octave = octave + addValue;
					}
				} else {
					if ((octave == 0) && (addValue == -1)){
						octave = 0xFF;
					} else if ((octave == 10) && (addValue == 1)){
						octave = 0xFF;
					} else if ((octave == 0xFF) && (addValue == 1)){
						octave = 0;
					} else if ((octave == 0xFF) && (addValue == -1)){
						octave = 10;
					} else {
						octave = octave + addValue;
					}
				}
				nibble[1] = octave;
			}
			if ((nibble[0] != 0xFF) && (nibble[1] != 0xFF)) {
				uint8_t newOctNote;
				newOctNote = nibble[0] + 12 * nibble[1];
				if (newOctNote > 127){
					nibble[0] = 7;
					nibble[1] = 10; // 10*12+7 = 127 = max Note
				}
			}
			break;
		case MENU_T_VARMODBIT:
			if (nibbleNr == 0) {
				// modul Nr
				nibble[0] = (nibble[0] + addValue) & 0x07;
			} else {
				nibble[nibbleNr] = nibbleCheckOvfl(nibble[nibbleNr] + addValue);
				int8_t bitNr = 10 * nibble[1] + nibble[2];
				if (bitNr > 31){
					nibble[1] = 3;
					nibble[2] = 1;
				} else if (bitNr < 0){
					nibble[1] = 0;
					nibble[2] = 0;
				}
			}
			break;
		case MENU_T_VARDEC:
			nibble[nibbleNr] = nibbleCheckOvfl(nibble[nibbleNr] + addValue);
			int16_t newDec = 100 * nibble[0] + 10 * nibble[1] + nibble[2];
			if (newDec > 255){
				nibble[0] = 2;
				nibble[1] = 5;
				nibble[2] = 5;
			}
			break;
		case MENU_T_VARMANUAL:
			if (allowInvalid) {
				nibble[nibbleNr] = nibble[nibbleNr] + addValue;
				// only handle MANUAL_NONE - 1 and MANUAL_P + 1
				if (nibble[nibbleNr] == MANUAL_P+1) {
					// overflow from manual P +1
					nibble[nibbleNr] = MANUAL_NONE;
				} else if (nibble[nibbleNr] == MANUAL_NONE-1) {
					nibble[nibbleNr] = MANUAL_P;
				}
			} else {
				if ((nibble[nibbleNr] == MANUAL_III) && (addValue == -1)){
					nibble[nibbleNr] = MANUAL_P;
				} else if ((nibble[nibbleNr] == MANUAL_P) && (addValue == 1)){
					nibble[nibbleNr] = MANUAL_III;
				} else {
					nibble[nibbleNr] = nibble[nibbleNr] + addValue;
				}
			}
			break;
		case MENU_T_VARSECTION:
			nibble[nibbleNr] = (nibble[nibbleNr] + addValue) & 0x03;
			break;
		case MENU_T_VARONOFF:
			nibble[0] = ~nibble[0];
			break;
		case MENU_T_VARBIN:
		case MENU_T_VARBINREG:
			nibble[nibbleNr] = ((addValue >> 1) & 0x01) ^ 0x01; // V 0.56 addval = 0xFF/0x01: instead of adding make +/-1 to 1 or 0
			break;
		case MENU_T_VARPROG:
			if (addValue  == 1) {
				nibble[nibbleNr] = (nibble[nibbleNr] & 0x07) + 1;
			} else {
				nibble[nibbleNr] = ((nibble[nibbleNr]-2) & 0x07) +1;
			}
			break;
		case MENU_T_VARREG:
			;
			int8_t myVal = nibble[0] * 10 + nibble[1];
			if (nibbleNr == 0) {
				// tens
				myVal += addValue * 10;
			} else {
				// ones
				myVal += addValue;
			}
			if (myVal < 0) {
				myVal = 0;
			} else if (myVal > 64) {
				myVal = 0;
			}
			nibble[0] = 0;
			while (myVal >= 10){
				nibble[0]++;
				myVal -= 10;
			}
			nibble[1] = myVal;
			break;
		// end switch
	}
}

void nibbleToData(){
	// after editing nibble[0...7] is converted to data back again
	// set dataEntry according to nibbles; checks valid range of dataEntry
	uint8_t tempb ;
	uint16_t temp;
	switch(dataType){
	case MENU_T_VARBYTE:
		dataEntry = (nibble[0] << 4) | (nibble[1] & 0x0F);
		break;
	case MENU_T_VARMIDICHAN:
		if ((nibble[0] == 0) || (nibble[0] > 16)) {
			// V 0.58 catch invalid values
			dataEntry = nibble[0];
		} else {
			dataEntry = nibble[0]-1;
		}
		break;
	case MENU_T_VARNOTE:
		if ((nibble[0] == 0xFF) || (nibble[1] == 0xFF)) {
			dataEntry = 0xFF;
		} else {
			dataEntry = 12 * nibble[1] + nibble[0];
		}
		break;
	case MENU_T_VARMODBIT:
		dataEntry = (nibble[0] << 5) & 0xE0;
		tempb = nibble[1] * 10 + nibble[2];
		if (tempb > 0x1F){
			dataEntry |= 0x1F;
		} else {
			dataEntry |= tempb;
		}
		break;
	case MENU_T_VARDEC:
		temp = nibble[0] * 100 + nibble[1] * 10 + nibble[2];
		if (temp > 255) {
			dataEntry = 255;
		} else {
			dataEntry = temp;
		}
		break;
	case MENU_T_VARMANUAL:
		dataEntry = nibble[0];
		if (dataEntry > MANUAL_P){
			dataEntry = MANUAL_NONE;
		}
		break;
	case MENU_T_VARSECTION:
		dataEntry = nibble[0] & 0x03;
		break;
	case MENU_T_VARONOFF:
		dataEntry = nibble[0];
		break;
	case MENU_T_VARBIN:
	case MENU_T_VARBINREG:
		dataEntry = 0;
		for (uint8_t i = 0; i<8; i++){
			dataEntry = dataEntry << 1;
			dataEntry = dataEntry + nibble[i];
		}
		break;
	case MENU_T_VARLONG:
		dataEntry32 = 0;
		uint8_t i = 8;
		uint8_t * pWordByte = (uint8_t *) & (dataEntry32);
		while (i-- != 0){
			// i points to nibble 7,5,3,1
			uint8_t tempByte = nibble[i--];
			tempByte += nibble[i] << 4; // nibble 6,4,2,0
			*pWordByte++ =  tempByte;
		}
		break;
	case MENU_T_VARPROG:
		dataEntry = (nibble[1]-1) | ((nibble[0]-1) << 3);
		break;
	case MENU_T_VARREG:
		dataEntry = (nibble[0] * 10 + nibble[1]) - 1;
		break;
	}
}

void menuTextOutVar(char* pChar, char finalChar){
	// output text and space up to MENU_TEXTLEN but first char after text is finalChar (for arrow)
	for (uint8_t i = 0; i < MENU_LCD_MENUTEXTLEN; i++){
		uint8_t outChar = *pChar;
		if (outChar == '\0'){
			outChar = finalChar; // text is finished, print finalChar
			finalChar = ' '; // after that clear with spaces
		} else {
			pChar++; // proceed to next char only if it was not \0
		}
		lcd_putc(outChar);
	}
}


void menuTextOut(const __flash char* pChar, char finalChar){
	// output text and space up to MENU_TEXTLEN but first char after text is finalChar (for arrow)
	for (uint8_t i = 0; i < MENU_LCD_MENUTEXTLEN; i++){
		uint8_t outChar = *pChar;
		if (outChar == '\0'){
			outChar = finalChar; // text is finished, print finalChar
			finalChar = ' '; // after that clear with spaces
		} else {
			pChar++; // proceed to next char only if it was not \0
		}
		lcd_putc(outChar);
	}
}

void menuParentMenuToLCD(){
	// show menu title = name of parent menu left to current menu entry. in top menu show "Menu"
	lcd_goto(MENU_LCD_CURSOR_PARENT);
	if (menuStackIndex == 0) {
		// Topmenu
		menuTextOut(pMenuTopTitle, MENU_PARENTMENU_DELIM) ;
	} else {
		// Menu with parent
		const __flash Menu_t* pTopMenu = menuStack[menuStackIndex-1];
		menuTextOut(pTopMenu->text, MENU_PARENTMENU_DELIM ); // ':'
	}
}

void menuCurrMenuToLCD(){ // text out of current Menu Title to LCD and delimiters for left and right
	// set cursor to menu
	lcd_goto(MENU_LCD_CURSOR_MENU-1); // go 1 position before title
	uint8_t bound = currentMenu->menuType & MENU_T_BOUNDARY_MASK;
	// out arrow if you can navigate left
	if (bound == MENU_T_LEFTBOUND) {
		lcd_putc(MENU_LEFT_BOUND_CHAR);
		keylabel_clr(2);
	} else {
		lcd_putc(MENU_LEFT_SEL);
		softkeyLeft();
	}
	char rightDelimiter;
	// out arrow if you can navigate right
	if (bound == MENU_T_RIGHTBOUND) {
		rightDelimiter = MENU_RIGHT_BOUND_CHAR;
		keylabel_clr(3);
	} else {
		rightDelimiter = MENU_RIGHT_SEL;
		softkeyRight();
	}
	softkeyUp();
	menuCheckArrowDown();
	menuTextOut(currentMenu->text, rightDelimiter); // prints Title and arrow to the right
	keylabel_toLCD();
	menuCursorSetMenu();
}

void menuDisplayValue(){
	// convert data to nibbled, display them and set info from NibbleInfo
	if ((currentMenu->menuType  & MENU_T_REMOVEBOUND_MASK) > MENU_T_MENU){
		dataToNibbles();
		nibbleToLCDstring();
		LCDStringOut();
	}
}

void menuCursorSetDataNibble(){
	//if ((nibbleIndex != NIBBLE_NONE) && (nibbleIndex < MENU_MAX_NIBBLE)) {
		lcd_goto(MENU_LCD_CURSOR_DATA + pNibbleInfo->nibblePos[nibbleIndex]);
		if (nibbleIndex < pNibbleInfo->nibbleCount - 1) {
			softkeyRight();
		} else {
			keylabel_clr(3);
		}
		if (nibbleIndex > 0) {
			softkeyLeft();
		} else {
			keylabel_clr(2);
		}
		softkeyPlus();
		softkeyMinus();
		keylabel_toLCD();
	//}
}

static inline void menuCursorSetData(){
	//if ((nibbleIndex != NIBBLE_NONE) && (nibbleIndex < MENU_MAX_NIBBLE)) {
	lcd_goto(MENU_LCD_CURSOR_DATA);
	//}
}

void menuCursorSetExtra(){
	// position for extra Data while editing Menu
	lcd_goto(MENU_LCD_CURSOR_EXTRA);
}

void menuCursorSetMenu(){
	// set blinking cursor to first char of menu title
	lcd_goto(MENU_LCD_CURSOR_MENU);
}

static inline void menuCursorSetParent(){
	lcd_goto(MENU_LCD_CURSOR_PARENT);
}

void menuClearExtraDisp(){
	menuCursorSetExtra();
	lcd_blank(MENU_LCD_EXTRALEN);
}

void menu_ClearDataDisp(){
	menuCursorSetData();
	lcd_blank(MENU_LCD_DATALEN);
}

void menuClearMenuDisp(){
	menuCursorSetParent();
	lcd_blank(MENU_LCD_MENUTEXTLEN);
	menuCursorSetMenu();
	lcd_blank(MENU_LCD_MENUTEXTLEN);
}

void menu_ClearAllDisp(){
	menuClearMenuDisp();
	menu_ClearDataDisp();
	menuClearExtraDisp();
}

void menuCheckArrowDown(){
	uint8_t menuType = currentMenu->menuType & MENU_T_REMOVEBOUND_MASK;
	// change Arrow down symbol
	if (menuType == MENU_T_MENU) {
		softkeyDown();
	} else if (currentMenu->pVar != NULL){
		// variable that can be edited
		if (menuType == MENU_T_VARONOFF){
			// onOff
			if (*(currentMenu->pVar) == 0){
				softkeyOn();
			} else {
				softkeyOff();
			}
		} else {
			// other variable
			softkeyDown();
		}
	} else {
		// variable that can't be edited
		keylabel_clr(1); // no "down" arrow
	}
	// is sent to LCD later
}

void menuItemChanged(){
	// called when currentMenu is updated within same menu to display meneu text and data if appropriate / clear data when none to display
	// init pNibbleInfo, dataType, dataEntry and print Data or clear data space
	// TIMER_DEACTIVATE(TIMER_MENUDATA_LCDCLEAR) // if timer had been activated to clear data line: abort timer -> V0.76 cancelled
	uint8_t menuType = currentMenu->menuType & MENU_T_REMOVEBOUND_MASK;
	if ((menuType > MENU_T_MENU) && (currentMenu->pVar != NULL)) {
		// only if menu item is data and there is a pointer to data value
		pNibbleInfo = &(nibbleInfo[(currentMenu->menuType & MENU_T_REMOVEBOUND_MASK) - MENU_T_MENU]);
		nibbleCount = pNibbleInfo->nibbleCount;
		dataType = (currentMenu->menuType & MENU_T_REMOVEBOUND_MASK);
		uint8_t* pData = currentMenu->pVar + (((currentMenu->menuFlags & MENU_FLAG_DATAOFFSET) != 0) ? DataAdressOffset : 0); // get data from pointer and offset
		if ((currentMenu->menuType & MENU_T_REMOVEBOUND_MASK) == MENU_T_VARLONG) {
			dataEntry32 = * (uint32_t *) pData;
		} else {
			dataEntry = *pData;
		}
		menuDisplayValue();
	} else {
		menu_ClearDataDisp();
		pNibbleInfo = &(nibbleInfo[0]);
	}
	menuCheckArrowDown();
	menuCursorSetMenu();
}

void menuResetVars(){
	// reset all vars that mihgt be used in this menu level
	menuMidiChan = 0;
	menuSection = 0;
	DataAdressOffset = 0;
}

uint8_t menu_ProcessMessage(uint8_t message){
	// called when there is a message to be processed. Exits when new message is awaited
	// status defined in
	// returns false if menu wants further input, true if menu was left
	uint8_t menuFinished; // FALSE if regular exit from processMenu, TRUE if Key Up in top level menu  is pressed
	menuFinished = FALSE;
	lcd_cursosblink();
	if (((currentMenu->menuType & MENU_T_REMOVEBOUND_MASK) == MENU_T_MENU) || (nibbleIndex == NIBBLE_NONE)){
		// menu item  is menu or data and showing value only
		if ((currentMenu->menuFlags & MENU_FLAG_CLEAREXTRA) != 0) {
			menuClearExtraDisp();
			menuCursorSetMenu();
		}
		if (((currentMenu->menuFlags & MENU_FLAG_FNHANDLEMESSAGE) != 0) && (currentMenu->pFunc != NULL) && (nibbleIndex != NIBBLE_NONE)) {
			// only of menu item wants message and function defined and function still wants messages
			// function was already called with MESSAGEY_KEY_NONE, now next message handled by function
			if (currentMenu->pFunc (message) == TRUE) {
				// function still wants messages
				nibbleIndex = 0; // flag for function wants messages (0) or none (NIBBLE_NONE)
			} else {
				// function wants no more messages
				menuClearExtraDisp();
				menu_ClearDataDisp();
				menuCursorSetMenu();
				nibbleIndex = NIBBLE_NONE; // flag for function wants no more messages (NIBBLE_NONE)
				menuCurrMenuToLCD();
			}
		} else {
			// message handling is done here
			switch (message){
			case MESSAGE_KEY_RIGHT:
				// select right menu item
				if ((currentMenu->menuType & MENU_T_BOUNDARY_MASK) != MENU_T_RIGHTBOUND){
					// only if not at right border
					currentMenu++;
					menuItemChanged();
					menuCurrMenuToLCD();
				}
				break;
			case MESSAGE_KEY_LEFT:
				// select left menu item
				if ((currentMenu->menuType & MENU_T_BOUNDARY_MASK) != MENU_T_LEFTBOUND){
					// only if not at right border
					currentMenu--;
					menuItemChanged();
					menuCurrMenuToLCD();
				}
				break;
			case MESSAGE_KEY_UP:
			case MESSAGE_KEY_ESC:
				// goto parent menu
				if ((currentMenu->menuFlags & MENU_FLAG_MENU_SOFTKEY) != 0) {
					// selection of softkey was aborted
					menuVMenuSoftKey = NULL;
				}
				if (menuStackIndex > 0){
					// only if there is a parent menu: back to parent
					currentMenu = menuStack[--menuStackIndex];
					if (currentMenu->pOnExitFunc != NULL){
						// exit function supplied in parent?
						currentMenu->pOnExitFunc (0);
					}
					menuClearExtraDisp();
					menuParentMenuToLCD();
					menuCurrMenuToLCD();
					// menuResetVars();
					menuItemChanged();
				} else {
					menuFinished = TRUE;
					keylabel_clr(0);
					keylabel_clr(1);
					keylabel_clr(2);
					keylabel_clr(3);
					keylabel_toLCD();
					lcd_cursoroff();
				}
				break;
			case MESSAGE_KEY_DOWN:
			case MESSAGE_KEY_SEL:
				// enter child menu or edit value
				if ((currentMenu->menuType & MENU_T_REMOVEBOUND_MASK) > MENU_T_MENU) {
					// Data Item selected
					if (currentMenu->pFunc != NULL){
						currentMenu->pFunc(message);
						menuItemChanged();
					}
					if (((currentMenu->menuFlags & MENU_FLAG_READONLY) == 0) && (currentMenu->pVar) != NULL){
						if ((currentMenu->menuType & MENU_T_REMOVEBOUND_MASK) == MENU_T_VARONOFF){
							// special case: On Off variable: SEL/CURSOR DOWN = change status
							nibbleChange(0,1); // there is only one nibble: change
							nibbleToData();
							*(currentMenu->pVar) = dataEntry;
							menuDisplayValue();
							menuCheckArrowDown(); // update OnOff
							keylabel_toLCD();
							menuCursorSetMenu();
							// V0.60 also provide onExitFunction here!
							if (currentMenu->pOnExitFunc != NULL){
								// exit function supplied in parent?
								currentMenu->pOnExitFunc (0);
							}
						} else {
							// Data is not readonly and there is a pointer to data
							nibbleIndex = 0; // indicates that data is to be edited
							menuCursorSetDataNibble();
						}
					} // else do nothing
				} else {
					// Menu selected
					nibbleIndex = NIBBLE_NONE; // indicates that we are not editing
					if ((currentMenu->menuFlags & MENU_FLAG_MENU_SOFTKEY) != 0) {
						// this is a softkey function. Do not enter now or call function but store
						menuVMenuSoftKey = currentMenu;
						if (menuStackIndex > 0){
							// only if there is a parent menu: back to parent (this usually is true)
							currentMenu = menuStack[--menuStackIndex];
							if (currentMenu->pOnExitFunc != NULL){
								// exit function supplied in parent?
								currentMenu->pOnExitFunc (0);
							}
							menuClearExtraDisp();
							menuParentMenuToLCD();
							menuCurrMenuToLCD();
							// menuResetVars();
							menuItemChanged();
						}
					} else {
						// no softkey
						if (currentMenu->pFunc != NULL) {
							// call menu function if supplied
							if ((currentMenu->menuFlags & MENU_FLAG_FNHANDLEMESSAGE) != 0) {
								// this function wants message and return TRUE if further message is wanted (currently: no message)
								// first after SEL call always mit MESSAGE_KEY_NONE
								if (currentMenu->pFunc (MESSAGE_KEY_NONE) == TRUE) {
									nibbleIndex = 0; // flag: function wants more messages
								} else {
									// function finished, wants no more messages
									menuClearExtraDisp();
									menu_ClearDataDisp();
									menuCursorSetMenu();
									nibbleIndex = NIBBLE_NONE;
								}
								// we don't set cursor because function is supposed to do so
							} else {
								// this function does not want message, just call it
								currentMenu->pFunc (MESSAGE_KEY_SEL); // MESSAGE_KEY_SEL to show that func is called from menu
								menuCursorSetMenu();
							}
						}
						if (currentMenu->pMenu != NULL){
							// open submenu if supplied
							if (menuStackIndex < MENU_MAX_STACK) {
								menuStack[menuStackIndex++] = currentMenu;
								if (((currentMenu->menuFlags & MENU_FLAG_ENTER_STORED_MENU) != 0) && (menuVMenuSoftKey != NULL)) {
									// enter stored menu item in menuVMenuSoftKey
									currentMenu = menuVMenuSoftKey;
								} else {
									// usually enter menu item
									currentMenu = currentMenu->pMenu;
								}
								menuClearExtraDisp();
								menuParentMenuToLCD();
								menuCurrMenuToLCD();
								//menuResetVars();
								menuItemChanged();
							}
						}
					}
				}
				break;
			} // switch
		} // else
	} else {
		// MENU_T_VAR and editing (nibbleIndex != NIBBLE_NONE)
		switch (message){
		case MESSAGE_KEY_RIGHT:
			// cursor right
			if (nibbleIndex < pNibbleInfo->nibbleCount - 1){
				nibbleIndex++;
				menuCursorSetDataNibble();
			}
			break;
		case MESSAGE_KEY_LEFT:
			// cursor left
			if (nibbleIndex > 0){
				nibbleIndex--;
				menuCursorSetDataNibble();
			}
			break;
		case MESSAGE_KEY_UP:
			// increment value
			nibbleChange(nibbleIndex,1);
			nibbleToData();
			menuDisplayValue();
			if ((dataType == MENU_T_VARBIN) || (dataType == MENU_T_VARBINREG)){
				// V 0.56 on bit-entry move to next bit
				if (nibbleIndex < pNibbleInfo->nibbleCount - 1){
					nibbleIndex++;
				}
			}
			menuCursorSetDataNibble();
			break;
		case MESSAGE_KEY_DOWN:
			// decrement value
			nibbleChange(nibbleIndex,-1);
			nibbleToData();
			menuDisplayValue();
			if ((dataType == MENU_T_VARBIN) || (dataType == MENU_T_VARBINREG)) {
				if (nibbleIndex < pNibbleInfo->nibbleCount - 1){
					nibbleIndex++;
				}
			}
			menuCursorSetDataNibble();
			break;
		case MESSAGE_KEY_SEL:
			// update var, back to showing
			nibbleToData();
			if (currentMenu->pVar != NULL){
				uint8_t* pData = (currentMenu->pVar) + (((currentMenu->menuFlags & MENU_FLAG_DATAOFFSET) != 0) ? DataAdressOffset : 0);
				if ((currentMenu->menuType & MENU_T_REMOVEBOUND_MASK) == MENU_T_VARLONG) {
					* (uint32_t *) pData = dataEntry32;
				} else {
					*pData = dataEntry;
				}
			}
		case MESSAGE_KEY_ESC: // constinued from SEL -> but different to lines ahead: don't change var
			if (currentMenu->pOnExitFunc != NULL){
				currentMenu->pOnExitFunc (message);
			}
			nibbleIndex = NIBBLE_NONE;
			menuCurrMenuToLCD();
			menuItemChanged();
			break;
		}
	}
	return menuFinished;
}

void menudeleteMainMessage(){
	lcd_message_clear();
}

void menu_deleteMessage(){
	if (displayMessageArea == MENU_DISPLAY_AREA_EXTRA_AND_DATA) {
		menuClearExtraDisp();
		menu_ClearDataDisp();
	} else if (displayMessageArea == MENU_DISPLAY_AREA_EXTRA) {
		menuClearExtraDisp();
	} else if (displayMessageArea == MENU_DISPLAY_AREA_DATA) {
		menu_ClearDataDisp();
	} else {
		menudeleteMainMessage();
	}
}

void menu_DisplayMainMessage(const char* pMessage){
	uint8_t saveCursor = lcd_cursorPos;
	uint8_t textLen = get_StrLen(pMessage);
	lcd_goto(MENU_LCD_CURSOR_MAINMESSAGE);
	lcd_blank((MENU_LCD_LEN_MAINMESSAGE - textLen) >> 1);
	lcd_puts(pMessage);
	lcd_blank(MENU_LCD_CURSOR_MAINMESSAGE + MENU_LCD_LEN_MAINMESSAGE - lcd_cursorPos);
	lcd_goto(saveCursor);
	TIMER_SET(TIMER_MESSAGE_LCDCLEAR,TIMER_MENUDATA_LCDCLEAR_MS);
	displayMessageArea = MENU_DISPLAY_AREA_MAIN;
}

//**************************************** SOFTKEYS ****************************************

uint8_t SoftKeyFunctionOK(MenuFunc_t  softKeyFunc){
	// check if address of softkey func is contained in menu_selFunc
	uint8_t functionCount = sizeof(menu_selFunc) / sizeof(menu_selFunc[0]);
	for (uint8_t i = 0; i < functionCount; i++){
		if (menu_selFunc[i].pFunc == softKeyFunc){
			return TRUE;
		}
	}
	return FALSE;
}

uint8_t getSoftKeyIndex(const __flash Menu_t* pSelMenuSoftKey){
	uint8_t result = 0;
	do {
		if (pSelMenuSoftKey == &(menu_selFunc[0])) {
			return result; // fits exactly, return index
		} else if (pSelMenuSoftKey < &(menu_selFunc[0])) {
			return SOFTKEYINDEX_NONE; // dows not fit, return invalid index
		}
		pSelMenuSoftKey--;
		result++; // max 256 searches
	} while (result != 0);
	return SOFTKEYINDEX_NONE; // here result is invalid index
}

void init_SoftKeys(){
	if (eeprom_ReadSoftkeys() == EE_LOAD_ERROR){
		// softkeys could not be loaded from eeprom, clear
		for (uint8_t i = 0; i<MENU_SOFTKEY_COUNT; i++){
			soft_KeyMenuIndex[i] = SOFTKEYINDEX_NONE;
			soft_KeyMenu[i].pSelMenu = NULL;
		}
		// EEprom info for softkey not valid
		log_putError(LOG_CAT_EE,LOG_CATEE_SOFTKEY,0);
	}
	for (uint8_t i = 0; i<MENU_SOFTKEY_COUNT; i++){
		const uint8_t SoftKeyMenuListLen = sizeof(menu_selFunc) / sizeof(menu_selFunc[0]);
		if (soft_KeyMenuIndex[i] < SoftKeyMenuListLen){
			// should be valid index
			soft_KeyMenu[i].pSelMenu = &menu_selFunc[soft_KeyMenuIndex[i]];
		} else {
			soft_KeyMenu[i].pSelMenu = NULL;
			log_putError(LOG_CAT_EE,LOG_CATEE_SOFTKEY,(i+1) | 0x10);
		}
	}
}

void softKey_Set(const __flash Menu_t* pSelMenuSoftKey, uint8_t nrSoftKey){
	if (nrSoftKey < MENU_SOFTKEY_COUNT) {
		if ((pSelMenuSoftKey != NULL) && ((pSelMenuSoftKey->menuType & MENU_T_REMOVEBOUND_MASK) == MENU_T_MENU) && ((pSelMenuSoftKey->menuFlags & MENU_FLAG_MENU_SOFTKEY) != 0)){
			soft_KeyMenu[nrSoftKey].pSelMenu = pSelMenuSoftKey;
			soft_KeyMenuIndex[nrSoftKey] = getSoftKeyIndex(pSelMenuSoftKey);
		} else {
			soft_KeyMenu[nrSoftKey].pSelMenu = NULL;
			soft_KeyMenuIndex[nrSoftKey] = SOFTKEYINDEX_NONE; // point to <none>
		}
	}
}

void softKeys_toLCD(){
	for (uint8_t i = 0; i<MENU_SOFTKEY_COUNT; i++){
		if ((soft_KeyMenu[i].pSelMenu == NULL) || (soft_KeyMenu[i].pSelMenu->pString == NULL)){
			keylabel_clr(i);
		} else {
			keylabel_set(i,(soft_KeyMenu[i].pSelMenu->pString)); // string for Softkey (may be shorter!) is pointed to by pVar but is in flash
			if (soft_KeyMenu[i].pSelMenu->pFunc != NULL){
				// function can be called
				keylabel_statcheck(i,soft_KeyMenu[i].pSelMenu->pFunc(0)== MENU_SOFTKEY_FUNC_RETURN_STATUS_ON ? TRUE : FALSE); // call function with arg=0 to get status
			}
		}
	}
	keylabel_toLCD();
}

uint8_t softKey_MessageKey_ToSoftKeyNr(uint8_t messageKey){
	switch (messageKey){
		case MESSAGE_KEY_1:
			return 0;
		case MESSAGE_KEY_2:
			return 1;
		case MESSAGE_KEY_3:
			return 2;
		case MESSAGE_KEY_4:
			return 3;
	}
	return MESSAGE_KEY_NONE;
}

uint8_t softKey_Execute(uint8_t nrSoftKey, uint8_t myMessage){
	// returns TRUE if softkey is handled, false if only a menu is displayed
	if (nrSoftKey < MENU_SOFTKEY_COUNT) {
		// softkey nr is valid
		const __flash Menu_t* pSoftKeySelMenu = soft_KeyMenu[nrSoftKey].pSelMenu;
		if (pSoftKeySelMenu != NULL){
			// pointer given
			if (((pSoftKeySelMenu->menuType & MENU_T_REMOVEBOUND_MASK) == MENU_T_MENU) && ((pSoftKeySelMenu->menuFlags & MENU_FLAG_MENU_SOFTKEY) != 0)){
				if (pSoftKeySelMenu->pFunc != NULL)  {
					// Function supplied, call
					uint8_t softKeyFuncResult;
					softKeyFuncResult = pSoftKeySelMenu->pFunc(myMessage);
					// check if function return request toi change status in display
					if (softKeyFuncResult == MENU_SOFTKEY_FUNC_RETURN_STATUS_OFF){
						keylabel_statcheck(nrSoftKey, FALSE);
					} else if (softKeyFuncResult == MENU_SOFTKEY_FUNC_RETURN_STATUS_ON){
						keylabel_statcheck(nrSoftKey, TRUE);
					}
					keylabel_toLCD();
				}
				// points to menu entry of type softkey
				const __flash Menu_t* pSoftKeyExeMenu = pSoftKeySelMenu->pMenu; // destiation menu
				if (pSoftKeyExeMenu != NULL) {
					// pointer exists to menu
					menu_Init(pSoftKeyExeMenu, pSoftKeySelMenu->text);
					menu_InitLCD(); //display menu
					return FALSE; // show that we are in menu processing now
				}
			}
		}
	}
	return TRUE;
}

//--------------------------------------------------------------------------------------------------------

void menu_showPowerState(){
	uint8_t saveCursor = lcd_cursorPos;
	lcd_goto(MENU_LCD_CURSOR_STAT_PWR);
	lcd_putc(POWERSTAT_CHAR);
	lcd_goto(saveCursor);

}
