docdent/pipe/Pipe1/main.h

/*
 * main.h
 *
 * Created: 22.07.2019 08:57:01
 *  Author: Anwender
 */


#ifndef MAIN_H_
#define MAIN_H_

/*
0.55
eeprom_UpdateALL: update EEPROM in main() after init
menu: EEUPdate
power on via: module_StartPowerOn, module_PowerControl in main loop
Log of message pipe overflow
removed unused old edit functions from utils.h
eeprom restore
0.56
Text for Error Log
midi.h Error note onOff sent even though midi out channel unassigned
midi.h softcoupler off turns off all manual notes
menu.c changed entry for bin values (1/0) instead of (+/-)
main.c longpress of esc key clears all manual notes
menu.c Tasten Koppler
0.57
register storage changed, similar to manuals
couplers extended to 12
on set couplers reset corresponding inverse coupler
menu.c check for soft_coupler function assigned correctly
menu.c soft_coupler list changed
0.58
main.c Panic key extended functions: couplers off
menu.c OnOff Variables easier to edit
menu.c Save Programs in EEPROM
menu.c Save Softkeys in EEPROM
menu.c Improved message for menu and softkey
menu.c Show registers
midi.h Extend Program memory to coupplers
midi.h Midi IN Program Change accepted if channel is valid
midi.h MIDI Through SW for Notes, Program Change
0.59
midi.c Register Setting received as midi sysex
midi.c Setting to ignore program change on midi in
menu.c Clear Combination as Softkey
main.c Show received Program Change
0.60
serial.c Interface zu ESP8266 via USART3
menu.c bugfix: call onExitFunction when DataType is OnOff
menu.c Output HW Config including registers
0.61
MIDI out for manual additionally to PipeOut
coupler working for MIDI out manuals
0.62
EEPROM memory structure
0.63
MIDI Tx save command and do not transfer note on/off again
MIDI Tx Buffer set to 256
0.64
serial.c USB out from ArrayIndex to pointer, buffer set to 2k
serial.c MIDI out command reuse only if VelZero4Off
serial.c log MIDI in/out and pipe message to USB
hwtimer.c pipe_on/off() instead of direct pipe[].pipeOut handling in midi.c; menu.c still handles it directly!
menu.c USB is part of setup AND status menu now
0.65
hwtimer.c timerPipeProcess() ignore modules that are not tested corerctly
0.66
tiny input buffer for ESP data (4 bytes) so that commands from esp can contain more data
0.67
active sense tx timer reset when midi byte is sent
reset setn midi command from time to time
midi command from ESP (not yet tested)
0.68
menu textes
0.69
serial.c midi send/receive: do not update index on overflow
serial.c midi in buffer increased
0.70
menu: show imidi buffer usage
main: clear log on panic button
main: turn on power on panic button
0.71
program change in softkey menu and display in main
0.72
midi: program change also send to midi (out thru!)
main: display for program in left upper corner; also overrides Midi In display
0.73
midi: received program change sent to midi out through  even if thru in channel does not match


TODO
Show pressed keys
Save USB Status
Make USB Baudrate selectable
Coupler more accurate when more  than 1 source manual
Show Set of Registers
Program Change like viscount
Combination in selecteable Bank
Failsafe for keys from time to time
watchdog
log for events and input
Restore Menu display after panic button message
Restore Menu display after MEssage
Coupler for lowest bass note  only

*/



#endif /* MAIN_H_ */
