docdent/pipe/(commit log)

2019-07-28 Initial Commit V0.56
    Start
    [Din Lesewerte vom Pipie-Modul.xlsx, Menu.xlsx, schmitt-trigger simu.xlsx]
2019-07-28 V0.56
    Text for Error Log
    midi.h Error note onOff sent even though midi out channel unassigned
    midi.h softcoupler off turns off all manual notes
    menu.c changed entry for bin values (1/0) instead of (+/-)
    main.c longpress of esc key clears all manual notes
    menu.c Tasten Koppler
    [Midi.c, Midi.h, hwtimer.c, hwtimer.h, main.c, main.h, menu.c, utils.c]
2020-06-23 Doc schematics
